angelEmbeddedEra/rusefi-sti-2004/documents/2004 Pin out.jpeg

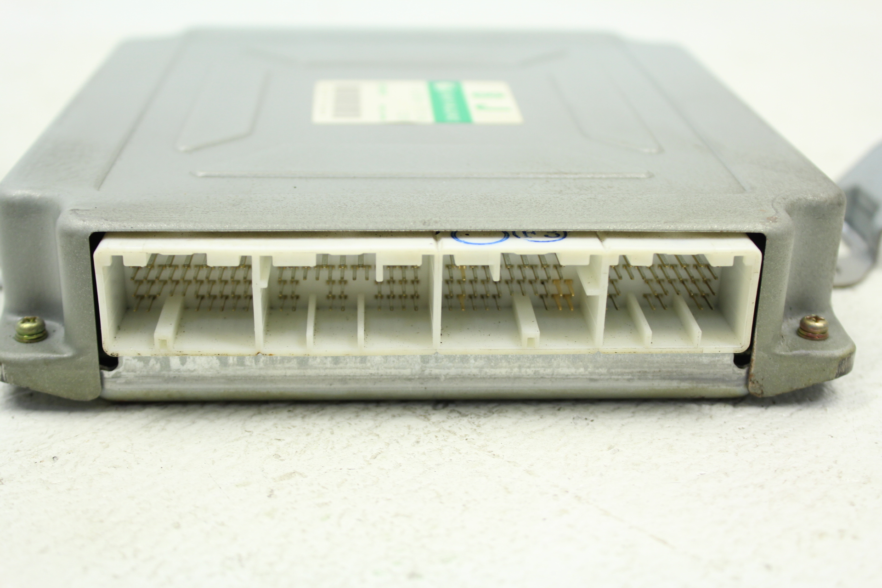
documents/2004 Pin out.jpeg
