angelEmbeddedEra/rusefi-sti-2004/README.md

# FAQ

Q: How do I build the board package?

A: ``hellen-create-board`` in this folder (EmbeddedEra/KiCad scripting/hellen; docker, KiCad 10). Output lands in ``boards/<board>-<rev>/``. There is no GitHub workflow.

Q: How do I get latest hellen-one?

A: ``git submodule update --remote hellen-one kicad6-libraries``, then rebuild and commit.

Q: I get error 'Cannot stat xx-yy__zz.kicad_pcb: No such file' but files are right there?

A: please do not use dashes and underscore symbols in file names.

Q: Automation says that aux_axis_origin is missing?

A: aux_axis_origin is required, please place it in the appropriate corner.

Q: I get "Cannot parse position" with negative value?

A: Please move origin point into left-bottom corner of the board since we cannot parse negative coordinates at the moment. See https://github.com/andreika-git/hellen-one/issues/349

Q: I am placing an order with JLCPCB and component orientation all looks wrong?!

A: See https://github.com/rusefi/uaefi/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

Q: What about firmware?

A: See https://github.com/rusefi/fw-custom-hellen144-f4 and https://github.com/rusefi/rusefi/wiki/Custom-Firmware

Q: Automation seems to work but files are not updated?

A: automation requires that you use default branch 'main'
