angelEmbeddedEra/rusefi-sti-2004/documents/pin-swap-m1.md

# M1 pin swap (owner-approved 2026-10-28)

Signals moved between equivalent Hellen mega-mcu144 module pins (same family only) to untangle routing:
75 ratsnest crossings → 0 on these families. **The rusEFI board pin mapping must follow this table.**

| Signal | Old module pin | New module pin |
|---|---|---|
| AC_RELAY | OUT_IO3 (E6) | OUT_IO5 (E7) |
| CRUISE_MAIN_LIGHT | OUT_IO5 (E7) | OUT_IO10 (E10) |
| CRUISE_SET_LIGHT | OUT_IO6 (E9) | OUT_IO9 (E11) |
| DIN_AUX1 | OUT_IO9 (E11) | OUT_IO8 (E22) |
| DIN_AUX2 | OUT_IO10 (E10) | OUT_IO7 (E23) |
| DIN_DEFOG | IO5 (N23) | IO1 (N16) |
| DIN_TEST_MODE | OUT_IO13 (E20) | OUT_IO4 (E21) |
| ETB_DIR | IO1 (N16) | IO3 (N21) |
| ETB_DIS | IO2 (N19) | IO5 (N23) |
| ETB_PWM | OUT_PWM2 (E17) | OUT_PWM7 (E25) |
| FAN_RELAY_1 | OUT_INJ6 (E32) | OUT_INJ1 (E19) |
| FAN_RELAY_2 | OUT_INJ7 (E33) | OUT_INJ2 (E18) |
| FP_CMD | IGN5 (W7) | IGN4 (W8) |
| INJ1 | OUT_INJ1 (E19) | OUT_INJ6 (E32) |
| INJ2 | OUT_INJ2 (E18) | OUT_INJ4 (E30) |
| INJ3 | OUT_INJ3 (E29) | OUT_INJ5 (E31) |
| INJ4 | OUT_INJ4 (E30) | OUT_INJ7 (E33) |
| MAIN_RELAY | OUT_INJ5 (E31) | OUT_INJ3 (E29) |
| MIL | OUT_IO1 (E8) | OUT_IO6 (E9) |
| O2_HEATER_REAR | OUT_IO2 (E12) | OUT_IO12 (E13) |
| OUT_IGN1 | IGN1 (W11) | IGN7 (W5) |
| OUT_IGN2 | IGN2 (W10) | IGN5 (W7) |
| OUT_IGN4 | IGN4 (W8) | IGN1 (W11) |
| PURGE | OUT_PWM7 (E25) | OUT_PWM2 (E17) |
| SPARE_IGN7 | IGN7 (W5) | IGN2 (W10) |
| SPARE_LS1 | OUT_IO7 (E23) | OUT_IO1 (E8) |
| SPARE_LS2 | OUT_IO8 (E22) | OUT_IO3 (E6) |
| SPARE_PWM3 | OUT_PWM3 (E16) | OUT_PWM1 (E27) |
| TACH | OUT_IO4 (E21) | OUT_IO2 (E12) |
| TGV_DIR | IO3 (N21) | IO2 (N19) |
| TGV_PWM | OUT_IO12 (E13) | OUT_IO13 (E20) |
| WG | OUT_PWM1 (E27) | OUT_PWM3 (E16) |

Generated by eeroute `tools/pin_swap.py --occupied-only` and applied with `tools/apply_pin_swap.py`.

## Routing result (eeroute, 2026-10-29)

The 32 moved nets were ripped and re-routed by eeroute (`--plan grid --ripup-plan yes --passes 2`,
teardrops on new vias, finishing pass). Same nets, same router, same settings:

| Board | Open connections on these 32 nets |
|---|---|
| Unswapped (master pinout, nets ripped) | 22 |
| Swapped (this branch) | **7** |
| Master as hand-finished | 8 |

No other net got worse and there is no new DRC finding versus the ripped start. Whole-board DRC
unconnected items: master 123, this branch 102. After a clean-up pass (via minimisation: 3 layer-change vias replaced by single-layer
paths) and one more short routing pass: **6 open** on these nets (PURGE now routed), whole-board
unconnected items 101; still open: DIN_DEFOG, O2_HEATER_REAR, OUT_IGN2, SPARE_LS1, SPARE_LS2, TACH. Ten new vias next to module keep-clear areas
on In3 have teardrops off (a teardrop there would violate the keep-clear).
