angelEmbeddedEra/rusefi-sti-2004/documents/ROUTING-PLAN.md

# Routing plan: rusefiSTI2004 rev B

Status 2026-10-14: placed, planes poured, stage 2 (high-current) routed. **156 connections to route** (233 counting Hellen module pad pairs), DRC 0 errors, schematic parity 0.
Procedure: SOP-021 step 9 (routing order). This file is the board-specific part: which nets, which layer, which width, in which order.

## Ground rules

- **Stackup (6 layers since 2026-10-14, owner):** JLC06161H-7628, 1.6 mm (`kicad-stackup JLC06161H-7628`).
  - L1 (F.Cu): parts and signals.
  - L2 (In1.Cu): solid GND. **Never route on L2.**
  - L3 (In2.Cu): mixed: signals plus a +12V_RAW pour. +12V_RAW is routed as tracks, so the pour is a bonus.
  - L4 (In3.Cu): signals (added when 44 connections around M1 would not fit on three layers).
  - L5 (In4.Cu): solid GND, the reference for the bottom layer.
  - L6 (B.Cu): signals.
  - Every Hellen module outline has a keepout on In3/In4 for tracks and pour: the module's own vias drill through all six layers in the merged board and are not in our KiCad file. Vias stay allowed (they already were on four layers).
  - `hellen-create-board` must map the modules' two inner layers to In1/In2 and pass In3/In4 straight through (the hellen-one merge only knew four layers).
- **45 degree corners only, never 90.**
  - Keep the router in its 45° posture (the default; `/` toggles posture and `Ctrl+/` the corner style), with free-angle mode off.
  - The design rule `45 degree corners only` (track_angle min 135) makes any bend sharper than 135° between connected segments a DRC error, so a 90° corner fails the gate.
- **Teardrops always.**
  - Every copper pad and via has curved teardrops switched on (Board Setup > Teardrops, plus the per-item flag `kicad-pcb-from-netlist` sets), including at track-width changes.
  - Before each stage's commit, `kicad-cli pcb drc --refill-zones --save-board` rebuilds them headless (kicad-autoroute does this on its last check); in the editor, Edit > Edit Teardrops does the same.
- **Track widths come from the net classes.** Use the router's net-class width, not a hand-typed one:

  | Class | Width | Via | Typical nets |
  |---|---|---|---|
  | Default | 0.20 mm | 0.6/0.3 | on-board logic |
  | Signal_Robust | 0.25 mm | 0.6/0.3 | sensor, switch and harness signals |
  | Power_500mA | 0.40 mm | 0.7/0.35 | low-current rails |
  | Power_1A | 0.60 mm | 0.8/0.4 | injectors, solenoids |
  | Power_2A | 1.00 mm | 1.0/0.5 | heaters |
  | Power_3A | 1.25 mm | 1.0/0.5 | TGV motors |
  | Power_5A | 2.50 mm | 1.2/0.6 | ETB motor, main 12 V |
  | Ground | 0.50 mm stubs into the planes | 0.8/0.4 | GND |
  | USB2 | 0.20 mm | 0.6/0.3 | USB D+/D- |

- **Placement moves when routing needs it.** Never neck a trace down or detour it to get past a part: nudge the part instead (passives, drivers, test pads). Connectors, mounting holes and the Hellen modules stay fixed. Put the new position in `pcb_place.json` (`fixed`) so a rerun keeps it, and run `kicad-pcb-from-netlist --keep-placed` after any schematic change; it keeps the tracks, vias and pours.
- **Every net has a rule.** A net class through a pattern in the `.kicad_pro`, plus a DRC rule for analog or noisy nets (for example `On-board MAP keep-away`). In the `.kicad_dru`, lengths need the unit (`0.5mm`); a bare number silently disables the whole file. After any rules edit, append a 5 mm clearance probe, check that the errors explode, then remove it.
- **Commit and push after every step below.** One commit per step, with a message naming the step and the DRC result, so a bad step can be reverted on its own.
- **Gate for every step:**
  - `kicad-cli pcb drc --refill-zones` shows 0 errors.
  - Schematic parity stays at 0.
  - Note the unconnected count in the commit message.

## Steps

Each step lists its nets, then its rules.

### 0. Before the first track

Done 2026-10-14.

- **Enclosure:** 3D printed, designed around the board afterwards (SOP-024), so the board sets the positions: H1-H4 stay at the corners right of J1, and the lid gets a hole or grommet above U20 for the MAP hose.
- **Stackup:** JLC04161H-7628 (1.6 mm; 35 um outer, 15.2 um inner copper; 0.2104 mm 7628 prepreg, 1.065 mm core), put in with `kicad-stackup JLC04161H-7628`, from the community generator github.com/gsuberland/jlcpcb_autogenerated_stackups. Order it with "FR-4 TG155" for impedance control.
- **Anchors locked:** J1-J3, H1-H4 and every Hellen module (`"locked"` in `pcb_place.json`; `kicad-nudge` never moves a locked part).

### 1. Plane fan-out

Done 2026-10-14 with `autoroute.py fanout BOARD 'GND,+12V_RAW'` (66 vias: every SMD pad on a plane net gets a stub and a via, two on big pads, never inside a Hellen module). J1 pin 120 (+12V_RAW) sits inside the J1 pin field where neither a 1.2 mm via nor the plane fits, so it is tied to its neighbour pin 119 with a 1.25 mm +12V_RAW track on In2. DRC 0 errors, unconnected 324 -> 318, +12V_RAW fully connected.
- What still shows as GND unconnected is pad-to-pad inside one Hellen module (the module draws its GND pads per layer; its own copper joins them at the Hellen merge), plus one B.Cu pour scrap by J1 pin 63, left for step 9 (stitching).

**Nets and layers:**
- Every GND pad gets a via to L2: the VNLD sources (pins 5 and 7), module GND pins, connector GND and passive GND ends.
- Every +12V_RAW pad gets a via to L3.

**Rules:**
- Put the via right at the pad, one per pad, two per power pad.
- Use the class via sizes (Ground 0.8/0.4, Power_5A 1.2/0.6).

### 2. High-current paths

Done 2026-10-14 with `kicad-autoroute` at `--width-max 0.8` (the widest track that passes between J1 pins, 1.2 mm gap), then `kicad-nudge` and `--widen-only`. All 7 nets routed (checked per net), DRC 0 errors, no bend under 135 degrees.
- Correction: the first pass (2026-10-13, commit bd881db) left OUT_ETB+ and OUT_TGV_OPEN unrouted; the summary only counted errors.
- U20 (on-board MAP) first sat in the ETB corridor and blocked it; it moved to the gap east of M2.
- Parts nudged off the wide tracks: F3, F4, P2, P4, R33, R34, R36, R37 (positions in `pcb_place.json`).
- Width reached (share of length at full class width): +12V_ETB 53%, OUT_ETB+ 52%, OUT_ETB- 32% (2.5 mm class); TGV open/close 62%/59% (1.25 mm); WBO heater 48%, rear O2 heater 73% (1.0 mm). Nearly all of the rest is the neck inside the J1 pin field and at the Hellen module edges, which do not move.
- ETB necks doubled on the other layer where it fits (`autoroute.py mirror`): 27 mm in 5 runs, 10 vias. What is left necked is inside the J1 pin field, where neither layer has room for a tie-back via. At 0.8 mm (about 2.5 A on 35 um outer copper) that carries the ETB motor's 1-2 A running current and its short peaks.
- Open: run Edit > Edit Teardrops in the GUI.
- To redo: rip the nets, then `kicad-autoroute 'OUT_ETB+,OUT_ETB-,+12V_ETB,OUT_TGV_OPEN,OUT_TGV_CLOSE,WBO_HEATER,OUT_O2_HEATER_REAR' --width-max 0.8 --passes 25`, `kicad-nudge` the same nets, then `kicad-autoroute` the same nets with `--widen-only`.

**Nets and layers:**

| Path | From → to | Class |
|---|---|---|
| OUT_ETB+, OUT_ETB-, +12V_ETB | J1 pins 4/5/6 → M2 (motor driver) | Power_5A |
| OUT_TGV_OPEN, OUT_TGV_CLOSE | J1 pins 109-112 → M9 | Power_3A |
| WBO_HEATER | J1 pins 103/104 → M3 | Power_2A |
| OUT_O2_HEATER_REAR | J1 pin 68 → Q16 drain and its spreader | Power_2A |

**Rules:**
- Keep these short and straight, on L1, mirrored on L4 where width runs out.
- Use several vias at every layer change.
- Neck down only at the pad.

### 3. Low-side outputs

Done 2026-10-14. All 19 OUT_* drains (J1 -> VNLD5160 / NCV8401B) at class width, and all 20 driver inputs (pull-down -> M1).
- The inputs did not fit at first: M1's east edge carries 34 signals and sat 2.15 mm from the board edge, so the board grew 6 mm to the right (now 144.6 x 113.6 mm); J2 and its USB parts, H2 and H4 moved with the edge.
- J1 pin 63 (GND) is tied to pin 64 on In1 (the plane cannot flow into the J1 pin field); J3 pin 14 got its own fan-out vias after WG cut its pour spokes, and WG was rerouted around it.
- Teardrops are written headless (`kicad-cli pcb drc --refill-zones --save-board`, also at the end of every `kicad-autoroute` run): 424 on the board.
- DRC 0 errors, no bend under 135 degrees, no net worse than before (per-net guard), unconnected 274 (about 45 of them are pad pairs inside a Hellen module, joined by the module's copper at the merge).

**Nets and layers:**
- The 19 OUT_* nets (injectors, relays, solenoids, lamps, tach, spares): J1 pin to its VNLD5160 drain (pins 6 or 8).
- The driver inputs (INJ1-4, MAIN_RELAY …): from the 4.7k pull-down at the driver to the M1 module pin.

**Rules:**
- Drains go on L1, short, in Power_1A or Power_500mA width.
- Each VNLD source pair (5/7) is stitched straight down to L2.
- Inputs are Default width, on L4 under the bank.

### 4. Sensitive analog

Done 2026-10-14. All 34 analog nets (crank VR and conditioned, cams, knock, wideband, MAF/MAP/IAT/ECT, TPS, pedal, TGV position, fuel level, VSS, on-board MAP, sensor supplies and returns), routed on F.Cu, In2.Cu and B.Cu.
- The two outer layers were not enough (M1's south edge and the J1 pin field), so In2 became a mixed layer (owner): signals plus a +12V_RAW pour. +12V_RAW was routed as tracks first (step 5a, 0 opens with the pour removed), so no In2 signal can cut 12 V off.
- On the way: J1 pads and every via had lost their trimmed inner rings on `--keep-placed` rebuilds (fixed in the tool and on the board), and the router had been seeing all of them as full rings on In2.
- The 2 mm spacing in the plan was not met at this density: `spacing.py` finds 28 nets closer than 2 mm somewhere to a power or driver track. Coupled runs within 1 mm of a switching output, longest: TGV position LH 22 mm beside ETB-, cam 17 mm beside VVT LH and 14 mm beside INJ3, VSS 11 mm beside VVT LH, conditioned crank 8 mm beside TGV open, IAT 8 mm beside VVT RH; the rest are short. These are digital (cam, VSS, crank after M5) or slow filtered signals. Rerouting them with 0.8 mm extra clearance left four unroutable, so they stay as routed. The VR pair and knock raw run inside the J1 field or alone.
- DRC 0 errors, no net worse (per-net guard), real opens 156 (unconnected 233 including Hellen module pad pairs).

**Nets and layers:**

| Signal | From → to | Notes |
|---|---|---|
| Crank VR IN_CRANK+ / IN_CRANK- | J1 pins 76/88 → M5 | route as a pair; shield B31 to GND at the J1 end only |
| On-board MAP IN_MAP_ONBOARD | U20 pin 4 → M1 S19 (test pad P28 on the way) | C1 tight to U20 pins 2/3; keep it over L2 |
| Knock IN_KNOCK_RAW | J1 pin 56 → M13 | keep away from the injector and coil traces |
| Wideband WBO_IP / WBO_UN / WBO_VM / WBO_RTRIM | J1 pins 126/127/134 → M3 | through the fitted option links |
| Sensors IN_MAF, IN_MAP, IN_IAT, IN_ECT, IN_TPS_*, IN_PPS_* | J1 → M1 | Signal_Robust |
| GND_SENSOR | J1 → JP8 | Power_500mA |
| Sensor 5 V supplies +5VAS, APS_PS_5V | J1 → power modules | |

**Rules:**
- Keep this whole group over unbroken L2 ground.
- No vias through the +12V_RAW plane next to the VR or knock traces.
- Keep it 2 mm or more from the step 2 and step 3 copper.

### 5. Differential and comms

Not started.

**Nets and layers:**
- USB_D+ / USB_D-: J2 → U1 (ESD) → M1.
- CAN_H / CAN_L: M1 → J1, J3 and M3.
- K_LINE: M10 → J1 pin 20.

**Rules:**
- **USB:** route as a 90 Ω differential pair, sized from the JLC calculator for the chosen stackup. Keep it on L1 over L2 with no vias, and match the lengths to 0.15 mm.
- **CAN:** route as a loosely coupled pair, 0.25 mm wide.
- **K-line:** Signal_Robust.

### 6. Switch and digital inputs

Not started.

**Nets and layers:**
- The IN_* switch inputs: from the J1 pin, past its pull resistor in the column beside J1, to the M1 / M11 / M12 module pin.
- The DIN_* lines from the dinput4 modules to M1.

**Rules:**
- Signal_Robust from J1 to the pull resistor, then Default on to the module.
- Run them on L4 as a bus wherever possible.

### 7. Low-current rails

Not started.

**Nets and layers:** +5V, +5VA, +3.3V, +3.3VA, +12V, +12V_IGN, +12V_BACK_UP, AUX_12V, AUX_5V, PWR_EN and PG_5VP.

**Rules:**
- Power_500mA / Power_1A width.
- Tree from the power modules (M14, M8) to each load.
- No daisy chains through dense areas.

### 8. Everything left

Not started.

**Nets and layers:** about 100 Default connections: test pads, option links, spare pads, BOOT0 and so on.

**Rules:**
- Route them by hand.
- Or use Freerouting, the KiCad community autorouter: export Specctra DSN with steps 1-7 locked, route only the unrouted nets, import the SES, then clean up.
- Never let it touch the locked tracks.

### 9. Finish

Not started.

**Nets and layers:** all pours and the whole board.

**Rules:**
- Refill all zones and add stitching vias along the board edge and around the driver bank.
- Gates:
  - unconnected must be 0
  - DRC must have 0 errors
  - `hellen-create-board` builds the package
- Then review the Gerbers and the 3D view.
- Then SOP-021 steps 10-13: second-person review, `fab.yml`, tag `hw/rusefi-sti-2004/B`.

## Connections left by class (2026-10-13)

| Class | Connections | Nets |
|---|---|---|
| Default | 100 | 69 |
| Signal_Robust | 90 | 55 |
| Power_500mA | 51 | 18 |
| Ground | 43 | 1 (most GND pads already reach a plane) |
| Power_1A | 19 | 14 |
| USB2 | 8 | 2 |
| Power_5A | 7 | 4 |
| Power_2A | 4 | 2 |
| Power_3A | 4 | 2 |
