angelEmbeddedEra/rusefi-sti-2004/documents/STI2004-pinout-check.xlsx

Sheet: Summary
Status | Pins | Meaning
OK | 99 | Car pin is wired to the expected net and reaches a module or rail
MISMATCH | 0 | Wired, but to the wrong signal
LABEL ONLY | 0 | Net has the right name but stops at J1: not connected to the MCU
NOT WIRED | 3 | Car uses the pin; the schematic leaves it unconnected
CHECK | 0 | Needs a look (unused car pin connected, or no expectation defined)
unused | 33 | Car does not use the pin and the schematic leaves it open
Built by | tools/pinout_check.py | Re-run after any schematic change
Car data | documents/oem-ecm-pinout-2004-sti.csv | Transcribed from the FSM pages in Source
Schematics | current | Status judged on the last one

Sheet: Pinout check
J1 pin | Car plug | Term. | Code | Function (FSM) | Signal type | Key on (V) | Idle (V) | Source | Your sheet | Net: current | Reaches (current) | Status | Notes
1 | B137 | 1 | D1 | GND (control systems) | ground | 0 | 0 | EN(STi)-20 |  | GND | rail | OK
2 | B137 | 2 | D2 | GND (control systems) | ground | 0 | 0 | EN(STi)-20 |  | GND | rail | OK
3 | B137 | 3 | D3 | Electric throttle GND (sensor) | sensor ground | 0 | 0 | EN(STi)-21 |  | GND | rail | OK | Harness side is grounded at engine ground GE-1 (WI-77)
4 | B137 | 4 | D4 | Electric throttle motor (-) | H-bridge output | duty | duty | EN(STi)-21 | OUT_ETB- | OUT_ETB- | M2.OUT-_S2 | OK | 500 Hz
5 | B137 | 5 | D5 | Electric throttle motor (+) | H-bridge output | duty | duty | EN(STi)-21 | OUT_ETB+ | OUT_ETB+ | M2.OUT+_S3 | OK | 500 Hz
6 | B137 | 6 | D6 | Electric throttle motor power supply | 12 V in (from ETB relay) | 2026-10-13 | 13-14 | EN(STi)-21 |  | +12V_ETB | M2.12V_IN_N2; M2.12V_IN_S1 | OK
7 | B137 | 7 | D7 | GND (injectors) | ground | 0 | 0 | EN(STi)-20 |  | GND | rail | OK
8 | B137 | 8 | D8 | Starter switch | digital in (12 V) | 0 | 0 | EN(STi)-19 |  | IN_STARTER_SWITCH | M1.IN_SENS2_S8; R30.1 | OK | Cranking: 8-14
9 | B137 | 9 | D9 | Neutral position switch | digital in (12 V) | ON 10-13 / OFF 0 | ON 13-14 / OFF 0 | EN(STi)-19 |  | IN_NEUTRAL_SWITCH | M1.IN_AUX2_S12; R44.1 | OK
10 | B137 | 10 | D10 | Power steering oil pressure switch | digital in (to ground) | 2026-10-13 | ON 0 / OFF 13-14 | EN(STi)-20 | IN_PS_PRESSURE_SWIITCH | DIGITAL 12-0 OFF ON | IN_PS_PRESSURE_SWITCH | M1.IN_AUX3_S11 | OK
11 | B137 | 11 | D11 | Rear defogger switch | digital in (to ground) | ON 0 / OFF 10-13 | ON 0 / OFF 13-14 | EN(STi)-20 |  | IN_DEFOG | M11.IN_D1_V2; R51.1 | OK
12 | B137 | 12 | D12 | Small light switch | digital in (to ground) | ON 0 / OFF 10-13 | ON 0 / OFF 13-14 | EN(STi)-20 |  | IN_SMALL_LIGHT | M11.IN_D2_V3; R52.1 | OK
13 | B137 | 13 | D13 | Blower fan switch | digital in (to ground) | ON 0 / OFF 10-13 | ON 0 / OFF 13-14 | EN(STi)-20 |  | IN_BLOWER | M11.IN_D3_V4; R53.1 | OK | Also shown to auto A/C module (WI-106)
14 | B137 | 14 | D14 | Test mode connector | digital in (5 V pull-up) | 5 | 5 | EN(STi)-19 |  | IN_TEST_MODE | M11.IN_D4_V5 | OK | When connected: 0
15 | B137 | 15 | D15 | Ignition switch | 12 V switched in | 2026-10-13 | 13-14 | EN(STi)-19 |  | +12V_IGN | M14.IN_VIGN_V2; M8.IN_VIGN_V2 | OK
16 | B137 | 16 | D16 | A/C switch | digital in (12 V) | ON 10-13 / OFF 0 | ON 13-14 / OFF 0 | EN(STi)-19 |  | IN_AC_REQUEST | M1.IN_SENS3_S7; R31.1 | OK
17 | B137 | 17 | D17 | Main relay control | low-side output (relay) |  |  | WI-106 |  | OUT_MAIN_RELAY | U12.D_8 | OK | Not in the I/O table; wiring diagram shows D17 to the main relay coil
18 | B137 | 18 | D18 | (not used) |  |  |  |  |  |  |  | unused
19 | B137 | 19 | D19 | (not used) |  |  |  |  |  |  |  | unused
20 | B137 | 20 | D20 | SSM/GST communication line | K-line serial | <1 <-> >4 | <1 <-> >4 | EN(STi)-20 |  | K_LINE | JP4.2; M10.LIN_V4; P8.1_1 | OK
21 | B137 | 21 | D21 | (not used) |  |  |  |  |  |  |  | unused
22 | B137 | 22 | D22 | (not used) |  |  |  |  |  |  |  | unused
23 | B137 | 23 | D23 | (not used) |  |  |  |  |  |  |  | unused
24 | B137 | 24 | D24 | Blow-by leak diagnosis signal | digital in | 0 | 0 | EN(STi)-20 |  | IN_BLOWBY | M12.IN_D4_V5 | OK | Disconnected (fault): 5
25 | B137 | 25 | D25 | Rear oxygen sensor signal | analog in (narrowband O2) | 0 | 0-0.9 | EN(STi)-18 |  | IN_O2S | M1.IN_O2S_S16 | OK
26 | B137 | 26 | D26 | (not used) |  |  |  |  |  |  |  | unused
27 | B137 | 27 | D27 | (not used) |  |  |  |  |  |  |  | unused
28 | B137 | 28 | D28 | Fuel pump control unit signal 2 | 12 V to FPCU | 2026-10-13 | 13-14 | EN(STi)-19 |  | FP_STATUS | JP7.1; P12.1_1 | OK
29 | B137 | 29 | D29 | (not in I/O table) |  |  |  | WI-112 |  | DLC6_D29 | JP4.1; P13.1_1 | OK | Red/white wire to data link connector pin 6 (WI-112); function not in the I/O table. Leave unconnected.
30 | B137 | 30 | D30 | (not used) |  |  |  |  |  |  |  | unused
31 | B137 | 31 | D31 | Rear oxygen sensor shield | shield | 0 | 0 | EN(STi)-18 |  | GND | rail | OK
32 | B136 | 1 | C1 | (not used) |  |  |  |  |  |  |  | unused
33 | B136 | 2 | C2 | (not used) |  |  |  |  |  |  |  | unused
34 | B136 | 3 | C3 | Fuel injector #4 | injector low-side | 2026-10-13 | 2026-01-14 | EN(STi)-19 |  | OUT_INJ4 | U11.D_6 | OK
35 | B136 | 4 | C4 | Fuel injector #3 | injector low-side | 2026-10-13 | 2026-01-14 | EN(STi)-19 |  | OUT_INJ3 | U11.D_8 | OK
36 | B136 | 5 | C5 | Fuel injector #2 | injector low-side | 2026-10-13 | 2026-01-14 | EN(STi)-19 |  | OUT_INJ2 | U10.D_6 | OK
37 | B136 | 6 | C6 | Fuel injector #1 | injector low-side | 2026-10-13 | 2026-01-14 | EN(STi)-19 |  | OUT_INJ1 | U10.D_8 | OK
38 | B136 | 7 | C7 | Cruise main switch | digital in (12 V) | ON 10-13 / OFF 0 | ON 13-14 / OFF 0 | EN(STi)-22 |  | IN_CRUISE_MAIN | M1.IN_D1_S4; R35.1 | OK
39 | B136 | 8 | C8 | Brake switch 2 | digital in (12 V) | pressed 10-13 / released 0 | pressed 13-14 / released 0 | EN(STi)-22 |  | IN_BRAKE_SW2 | M1.IN_SENS4_S6; R32.1 | OK
40 | B136 | 9 | C9 | Brake switch 1 | digital in (to ground) | pressed 0 / released 10-13 | pressed 0 / released 13-14 | EN(STi)-21 |  | IN_BRAKE_SW1 | M1.IN_O2S2_S15; R34.1 | OK
41 | B136 | 10 | C10 | RESUME/ACCEL switch | digital in (12 V) | ON 10-13 / OFF 0 | ON 13-14 / OFF 0 | EN(STi)-22 |  | IN_CRUISE_RESUME | M1.IN_D3_S2; R36.1 | OK
42 | B136 | 11 | C11 | SET/COAST switch | digital in (12 V) | ON 10-13 / OFF 0 | ON 13-14 / OFF 0 | EN(STi)-21 |  | IN_CRUISE_SET | M1.IN_D4_S1; R37.1 | OK
43 | B136 | 12 | C12 | Fuel temperature sensor signal | analog in (thermistor) | 2.5-3.8 | 2.5-3.8 | EN(STi)-20 |  |  |  | NOT WIRED | At 25 C
44 | B136 | 13 | C13 | Intake air temperature sensor signal | analog in (thermistor) | 0.3-4.6 | 0.3-4.6 | EN(STi)-18 |  | IN_IAT | M1.IN_IAT_S26 | OK | In the MAF housing
45 | B136 | 14 | C14 | Engine coolant temperature sensor signal | analog in (thermistor) | 1.0-1.4 | 1.0-1.4 | EN(STi)-18 |  | IN_ECT | M1.IN_CLT_S28 | OK | After warm-up
46 | B136 | 15 | C15 | Accelerator position sensor power supply | 5 V sensor supply out | 5 | 5 | EN(STi)-21 |  | APS_PS_5V | JP12.1; M8.5VP_V4 | OK
47 | B136 | 16 | C16 | Sensor power supply | 5 V sensor supply out | 5 | 5 | EN(STi)-19 | 5v OUT SENSOR_PS_5V | +5VAS | F7 -> AUX_5V -> J3.Pin_3_3; JP12.2; M14.5VP_V4 | OK | Feeds throttle TPS; MAP; TGV sensors
48 | B136 | 17 | C17 | Accelerator position sensor main | analog in | closed 1 / open 3.5 | closed 1 / open 3.5 | EN(STi)-21 | IN_APS_MAIN | IN_PPS_MAIN | M1.IN_PPS_S31 | OK
49 | B136 | 18 | C18 | Electric throttle main (TPS1) | analog in | 0.64-0.72 / open 3.96 | 0.64-0.72 | EN(STi)-21 | IN_TPS_MAIN | IN_TPS_MAIN | M1.IN_TPS_S30 | OK
50 | B136 | 19 | C19 | (not used) |  |  |  |  |  |  |  | unused
51 | B136 | 20 | C20 | Fuel level sensor | analog in | 0.12-4.75 | 0.12-4.75 | EN(STi)-20 |  | IN_FUEL_LEVEL | M1.IN_AT1_S27; R45.1 | OK
52 | B136 | 21 | C21 | Fuel tank pressure sensor signal | analog in | 2.3-2.7 | 2.3-2.7 | EN(STi)-20 |  |  |  | NOT WIRED
53 | B136 | 22 | C22 | Manifold absolute pressure sensor signal | analog in | 1.7-2.4 | 1.1-1.6 | EN(STi)-20 |  | IN_MAP | M1.IN_MAP1_S21 | OK
54 | B136 | 23 | C23 | Mass air flow sensor signal | analog in | - | 0.3-4.5 | EN(STi)-18 |  | IN_MAF | M1.IN_SENS1_S9 | OK
55 | B136 | 24 | C24 | (not used) |  |  |  |  |  |  |  | unused
56 | B136 | 25 | C25 | Knock sensor signal | knock in | 2.8 | 2.8 | EN(STi)-19 |  | IN_KNOCK_RAW | M13.IN_KNOCK_W1 | OK
57 | B136 | 26 | C26 | Tumble generator valve position sensor LH | analog in | closed 3.8-4.9 / open 0.2-0.9 | same | EN(STi)-19 | IN_TUMBLE_SENSOR_LH | IN_TUMBLE_SENSOR_LH | M1.IN_MAP2_S20 | OK
58 | B136 | 27 | C27 | Tumble generator valve position sensor RH | analog in | closed 3.8-4.9 / open 0.2-0.9 | same | EN(STi)-19 | IN_TUMBLE_SENSOR_RH | IN_TUMBLE_SENSOR_RH | M1.IN_RES2_S14 | OK
59 | B136 | 28 | C28 | Accelerator position sensor sub | analog in | closed 1 / open 3.5 | closed 1 / open 3.5 | EN(STi)-21 | IN_APS_SUB | IN_PPS_SUB | M1.IN_PPS2_S33 | OK
60 | B136 | 29 | C29 | Electric throttle sub (TPS2) | analog in | 1.51-1.58 / open 4.17 | 1.51-1.58 | EN(STi)-21 | IN_TPS_SUB | IN_TPS_SUB | M1.IN_TPS2_S32 | OK
61 | B136 | 30 | C30 | (not used) |  |  |  |  |  |  |  | unused
62 | B136 | 31 | C31 | Mass air flow sensor GND | sensor ground | 0 | 0 | EN(STi)-18 |  | GND_SENSOR | J3.Pin_4_4; JP8.1; JP9.1 | OK
63 | B136 | 32 | C32 | Mass air flow sensor shield | shield | 0 | 0 | EN(STi)-18 |  | GND | rail | OK
64 | B136 | 33 | C33 | Knock sensor shield | shield | 0 | 0 | EN(STi)-19 |  | GND | rail | OK
65 | B136 | 34 | C34 | Accelerator position sensor GND (sensor) | sensor ground | 0 | 0 | EN(STi)-21 | APS_GND | GND_SENSOR | J3.Pin_4_4; JP8.1; JP9.1 | OK
66 | B136 | 35 | C35 | GND (sensor) | sensor ground | 0 | 0 | EN(STi)-18 |  | GND_SENSOR | J3.Pin_4_4; JP8.1; JP9.1 | OK | Return for ECT; rear O2; TGV; MAP; fuel tank pressure
67 | B135 | 1 | B1 | GND (power supply) | ground | 0 | 0 | EN(STi)-20 |  | GND | rail | OK
68 | B135 | 2 | B2 | Rear oxygen sensor heater signal | heater low-side | 0-1.0 | - | EN(STi)-18 |  | OUT_O2_HEATER_REAR | Q16.D_2 | OK
69 | B135 | 3 | B3 | (not used) |  |  |  |  |  |  |  | unused
70 | B135 | 4 | B4 | GND (power supply) | ground | 0 | 0 | EN(STi)-20 |  | GND | rail | OK
71 | B135 | 5 | B5 | Control unit power supply | 12 V in (main relay) | 2026-10-13 | 13-14 | EN(STi)-19 | 12V IN | +12V_RAW | rail | OK
72 | B135 | 6 | B6 | Control unit power supply | 12 V in (main relay) | 2026-10-13 | 13-14 | EN(STi)-19 | 12V IN | +12V_RAW | rail | OK
73 | B135 | 7 | B7 | (not used) |  |  |  |  |  |  |  | unused
74 | B135 | 8 | B8 | Camshaft position sensor (LH) | cam sensor in | 0-0.9 | ON 0 / OFF 4.7-5.3 | EN(STi)-21 | Sensor output waveform | IN_CAM | M1.IN_CAM_S24; R42.1 | OK
75 | B135 | 9 | B9 | Camshaft position sensor (RH) | cam sensor in | 0-0.9 | ON 0 / OFF 4.7-5.3 | EN(STi)-21 | Sensor output waveform | IN_CAM_RH | M1.IN_AUX1_S13; R43.1 | OK
76 | B135 | 10 | B10 | Crankshaft position sensor signal (+) | VR in | 0 | -7 to +7 | EN(STi)-18 | Sensor output waveform | IN_CRANK+ | M5.VR+_W2 | OK
77 | B135 | 11 | B11 | (not used) |  |  |  |  |  |  |  | unused
78 | B135 | 12 | B12 | GND (ignition system) | ground | 0 | 0 | EN(STi)-20 |  | GND | rail | OK
79 | B135 | 13 | B13 | (not used) |  |  |  |  |  |  |  | unused
80 | B135 | 14 | B14 | (not used) |  |  |  |  |  |  |  | unused
81 | B135 | 15 | B15 | Ignition control #4 | igniter output | 0 | 13-14 | WI-107 |  | Vehicle connector/IGN4_COIL | F1 -> OUT_IGN4 -> M1.IGN4_W8 | OK | I/O table (EN(STi)-19) prints B135 16 for both #3 and #4; wiring diagram shows B15 to coil 4
82 | B135 | 16 | B16 | Ignition control #3 | igniter output | 0 | 13-14 | EN(STi)-19 |  | Vehicle connector/IGN3_COIL | F2 -> OUT_IGN3 -> M1.IGN3_W9 | OK
83 | B135 | 17 | B17 | Ignition control #2 | igniter output | 0 | 13-14 | EN(STi)-19 |  | Vehicle connector/IGN2_COIL | F3 -> OUT_IGN2 -> M1.IGN2_W10 | OK
84 | B135 | 18 | B18 | Ignition control #1 | igniter output | 0 | 13-14 | EN(STi)-19 |  | Vehicle connector/IGN1_COIL | F4 -> OUT_IGN1 -> M1.IGN1_W11 | OK
85 | B135 | 19 | B19 | Back-up power supply | 12 V permanent in | 2026-10-13 | 13-14 | EN(STi)-19 |  | +12V_BACK_UP | M14.V12_PERM_V1; M8.V12_PERM_V1 | OK | Ignition OFF: 10-13
86 | B135 | 20 | B20 | (not used) |  |  |  |  |  |  |  | unused
87 | B135 | 21 | B21 | (not used) |  |  |  |  |  |  |  | unused
88 | B135 | 22 | B22 | Crankshaft position sensor signal (-) | VR in | 0 | 0 | EN(STi)-18 | A/C relay control | IN_CRANK- | M5.VR-_W1 | OK
89 | B135 | 23 | B23 | (not used) |  |  |  |  |  |  |  | unused
90 | B135 | 24 | B24 | Radiator fan relay 2 control | low-side output (relay) | ON <=0.5 / OFF 10-13 | ON <=0.5 / OFF 13-14 | EN(STi)-19 |  | OUT_FAN_RELAY_2 | U13.D_8 | OK | Models with A/C only
91 | B135 | 25 | B25 | Radiator fan relay 1 control | low-side output (relay) | ON <=0.5 / OFF 10-13 | ON <=0.5 / OFF 13-14 | EN(STi)-19 |  | OUT_FAN_RELAY_1 | U12.D_6 | OK
92 | B135 | 26 | B26 | Fuel pump control unit signal 1 | output to FPCU (0/5 V) | 0 or 5 | 0 or 5 | EN(STi)-19 |  | FUEL_PUMP_SIGNAL1 | R39.2; R40.1; R41.1 | OK | Waveform
93 | B135 | 27 | B27 | Vehicle speed signal | digital in (pulse) | 0 or 5 | 0 or 5 | EN(STi)-18 | “5” and “0” are repeatedly displayed when vehicle is driven | IN_VSS | IN_VSS | M1.IN_VSS_S25 | OK
94 | B135 | 28 | B28 | (not used) |  |  |  |  |  |  |  | unused
95 | B135 | 29 | B29 | (not used) |  |  |  |  |  |  |  | unused
96 | B135 | 30 | B30 | (not used) |  |  |  |  |  |  |  | unused
97 | B135 | 31 | B31 | Crankshaft position sensor shield | shield | 0 | 0 | EN(STi)-18 |  | GND | rail | OK
98 | B135 | 32 | B32 | (not used) |  |  |  |  |  |  |  | unused
99 | B135 | 33 | B33 | A/C relay control | low-side output (relay) | ON <=0.5 / OFF 10-13 | ON <=0.5 / OFF 13-14 | WI-106 |  | OUT_AC_RELAY | U18.D_8 | OK | I/O table (EN(STi)-19) prints B133 33; wiring diagram shows B33 to the auto A/C module
100 | B135 | 34 | B34 | (not used) |  |  |  |  |  |  |  | unused
101 | B135 | 35 | B35 | Electric throttle motor relay | low-side output (relay) | ON 0 / OFF 10-13 | ON 0 / OFF 13-14 | EN(STi)-21 |  | OUT_ELECTRONIC_THROTTE_RELAY | U13.D_6 | OK | ON whenever the ignition is ON
102 | B134 | 1 | A1 | Clutch switch | digital in (to ground) | pressed 0 / released 10-13 | pressed 0 / released 13-14 | EN(STi)-21 | IN_CLT | IN_CLUTCH | M1.IN_RES1_S17; R33.1 | OK
103 | B134 | 2 | A2 | Front A/F sensor heater signal 2 | heater low-side | 0-1.0 | - | EN(STi)-18 |  | WBO_HEATER | M3.LSU_H+_E5; P5.1_1 | OK | Joined with A3 in the harness to A/F heater B18 pin 1 (WI-113); heater +12 V comes from the main relay
104 | B134 | 3 | A3 | Front A/F sensor heater signal 1 | heater low-side | 0-1.0 | - | EN(STi)-18 |  | WBO_HEATER | M3.LSU_H+_E5; P5.1_1 | OK | Joined with A2 in the harness to A/F heater B18 pin 1 (WI-113)
105 | B134 | 4 | A4 | (not used) |  |  |  |  |  |  |  | unused
106 | B134 | 5 | A5 | (not used) |  |  |  |  |  |  |  | unused
107 | B134 | 6 | A6 | GND (front A/F sensor heater 2) | ground | 0 | 0 | EN(STi)-20 |  | GND | rail | OK
108 | B134 | 7 | A7 | GND (front A/F sensor heater 1) | ground | 0 | 0 | EN(STi)-20 |  | GND | rail | OK
109 | B134 | 8 | A8 | Tumble generator valve RH (close) | TGV motor output | 0 or 10-13 | 0 or 13-14 | EN(STi)-19 |  | OUT_TGV_CLOSE | M9.OUT-_S2 | OK
110 | B134 | 9 | A9 | Tumble generator valve RH (open) | TGV motor output | 0 or 10-13 | 0 or 13-14 | EN(STi)-19 |  | OUT_TGV_OPEN | M9.OUT+_S3 | OK
111 | B134 | 10 | A10 | Tumble generator valve LH (close) | TGV motor output | 0 or 10-13 | 0 or 13-14 | EN(STi)-19 |  | OUT_TGV_CLOSE | M9.OUT-_S2 | OK
112 | B134 | 11 | A11 | Tumble generator valve LH (open) | TGV motor output | 0 or 10-13 | 0 or 13-14 | EN(STi)-19 |  | OUT_TGV_OPEN | M9.OUT+_S3 | OK
113 | B134 | 12 | A12 | Fuel tank pressure control solenoid valve | low-side output | ON <=1 / OFF 10-13 | ON <=1 / OFF 13-14 | EN(STi)-20 |  | EVAP_A12 | JP5.2 | OK
114 | B134 | 13 | A13 | Drain valve | low-side output | ON <=1 / OFF 10-13 | ON <=1 / OFF 13-14 | EN(STi)-20 |  | EVAP_A13 | JP6.2 | OK
115 | B134 | 14 | A14 | Purge control solenoid valve | low-side output | ON <=1 / OFF 10-13 | ON <=1 / OFF 13-14 | EN(STi)-20 |  | OUT_PURGE_CONTROL | U15.D_6 | OK
116 | B134 | 15 | A15 | Cruise main light | low-side output (lamp) | ON 0 / OFF 10-13 | ON 0 / OFF 13-14 | EN(STi)-21 |  | OUT_CRUISE_MAIN_LIGHT | U16.D_8 | OK
117 | B134 | 16 | A16 | Cruise control set light | low-side output (lamp) | ON 0 / OFF 10-13 | ON 0 / OFF 13-14 | EN(STi)-21 |  | OUT_CRUISE_SET_LIGHT | U16.D_6 | OK
118 | B134 | 17 | A17 | Malfunction indicator lamp | low-side output (lamp) | - | - | EN(STi)-20 |  | OUT_MIL | U17.D_8 | OK | ON <=1 / OFF 10-14
119 | B134 | 18 | A18 | AVCS (VVT) solenoid RH signal (+) | solenoid PWM (+) | ON 10-13 / OFF 0 | ON 13-14 / OFF 0 | EN(STi)-21 | OUT_VVT_RH+ | +12V_RAW | rail | OK
120 | B134 | 19 | A19 | AVCS (VVT) solenoid LH signal (+) | solenoid PWM (+) | ON 10-13 / OFF 0 | ON 13-14 / OFF 0 | EN(STi)-21 | OUT_VVT_LH+ | +12V_RAW | rail | OK
121 | B134 | 20 | A20 | (not used) |  |  |  |  |  |  |  | unused
122 | B134 | 21 | A21 | (not used) |  |  |  |  |  |  |  | unused
123 | B134 | 22 | A22 | (not in I/O table) wire to charging system |  |  |  | WI-111 |  | CHARGE_A22 | P11.1_1 | OK | Blue (L) wire to REF. TO CHG-01 (charging system); function not in the I/O table, likely alternator signal. Not spare: do not ground or drive it. Measure on the car.
124 | B134 | 23 | A23 | Engine speed output (tach) | tach output | - | 0-13 or more | EN(STi)-20 | OUT_TACH | OUT_TACH | R38.1; U17.D_6 | OK | Waveform
125 | B134 | 24 | A24 | Fuel tank sensor control valve | low-side output | ON <=1 / OFF 10-13 | ON <=1 / OFF 13-14 | EN(STi)-20 |  |  |  | NOT WIRED
126 | B134 | 25 | A25 | Front A/F sensor shield | shield | 0 | 0 | EN(STi)-20 |  | WBO_IP_J1 | JP3.2 | OK
127 | B134 | 26 | A26 | Front A/F sensor signal (-) | analog in (A/F) | 2.4-2.7 | 2.4-2.7 | EN(STi)-20 |  | WBO_VM_J1 | JP2.2 | OK | Denso 4-wire A/F sensor (plug B18 pin 4; WI-113); not a Bosch LSU
128 | B134 | 27 | A27 | (not used) |  |  |  |  |  |  |  | unused
129 | B134 | 28 | A28 | AVCS (VVT) solenoid RH signal (-) | solenoid return | 0 | 0 | EN(STi)-21 | OUT_VVT_RH- | OUT_VVT_RH- | U14.D_6 | OK
130 | B134 | 29 | A29 | AVCS (VVT) solenoid LH signal (-) | solenoid return | 0 | 0 | EN(STi)-21 | OUT_VVT_LH- | OUT_VVT_LH- | U15.D_8 | OK
131 | B134 | 30 | A30 | (not used) |  |  |  |  |  |  |  | unused
132 | B134 | 31 | A31 | (not used) |  |  |  |  |  |  |  | unused
133 | B134 | 32 | A32 | Wastegate control solenoid valve | low-side output (PWM) | 0 or 10-13 | 0 or 13-14 | EN(STi)-19 | OUT_WG Sensor output waveform 0 or 13 — 14v | OUT_WG | U14.D_8 | OK
134 | B134 | 33 | A33 | Front A/F sensor signal (+) | analog in (A/F) | 2.8-3.2 | 2.8-3.2 | EN(STi)-20 |  | WBO_UN_J1 | JP1.2 | OK | Denso 4-wire A/F sensor (plug B18 pin 3; WI-113); not a Bosch LSU
135 | B134 | 34 | A34 | (not in I/O table) | ground |  |  | WI-107 |  | GND | rail | OK | Wiring diagram joins A34 to the D1/D2 grounds
