angelEmbeddedEra/rusefi-sti-2004/documents/pinout-ECU.xlsx

Sheet: Sheet1
PCB CONNECTOR | Terminal No. | Connector No. |  | CONTENT
1 | 1 | B137 | D1 | GND (control systems)
2 | 2 | B137 | D2 | GND (control systems)
3 | 3 | B137 | D3 | Electric throttle GND (sensor)
4 | 4 | B137 | D4 | Electric throttle motor (−) | OUT_ETB-
5 | 5 | B137 | D5 | Electric throttle motor (+) | OUT_ETB+
6 | 6 | B137 | D6 | Electric throttle motor power supply
7 | 7 | B137 | D7 | GND (injectors)
8 | 8 | B137 | D8 | Starter switch
9 | 9 | B137 | D9 | Neutral position switch
10 | 10 | B137 | D10 | Power steering oil pressure switch | IN_PS_PRESSURE_SWIITCH | DIGITAL 12-0 OFF ON
11 | 11 | B137 | D11 | Rear defogger switch
12 | 12 | B137 | D12 | Small light switch
13 | 13 | B137 | D13 | Blower fan switch
14 | 14 | B137 | D14 | Test mode connector
15 | 15 | B137 | D15 | Ignition switch
16 | 16 | B137 | D16 | A/C switch
17 | 17 | B137 | D17 | MAIN RELAY
18 | 18 | B137 | D18
19 | 19 | B137 | D19
20 | 20 | B137 | D20 | SSM/GST communication line
21 | 21 | B137 | D21
22 | 22 | B137 | D22
23 | 23 | B137 | D23
24 | 24 | B137 | D24 | Blow-by leak diagnosis signal
25 | 25 | B137 | D25 | Rear oxygen sensor Signal
26 | 26 | B137 | D26
27 | 27 | B137 | D27
28 | 28 | B137 | D28 | Fuel pump control unit Signal 2
29 | 29 | B137 | D29
30 | 30 | B137 | D30
31 | 31 | B137 | D31 | Rear oxygen sensor Shield
32 | 1 | B136 | C1
33 | 2 | B136 | C2
34 | 3 | B136 | C3 | FI #4
35 | 4 | B136 | C4 | FI #3
36 | 5 | B136 | C5 | FI #2
37 | 6 | B136 | C6 | FI #1
38 | 7 | B136 | C7 | Main switch
39 | 8 | B136 | C8 | Brake switch 2
40 | 9 | B136 | C9 | Brake switch 1
41 | 10 | B136 | C10 | RESUME/ACCEL switch
42 | 11 | B136 | C11 | SET/COAST switch
43 | 12 | B136 | C12 | Fuel temperature sensor signal
44 | 13 | B136 | C13 | Intake air temperature sensor signal
45 | 14 | B136 | C14 | Engine coolant temperature sensor Signal
46 | 15 | B136 | C15 | Accelerator position sensor Power supply
47 | 16 | B136 | C16 | Sensor power supply | 5v OUT SENSOR_PS_5V
48 | 17 | B136 | C17 | Accelerator position sensor Main | IN_APS_MAIN
49 | 18 | B136 | C18 | Electric throttle Main | IN_TPS_MAIN
50 | 19 | B136 | C19
51 | 20 | B136 | C20 | Fuel level sensor
52 | 21 | B136 | C21 | Fuel tank pressure sensor Signal
53 | 22 | B136 | C22 | MAP Signal
54 | 23 | B136 | C23 | Mass air flow sensor Signal
55 | 24 | B136 | C24
56 | 25 | B136 | C25 | Knock sensor Signal
57 | 26 | B136 | C26 | Tumble generator valve position sensor LH Signal | IN_TUMBLE_SENSOR_LH
58 | 27 | B136 | C27 | Tumble generator valve position sensor RH Signal | IN_TUMBLE_SENSOR_RH
59 | 28 | B136 | C28 | Accelerator position sensor Sub | IN_APS_SUB
60 | 29 | B136 | C29 | Electric throttle Sub | IN_TPS_SUB
61 | 30 | B136 | C30
62 | 31 | B136 | C31 | Mass air flow sensor GND
63 | 32 | B136 | C32 | Mass air flow sensor Shield
64 | 33 | B136 | C33 | Knock sensor Shield
65 | 34 | B136 | C34 | Accelerator position sensor GND (sensor) | APS_GND
66 | 35 | B136 | C35 | GND (sensor)
67 | 1 | B135 | B1 | GND (power supply)
68 | 2 | B135 | B2 | Rear oxygen sensor heater signal
69 | 3 | B135 | B3
70 | 4 | B135 | B4 | GND (power supply)
71 | 5 | B135 | B5 | Control unit power supply | 12V IN
72 | 6 | B135 | B6 | Control unit power supply | 12V IN
73 | 7 | B135 | B7
74 | 8 | B135 | B8 | Camshaft position sensor (LH) | Sensor output waveform
75 | 9 | B135 | B9 | Camshaft position sensor (RH) | Sensor output waveform
76 | 10 | B135 | B10 | Crankshaft position sensor Signal (+) | Sensor output waveform
77 | 11 | B135 | B11
78 | 12 | B135 | B12 | GND (ignition system)
79 | 13 | B135 | B13
80 | 14 | B135 | B14
81 | 15 | B135 | B15 | IC 4
82 | 16 | B135 | B16 | IC 3
83 | 17 | B135 | B17 | IC 2
84 | 18 | B135 | B18 | IC 1
85 | 19 | B135 | B19 | Back-up power supply
86 | 20 | B135 | B20
87 | 21 | B135 | B21
88 | 22 | B135 | B22 | Crankshaft position sensor Signal (−) |  |  | A/C relay control
89 | 23 | B135 | B23
90 | 24 | B135 | B24 | Radiator fan relay 2 control
91 | 25 | B135 | B25 | Radiator fan relay 1 control
92 | 26 | B135 | B26 | Fuel pump control unit Signal 1
93 | 27 | B135 | B27 | Vehicle speed signal | “5” and “0” are repeatedly displayed when vehicle is driven | IN_VSS
94 | 28 | B135 | B28
95 | 29 | B135 | B29
96 | 30 | B135 | B30
97 | 31 | B135 | B31 | Crankshaft position sensor Shield
98 | 32 | B135 | B32
99 | 33 | B135 | B33
100 | 34 | B135 | B34
101 | 35 | B135 | B35 | Electric throttle motor relay
102 | 1 | B134 | A1 | Clutch switch | IN_CLT
103 | 2 | B134 | A2 | Front oxygen (A/F) sensor heater Signal 2
104 | 3 | B134 | A3 | Front oxygen (A/F) sensor heater Signal 1
105 | 4 | B134 | A4
106 | 5 | B134 | A5
107 | 6 | B134 | A6 | GND (front oxygen (A/ F) sensor heater 2)
108 | 7 | B134 | A7 | GND (front oxygen (A/ F) sensor heater 1)
109 | 8 | B134 | A8 | Tumble generator valve RH (close)
110 | 9 | B134 | A9 | Tumble generator valve RH (open)
111 | 10 | B134 | A10 | Tumble generator valve LH (close)
112 | 11 | B134 | A11 | Tumble generator valve LH (open)
113 | 12 | B134 | A12 | Fuel tank pressure control solenoid valve
114 | 13 | B134 | A13 | Drain valve
115 | 14 | B134 | A14 | Purge control solenoid valve
116 | 15 | B134 | A15 | Main light
117 | 16 | B134 | A16 | Cruise control set light
118 | 17 | B134 | A17 | Malfunction indicator lamp
119 | 18 | B134 | A18 | Variable valve timing solenoid valve (RH) Signal (+) | OUT_VVT_RH+
120 | 19 | B134 | A19 | Variable valve timing solenoid valve (LH) Signal (+) | OUT_VVT_LH+
121 | 20 | B134 | A20
122 | 21 | B134 | A21
123 | 22 | B134 | A22
124 | 23 | B134 | A23 | Engine speed output | OUT_TACH
125 | 24 | B134 | A24 | Fuel tank sensor control valve
126 | 25 | B134 | A25 | Front oxygen (A/F) sensor shield
127 | 26 | B134 | A26 | Front oxygen (A/F) sensor signal (−)
128 | 27 | B134 | A27
129 | 28 | B134 | A28 | Variable valve timing solenoid valve (RH) Signal (−) | OUT_VVT_RH-
130 | 29 | B134 | A29 | Variable valve timing solenoid valve (LH) Signal (−) | OUT_VVT_LH-
131 | 30 | B134 | A30
132 | 31 | B134 | A31
133 | 32 | B134 | A32 | Wastegate control solenoid valve | OUT_WG Sensor output waveform 0 or 13 — 14v
134 | 33 | B134 | A33 | Front oxygen (A/F) sensor signal (+)
135 | 34 | B134 | A34

Sheet: Sheet2
Low switches | High switches | Analogs | Motor Driver | Knock | Coils | MotorDrivers
MAIN_RELAY |  |  |  |  | OUT_IGN1 | OUT_ETB- | IN_CAM_HALL_CAM_LH
OUT_FAN_RELAY_2 |  |  |  |  | OUT_IGN2 | OUT_ETB+ | IN_CAM_HALL_CAM_RH
OUT_FAN_RELAY_1 |  |  |  |  | OUT_IGN3 | ETB_PWM | IN_CRANK+
OUT_ELECTRONIC_THROTTE_RELAY |  |  |  |  | OUT_IGN4 | ETB_DIR
OUT_INJ1 |  |  |  |  |  | ETB_DIS
OUT_INJ2
OUT_INJ3
OUT_INJ4
