angelEmbeddedEra/rusefi-sti-2004/boards/rusefiSTI2004-a/board/misc/rusefiSTI2004-a-outline.png

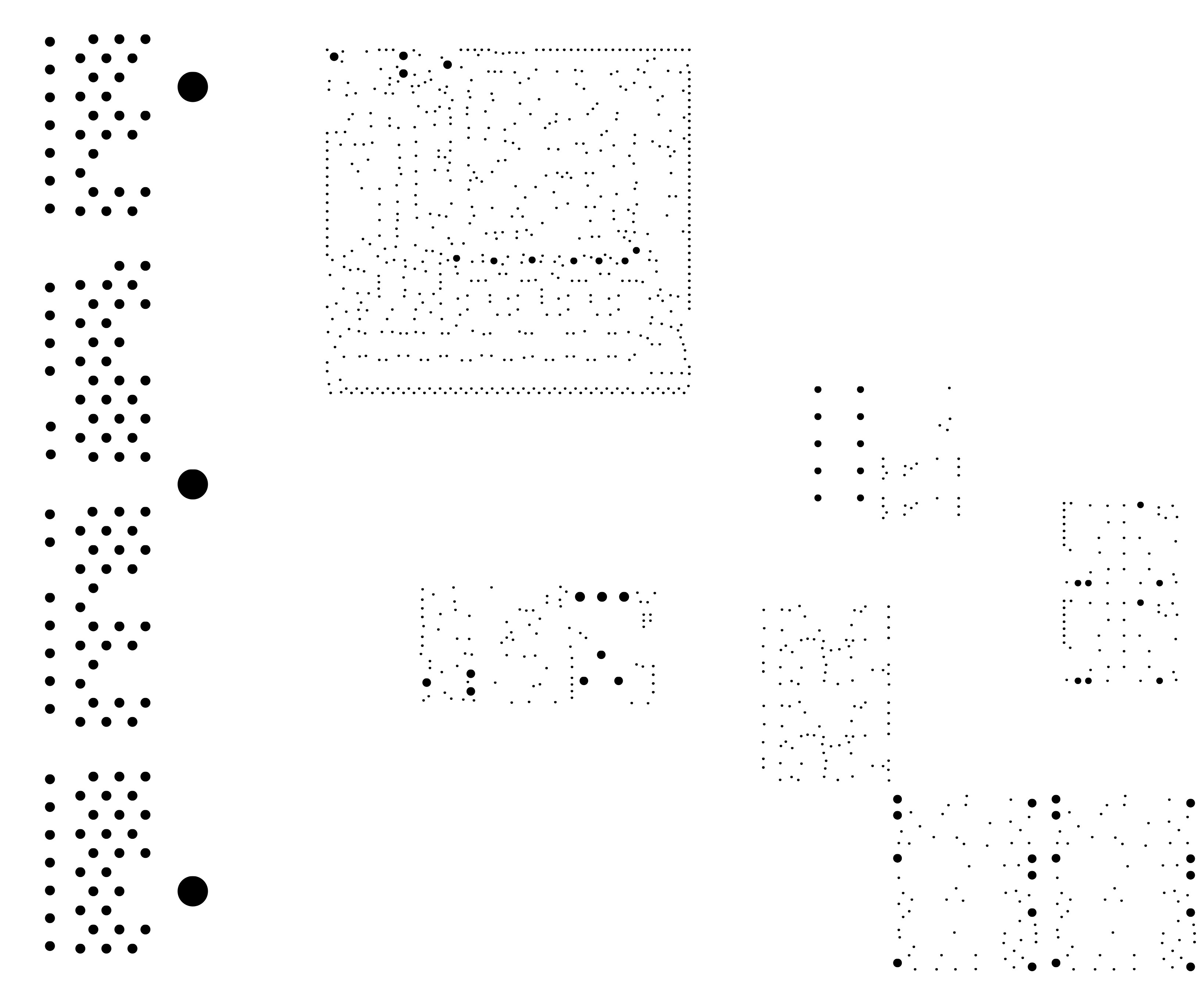
boards/rusefiSTI2004-a/board/misc/rusefiSTI2004-a-outline.png
