angelEmbeddedEra/rusefi-sti-2004/boards/rusefiSTI2004-a/board/rusefiSTI2004-a-BOM-JLC.csv

Comment | Designator | Footprint | LCSC Part #
nSMD005 | F1, F2, F3, F4, F5 | PAD-1206-PAD | C369153
VND14NV04-E | Q1, Q2, Q3, Q4, Q5, Q6, Q7, Q8 | DPAK | C155647
33k | R1, R120 | R0603 | C4216
6.8k | R2 | R0603 | C23212
4.7k | R3, R4, R5, R6, R7, R8, R9, R10, R822, R822_2 | R0603 | C23162
TJA1051T/3/1J | U100, U605, U430 | SO8 | C38695
STM32F767ZI | U105 | LQFP144 | C90235
SRV05-4-P-T7 | D102, D200, D201, D202, D203, D204, D206, D207, U751, U751_2 | SOT23-6 | C85364
SN74LVC4245APWR | U103 | TSSOP24 | C7859
SN74LVC1G06DCKR | U110 | SOT-353 | C7828
SMD1206B035TF/16 | F100, F101 | R1206 | C269114
REF3033 | U102, U603 | SOT-23 | C36658
PESD1CAN | D100, D604, D430 | SOT-23 | C343993
P6SMB6.8CA | D205, D421, D421_2 | SMB | C78395
NC7SB3157P6X | U270, U275, U280, U285, U755, U756, U755_2, U756_2 | SOT-363 | C87403
Molex MicroSD 47219-2001 | J100 | SDAMB-012 | C164170
MCP6004 | U170, U175, U180, U185, U190, U195, U600, U753, U753_2 | TSSOP14 | C50282
LPS22HBTR | U107 | HLGA-10L | C94049
LIS2DH12TR | U106 | LGA12 | C110926
LED-YELLOW-0603 | D106 | LED-0603 | C72038
LED-RED-0603 | D103, D600, D603 | LED-0603 | C2286
LED-GREEN-0603 | D104, D108, D601, D751, D751_2 | LED-0603 | C72043
LED-BLUE-0603 | D105, D109, D110, D111, D112, D113, D114, D115, D116, D602 | LED-0603 | C72041
LDL1117S33R | U101 | SOT-223 | C435835
BTN | S100, S101 | SMD-2_2.9x3.9x1.7 | C115357
BLM18AG601SN1D | L100 | L0603 | C19330
BAT54S | VD100, VD101, VD102, VD103 | SOT-23 | C47546
B5819W | D101, D416, D417, D416_2, D417_2 | SOD-123 | C8598
AO3401A | Q100, Q102 | SOT-23 | C15127
AO3400A | Q101, Q103 | SOT-23 | C20917
680k | R201, R202, R203, R204, R205, R206, R207, R208, R221, R222, R225, R226, R237, R238, R239, R240, R241, R242, R243, R244, R259, R260, R261, R262, R263, R264, R265, R266 | R0402 | C163456
510 | R133, R134 | R0603 | C23193
510 | R254, R255, R256, R258 | R0402 | C25123
470 | R101, R118, R119 | R0603-4 | C25510
120 | R100, R430 | R0603 | C22787
100n | C100, C101, C105, C108, C109, C110, C111, C112, C113, C118, C119, C120, C121, C122, C124, C126, C127, C128, C129, C130, C134, C147, C170, C175, C180, C185, C190, C195, C204, C205, C206, C207, C216, C217, C218, C219, C220, C221, C222, C230, C231, C232, C233, C270, C275, C280, C285, C601, C602, C605, C608, C612, C613, C614, C615, C617, C618, C753, C754, C759, C753_2, C754_2, C759_2 | C0402 | C1525
100 | R104, R106 | R0603 | C22775
74LVC2G17GW,125 | U108, U109 | SOT-363 | C80500
32.768 kHz | Y101 | SMD2012 | C99009
20 MHz | Y102 | SMD5032 | C112566
18p | C132, C136 | C0402 | C1549
12p | C115, C116 | C0402 | C1547
10n | C202, C208, C209, C210, C211, C212, C213, C214, C215, C756, C757, C760, C764, C768, C769, C756_2, C757_2, C760_2, C764_2, C768_2, C769_2, C428, C428_2 | C0402 | C15195
10k | R102, R103, R105, R107, R108, R109, R121, R124, R126, R127, R128, R132, R135, R136, R137, R138, R139, R141, R142, R228, R229, R230, R231, R232, R233, R234, R235, R246, R247, R248, R249, R250, R251, R252, R253, R604, R605, R613, R614, R618, R619, R625, R757, R762, R763, R767, R768, R757_2, R762_2, R763_2, R767_2, R768_2, R421, R426, R427, R421_2, R426_2, R427_2 | R0402 | C25744
10k | R129, R130, R140 | R0603-4 | C29718
10 | R110, R111, R112, R113, R114, R115, R116, R117, R606, R761, R764, R769, R761_2, R764_2, R769_2 | R0402 | C25077
5.1k | R195 | R0402 | C25905
4.7u | C102, C103, C104, C106, C107, C137, C138, C140 | C0402 | C23733
4.7k | R125, R170, R171, R175, R176, R180, R181, R185, R186, R190, R191, R196, R197, R200, R209, R218, R227, R236, R245, R257 | R0603-4 | C66697
4.7k | R144, R210, R211, R212, R213, R214, R215, R216, R217, R219, R220, R223, R224, R428, R428_2 | R0402 | C25900
2.2u | C114, C117, C131, C223, C224, C229 | C0402 | C12530
2.2k | R122, R123, R146, R147, R751, R751_2 | R0402 | C25879
1u | C133 | C0603 | C519560
1n | C135, C139, C141, C142, C143, C144, C145, C146, C200, C201, C203, C225, C226, C227, C228, C751, C751_2 | C0402 | C1523
0 | R131, R143, R145 | R0402 | C17168
10u | C821, C822, C823, C824, C825, C826, C827, C828, C829, C830, C821_2, C822_2, C823_2, C824_2, C825_2, C826_2, C827_2, C828_2, C829_2, C830_2 | C0805 | C440198
100n | C831, C430, C431, C831_2 | C0603 | C14663
10n | C832, C833, C832_2, C833_2 | C0603 | C57112
10k | R821, R821_2 | R0603 | C25804
TLE9201SG | U821, U821_2 | Infineon_PG-DSO-12-11 | C112633
1u | C600, C607, C609, C610, C611, C755, C758, C761, C762, C763, C765, C766, C767, C755_2, C758_2, C761_2, C762_2, C763_2, C765_2, C766_2, C767_2, C414, C415, C414_2, C415_2 | C0402 | C52923
33n | C603 | C0402 | C1585
4.7u | C616, C427, C427_2 | C0603 | C19666
VND7NV04TR-E | Q600 | DPAK | C155605
1k | R600, R601, R616, R617, R622, R626, R627, R628, R765, R766, R765_2, R766_2 | R0402 | C11702
68k | R602, R603, R760, R760_2, R422, R422_2 | R0402 | C36871
22k | R607 | R0402 | C25768
47 | R608 | R0402 | C25118
61.9 | R609 | R0603 | C23092
20k | R610, R611, R612 | R0402 | C25765
100k | R615, R621, R755, R756, R758, R759, R755_2, R756_2, R758_2, R759_2, R471, R473, R471_2, R473_2 | R0402 | C25741
27k | R620, R623 | R0402 | C25771
3.3k | R624 | R0402 | C25890
AD8628 | U601 | TSOT23-5 | C29309
STM32F042K6Tx | U602 | LQFP32 | C69216
XC6206P332MR | U604 | SOT-23 | C5446
470n | C752, C752_2 | C0402 | C47339
10k | R752, R753, R752_2, R753_2 | R0805 | C17414
12k | R754, R754_2, R472, R423, R472_2, R423_2 | R0402 | C25752
74AHC1G02 | U752, U757, U752_2, U757_2 | SOT23-5 | C7463
MAX9142 | U754, U754_2 | SO8 | C18567
100n | C470, C411, C413, C420, C470_2, C411_2, C413_2, C420_2 | C0402 | C307331
3.3n | C471, C471_2 | C0402 | C26404
330p | C472, C472_2 | C0402 | C13533
47p | C473, C473_2 | C0402 | C1567
680p | C474, C474_2 | C0603 | C1630
470k | R470, R470_2 | R0402 | C25790
33k | R474, R411, R424, R425, R474_2, R411_2, R424_2, R425_2 | R0402 | C25779
LMV321IDBVR | U470, U471, U470_2, U471_2 | SOT23-5 | C7972
47u | C410, C412, C410_2, C412_2 | C1206 | C96123
10u | C421, C422, C423, C424, C425, C426, C421_2, C422_2, C423_2, C424_2, C425_2, C426_2 | C0603 | C96446
220p | C429, C429_2 | C0402 | C1530
1N4148WS | D410, D412, D413, D414, D410_2, D412_2, D413_2, D414_2 | SOD-323 | C2128
BAS416 | D415, D415_2 | SOD-323 | C968040
PSM712-LF | D411, D411_2 | SOT-23 | C32677
SMCJ30A | D418, D418_2 | SMC | C310046
SS34 | D420, D420_2 | SMA | C8678
SMD1206P050TF/24 | F410, F410_2 | SMD1206 | C209741
2.2uH | L420, L420_2 | L1210 | C36828
MWSA0503-10uH | L421, L421_2 | MWSA0503 | C139506
MHT136UGCT | LED1, LED2, LED3, LED4, LED1_2, LED2_2, LED3_2, LED4_2 | LED0402 | C434447
6.8k | R410, R413, R410_2, R413_2 | R0402 | C25917
1 | R420, R420_2 | R0402 | C25086
MIC5205-3.3YM5 | U410, U410_2 | SOT23-5 | C37970
TLS115 | U411, U411_2 | PG-DSO-8 EP | C540242
LMR14020 | U420, U420_2 | SOP8 | C187824
nSMD050-24V | F42333310 | SMD1206 | C70076
