angelEmbeddedEra/rusefi-sti-2004/boards/rusefiSTI2004-a/board/misc/rusefiSTI2004-a-components.png

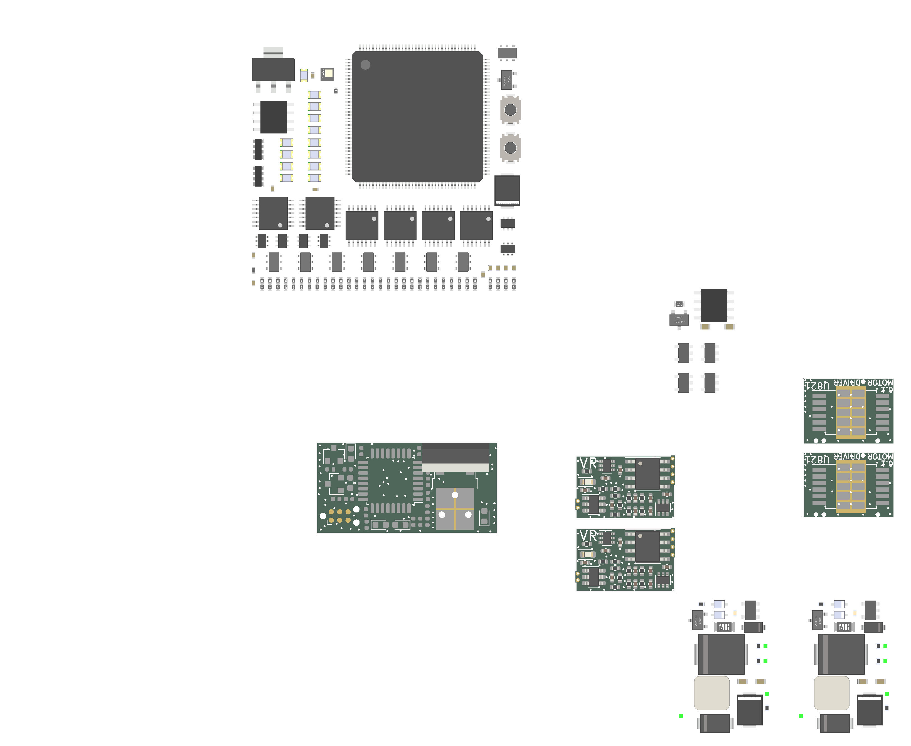
boards/rusefiSTI2004-a/board/misc/rusefiSTI2004-a-components.png
