angelEmbeddedEra/rusefi-sti-2004/documents/STI2004-schematic.pdf

1 | 2 | 3 | 4 | 5 | 6 | 7 | 8

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
### F DATE ISSUE: 2026-10-13

TITLE: rusEFI STI 2004 ECU | COSTUMER: EmbeddedEra THIS DRAWING AND INFORMATION CONTAINED HEREIN
DESCRIPTION: rusefiSTI2004 | PART NUMBER: TBD | REV: B
SIZE: A3 | | DESIGNER: AGD | SHEET: 1 OF 14

ARE THE EXCLUSIVE PROPERTY OF EMBEDDEDERA LLC. AND SHALL BE RETURNED UPON DEMAND AND SHALL NOT BE REPRODUCED IN WHOLE OR IN PART TO ANYONE ELSE OR USED, WITHOUT THE WRITTEN CONSENT OF EMBEDDEDERA LLC CONFIDENTIALITY NOTICE

### Sensors

File: Sensors.kicad_sch Power

File: Power.kicad_sch Vehicle connector

File: Connector.kicad_sch | Aux and expansion

File: Aux.kicad_sch Comms

# File: Comms.kicad_sch MCU and USB

File: Mcu.kicad_sch Switch inputs

File: Inputs.kicad_sch

### Outputs

File: Outputs.kicad_sch | M3: rusEFI wideband (WBO) for a Bosch LSU 4.9 front O2, on CAN to M1. It reaches the sensor through the
stock | Crank: 2-wire VR sensor (B10 +, B22 -) into M5. Knock (C25) into M13. M7 is a spare knock channel (not used). M1: Hellen mega-mcu144 (STM32F7), with a 120R CAN
terminator built in. Units: D = B137, C = B136, B = B135, A = B134. Every
pin carries a global net label used on the other sheets. | J3: Molex Mini-Fit Jr 2x7 (pinout in

documents/README.md): fused 12 V and 5 V, sensor ground, three digital

Built from Hellen-One modules. Signals between sheets are global net labels; power symbols are global. Crossed-out (DNP) parts are optional footprints, not assembled: what each one is for is in documents/README.md. Car pinout and cross-check: documents/STI2004-pinout-check.xlsx (tools/pinout_check.py).
Sheet order follows the signal: car connector -> power -> MCU -> inputs -> outputs -> comms -> aux. M14 (main power module): +12V_RAW from the main

relay (B5/B6), +12V_IGN (D15), back-up +12V (B19).

rusEFI STI 2004: plug-and-play ECU for the 2004 USDM Subaru Impreza WRX STI (EJ257, drive-by-wire).

Protected low-side drivers sized per load (Outputs): 8 DPAK, 4 SOT-223, 8 SOT-23F. M11/M12 (dinput4): car lines that close to ground (defogger D11, lights D12, blower D13, test mode D14,

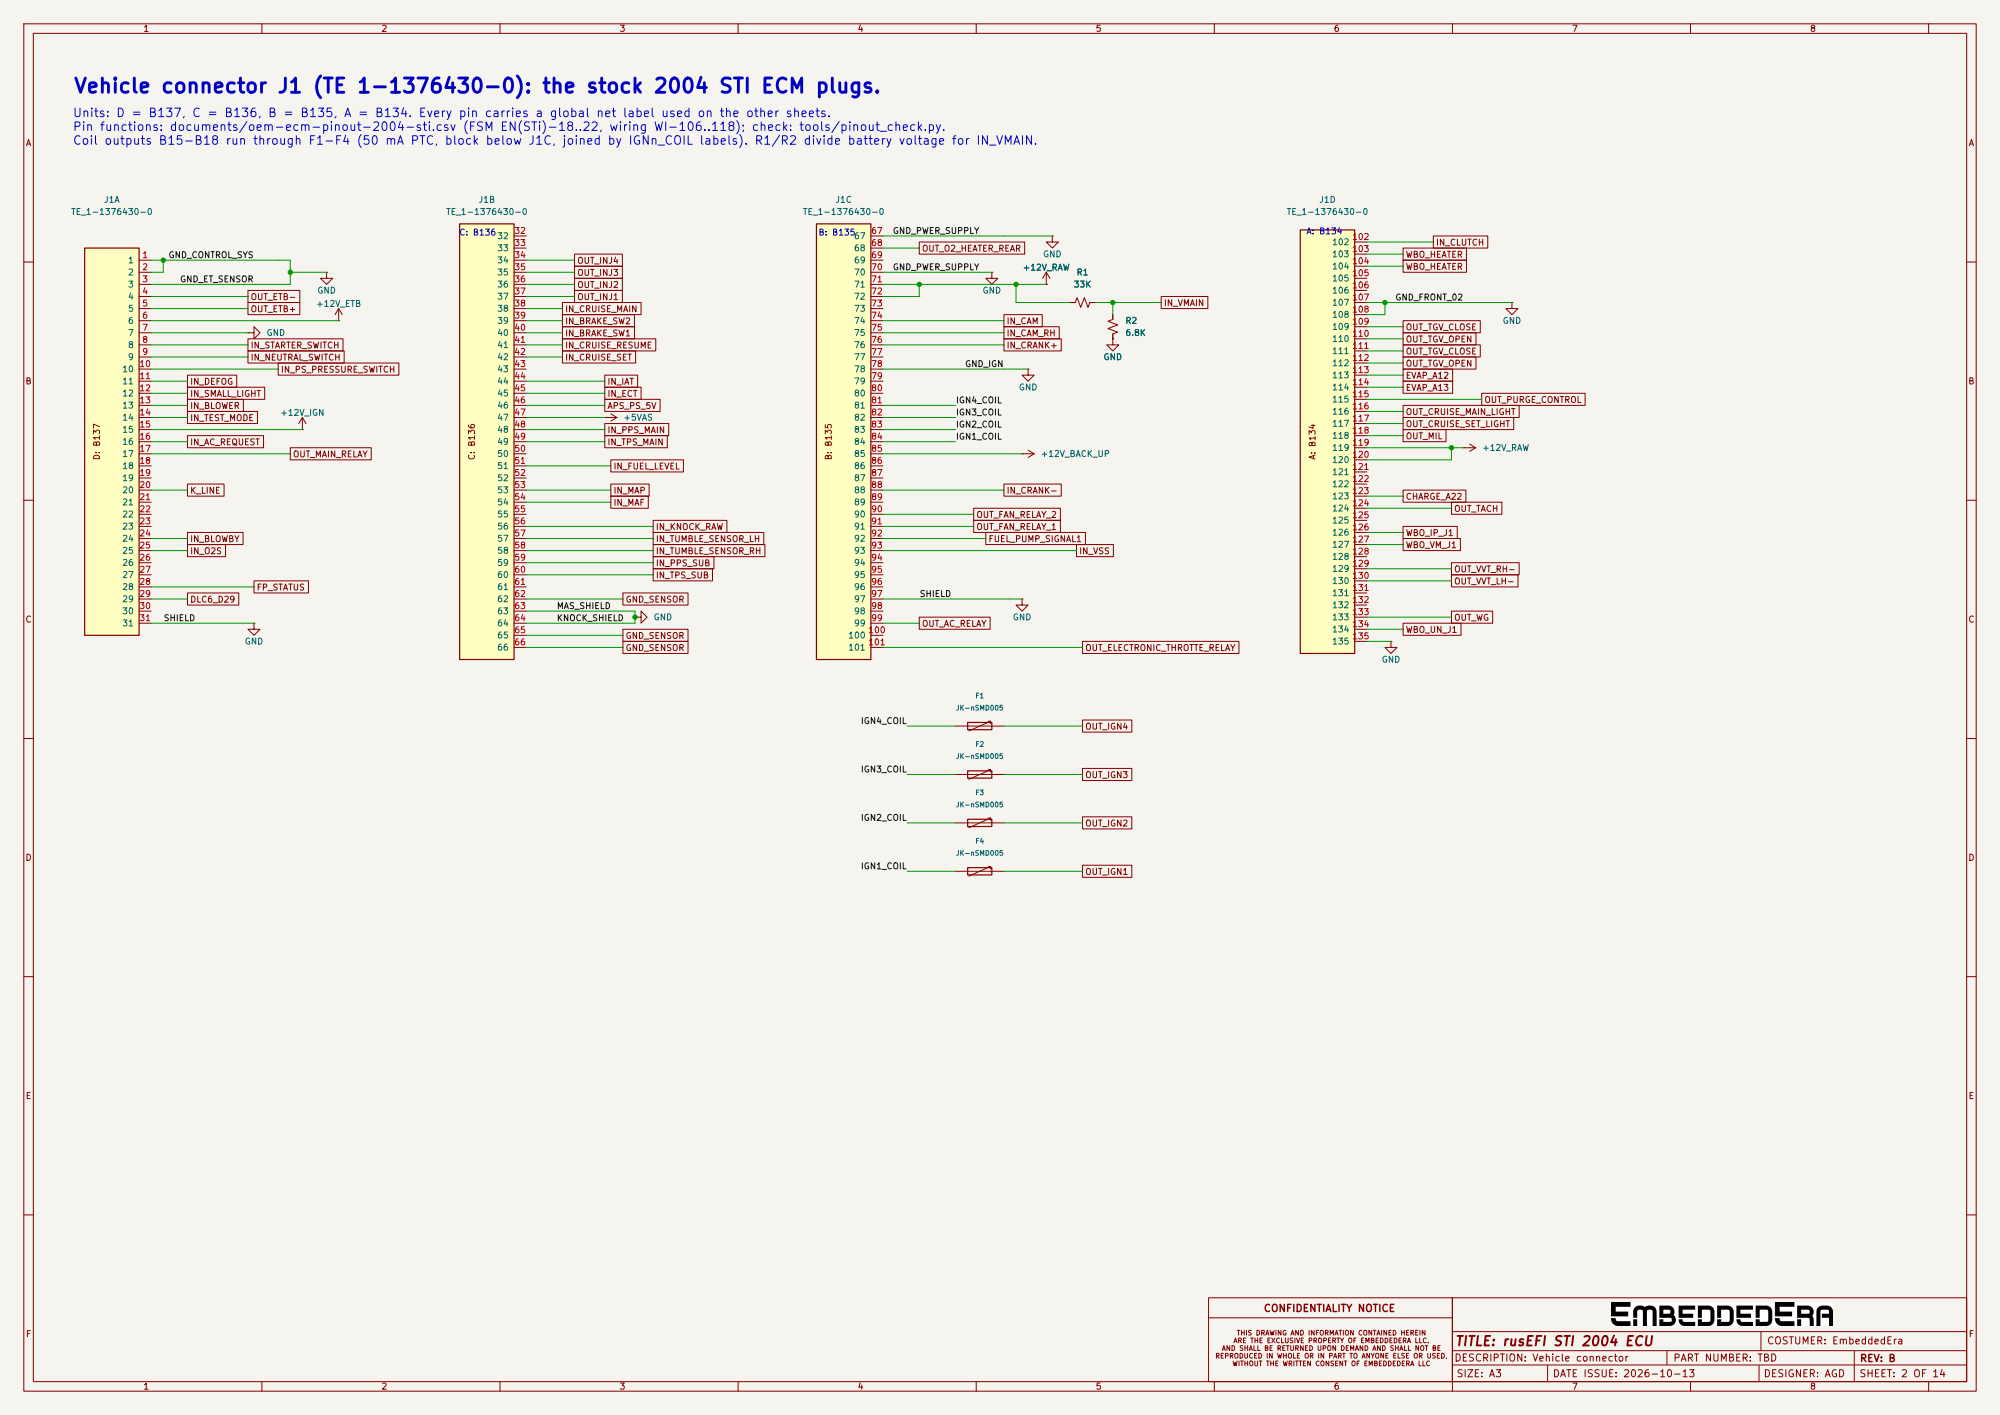
[picture p6: page 2]

Vehicle connector J1 (TE 1-1376430-0): the stock 2004 STI ECM plugs.

Pin functions: documents/oem-ecm-pinout-2004-sti.csv (FSM EN(STi)-18..22, wiring WI-106..118); check: tools/pinout_check.py.
Coil outputs B15-B18 run through F1-F4 (50 mA PTC, block below J1C, joined by IGNn_COIL labels). R1/R2 divide battery voltage for IN_VMAIN.

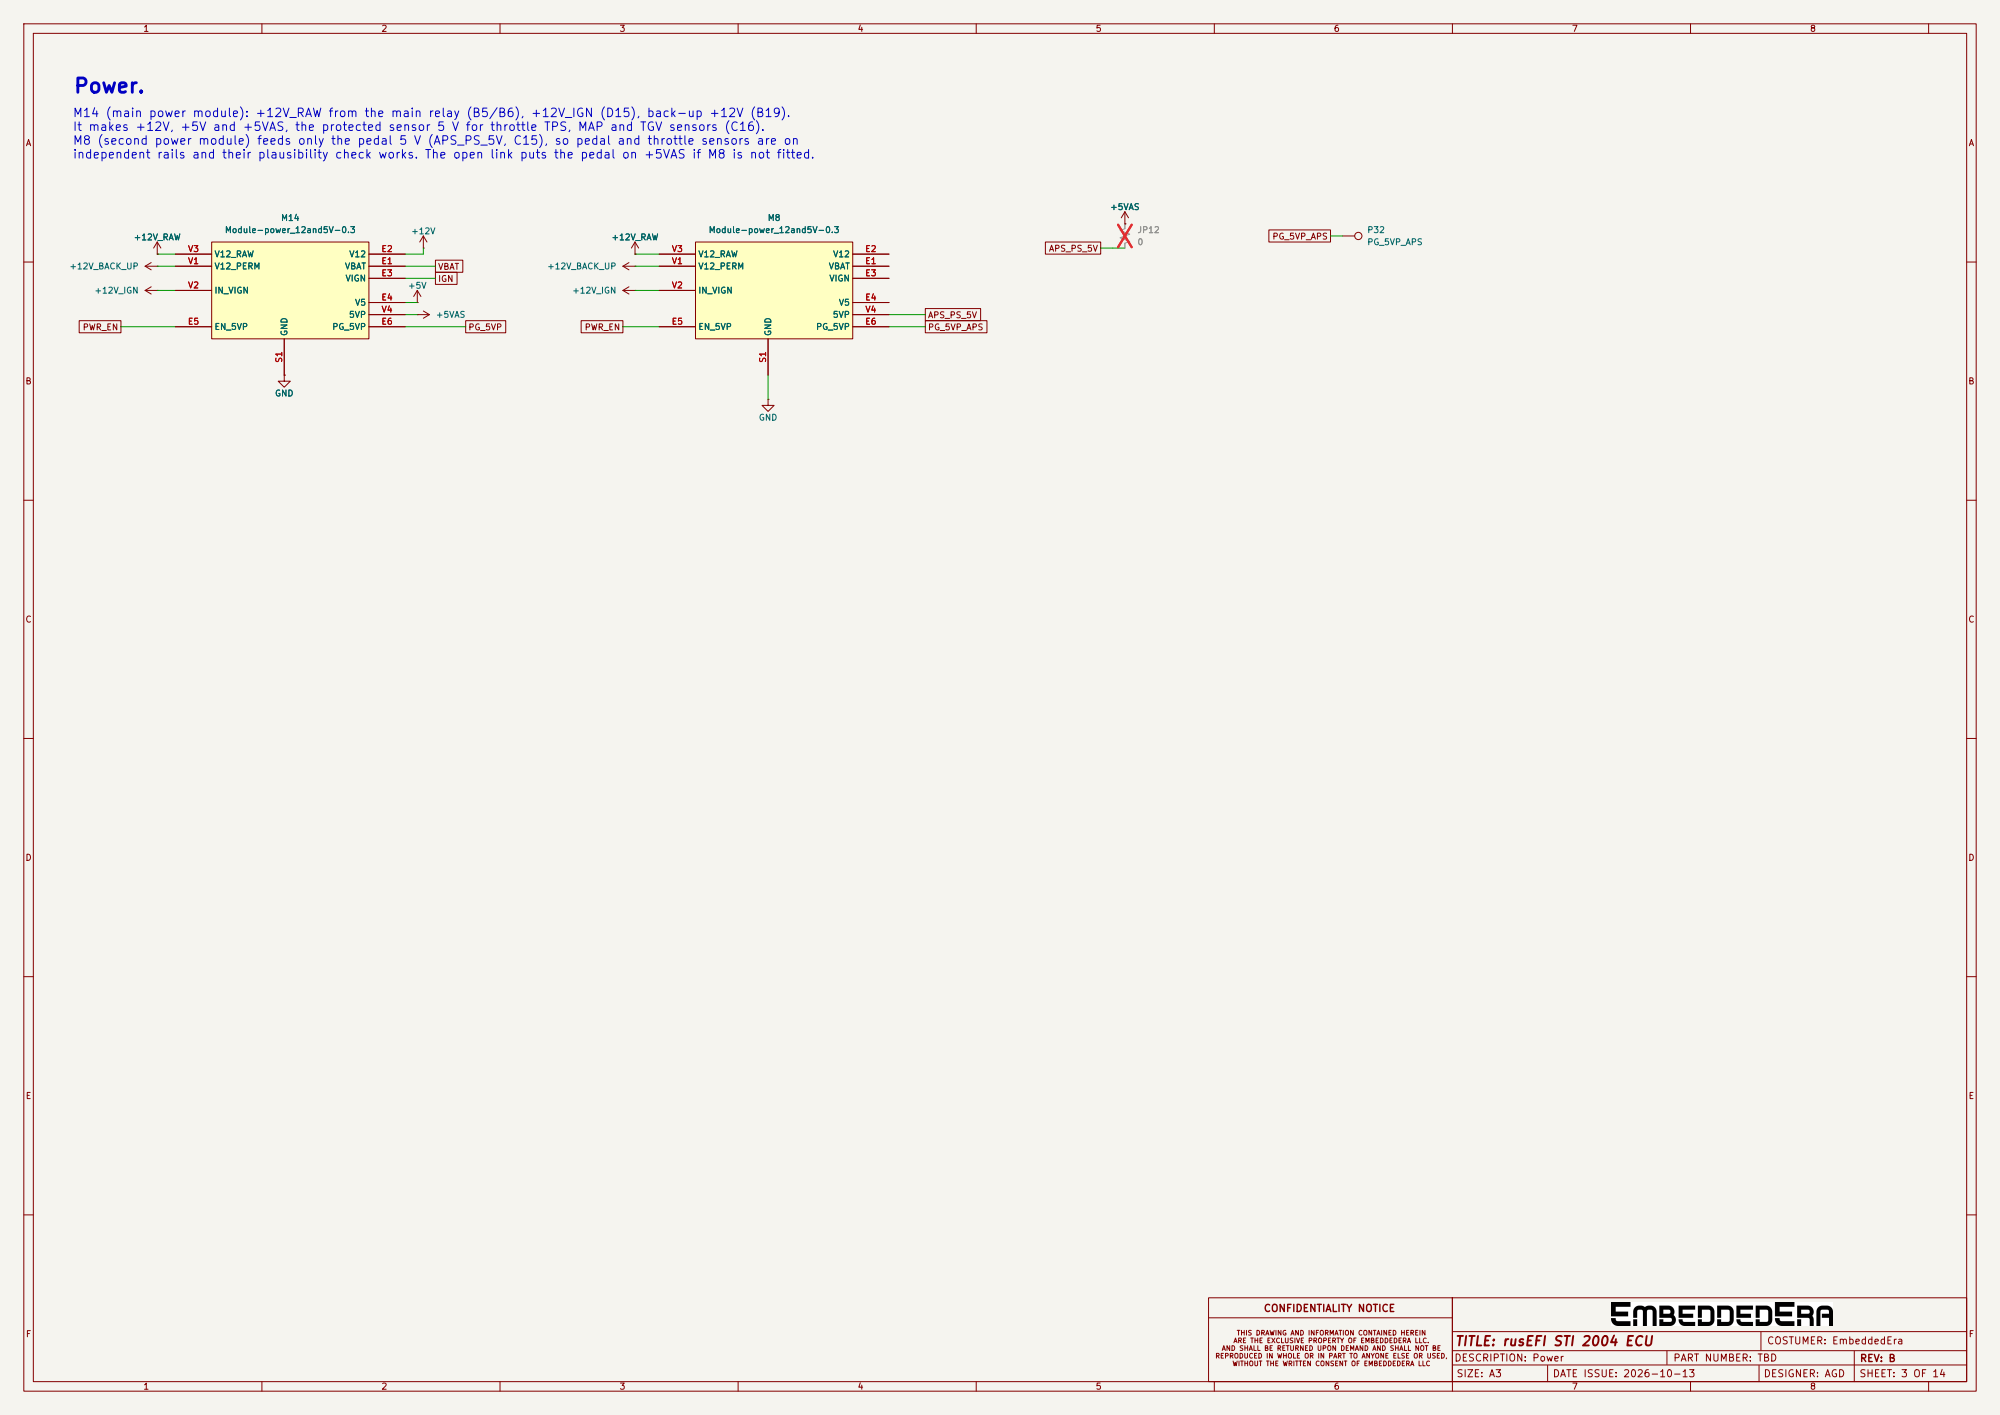
[picture p7: page 3]

PG_5VP M14 (main power module): +12V_RAW from the main relay (B5/B6), +12V_IGN (D15), back-up +12V (B19).
It makes +12V, +5V and +5VAS, the protected sensor 5 V for throttle TPS, MAP and TGV sensors (C16).
M8 (second power module) feeds only the pedal 5 V (APS_PS_5V, C15), so pedal and throttle sensors are on
independent rails and their plausibility check works. The open link puts the pedal on +5VAS if M8 is not fitted.

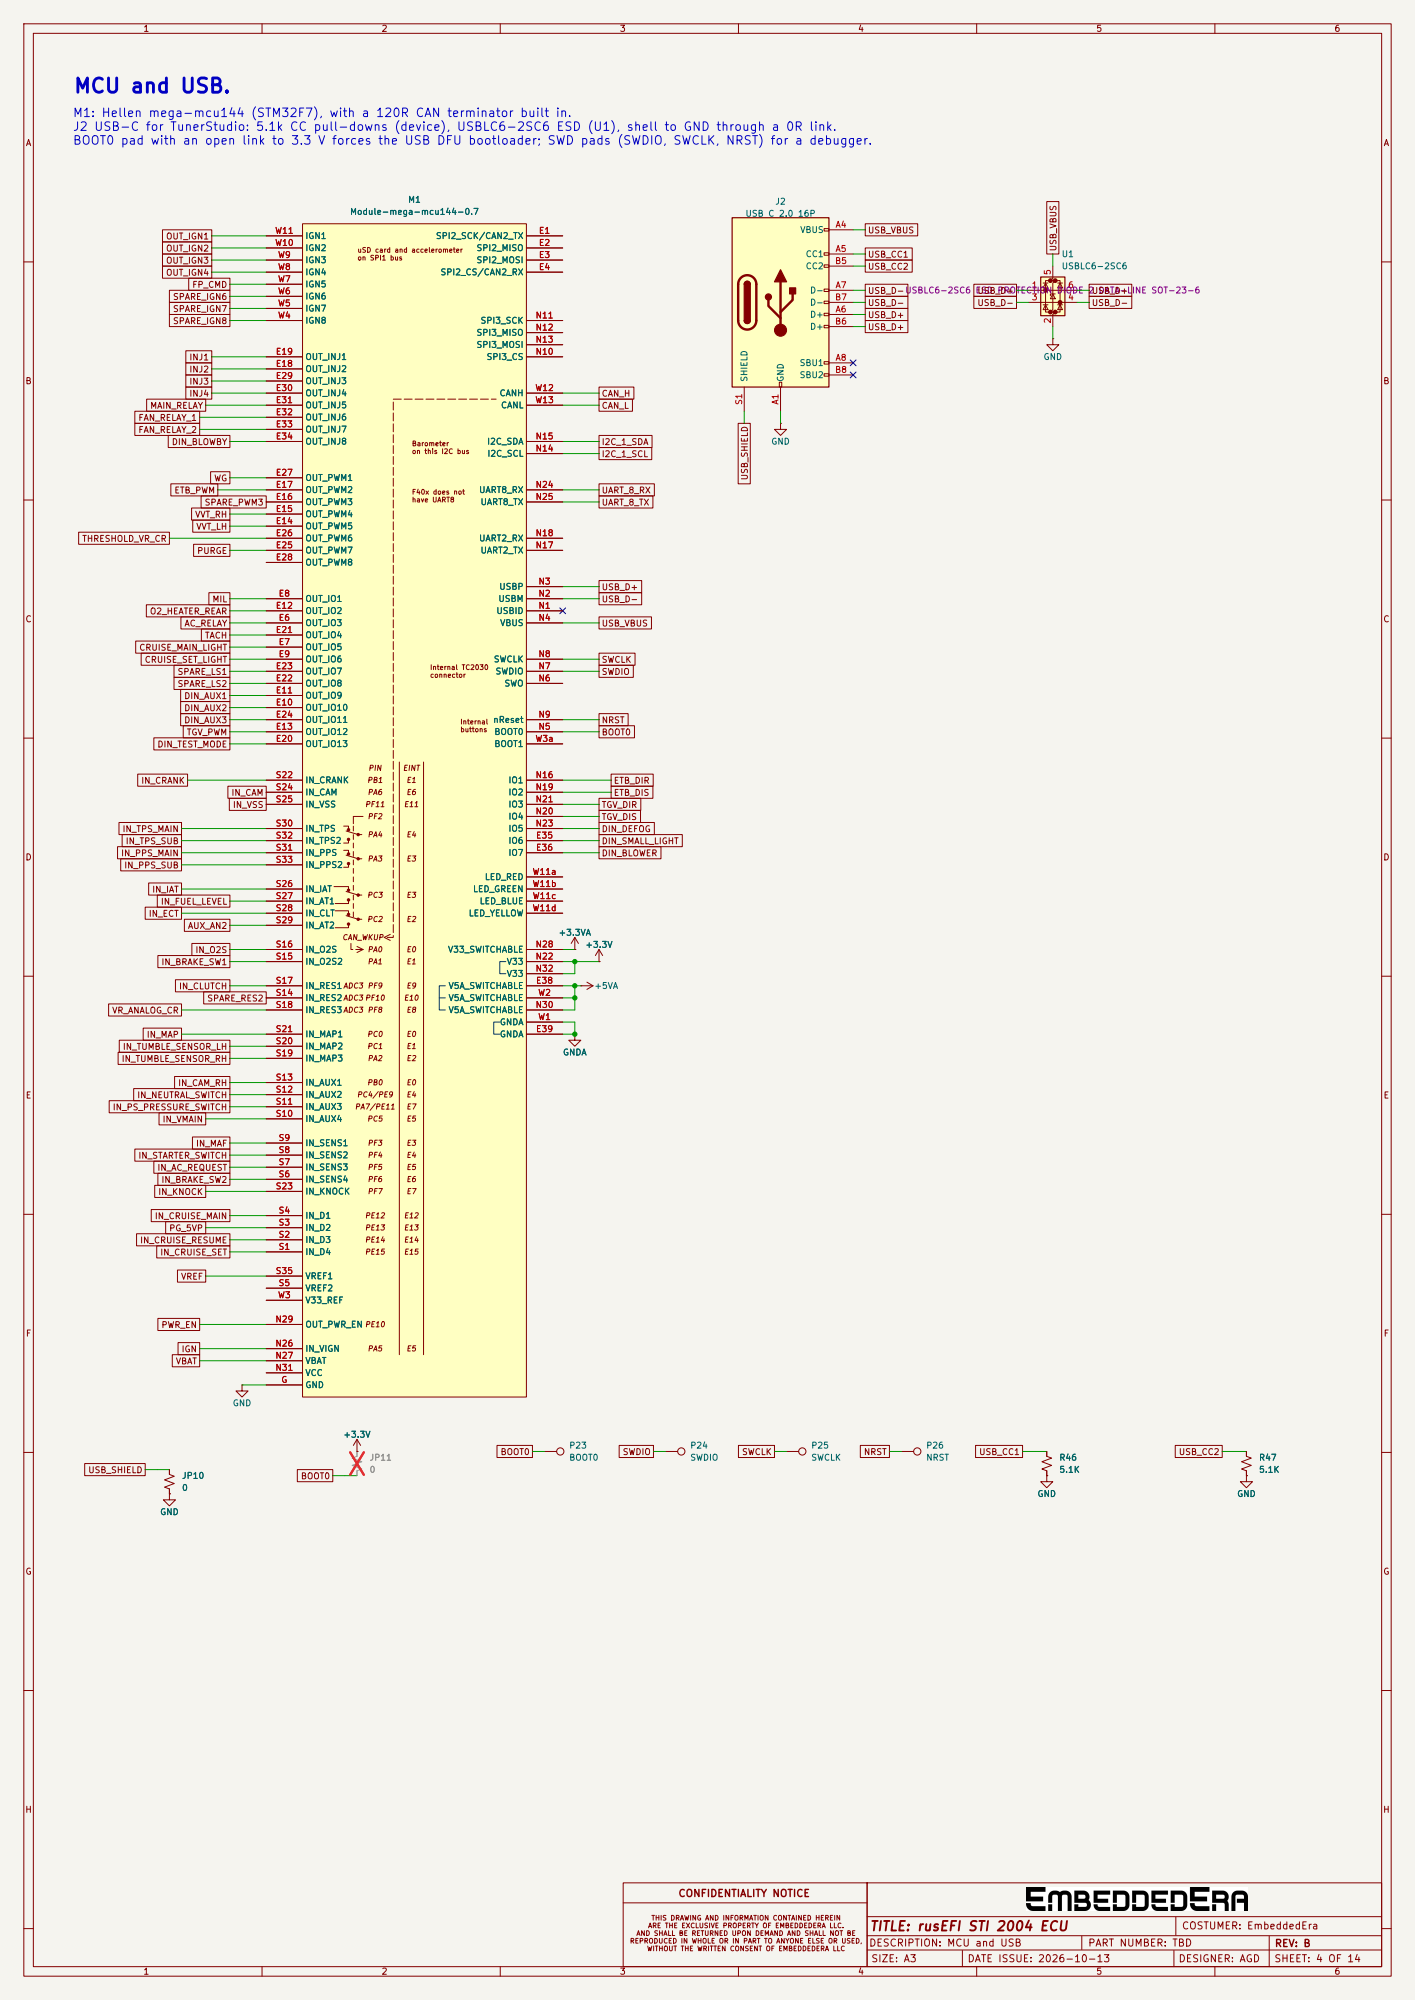
[picture p8: page 4]

M1: Hellen mega-mcu144 (STM32F7), with a 120R CAN terminator built in.
J2 USB-C for TunerStudio: 5.1k CC pull-downs (device), USBLC6-2SC6 ESD (U1), shell to GND through a 0R link.
BOOT0 pad with an open link to 3.3 V forces the USB DFU bootloader; SWD pads (SWDIO, SWCLK, NRST) for a debugger.

uSD card and accelerometer on SPI1 bus

Barometer on this I2C bus F40x does not have UART8 EINT E1
TGV_DIS USB_VBUS

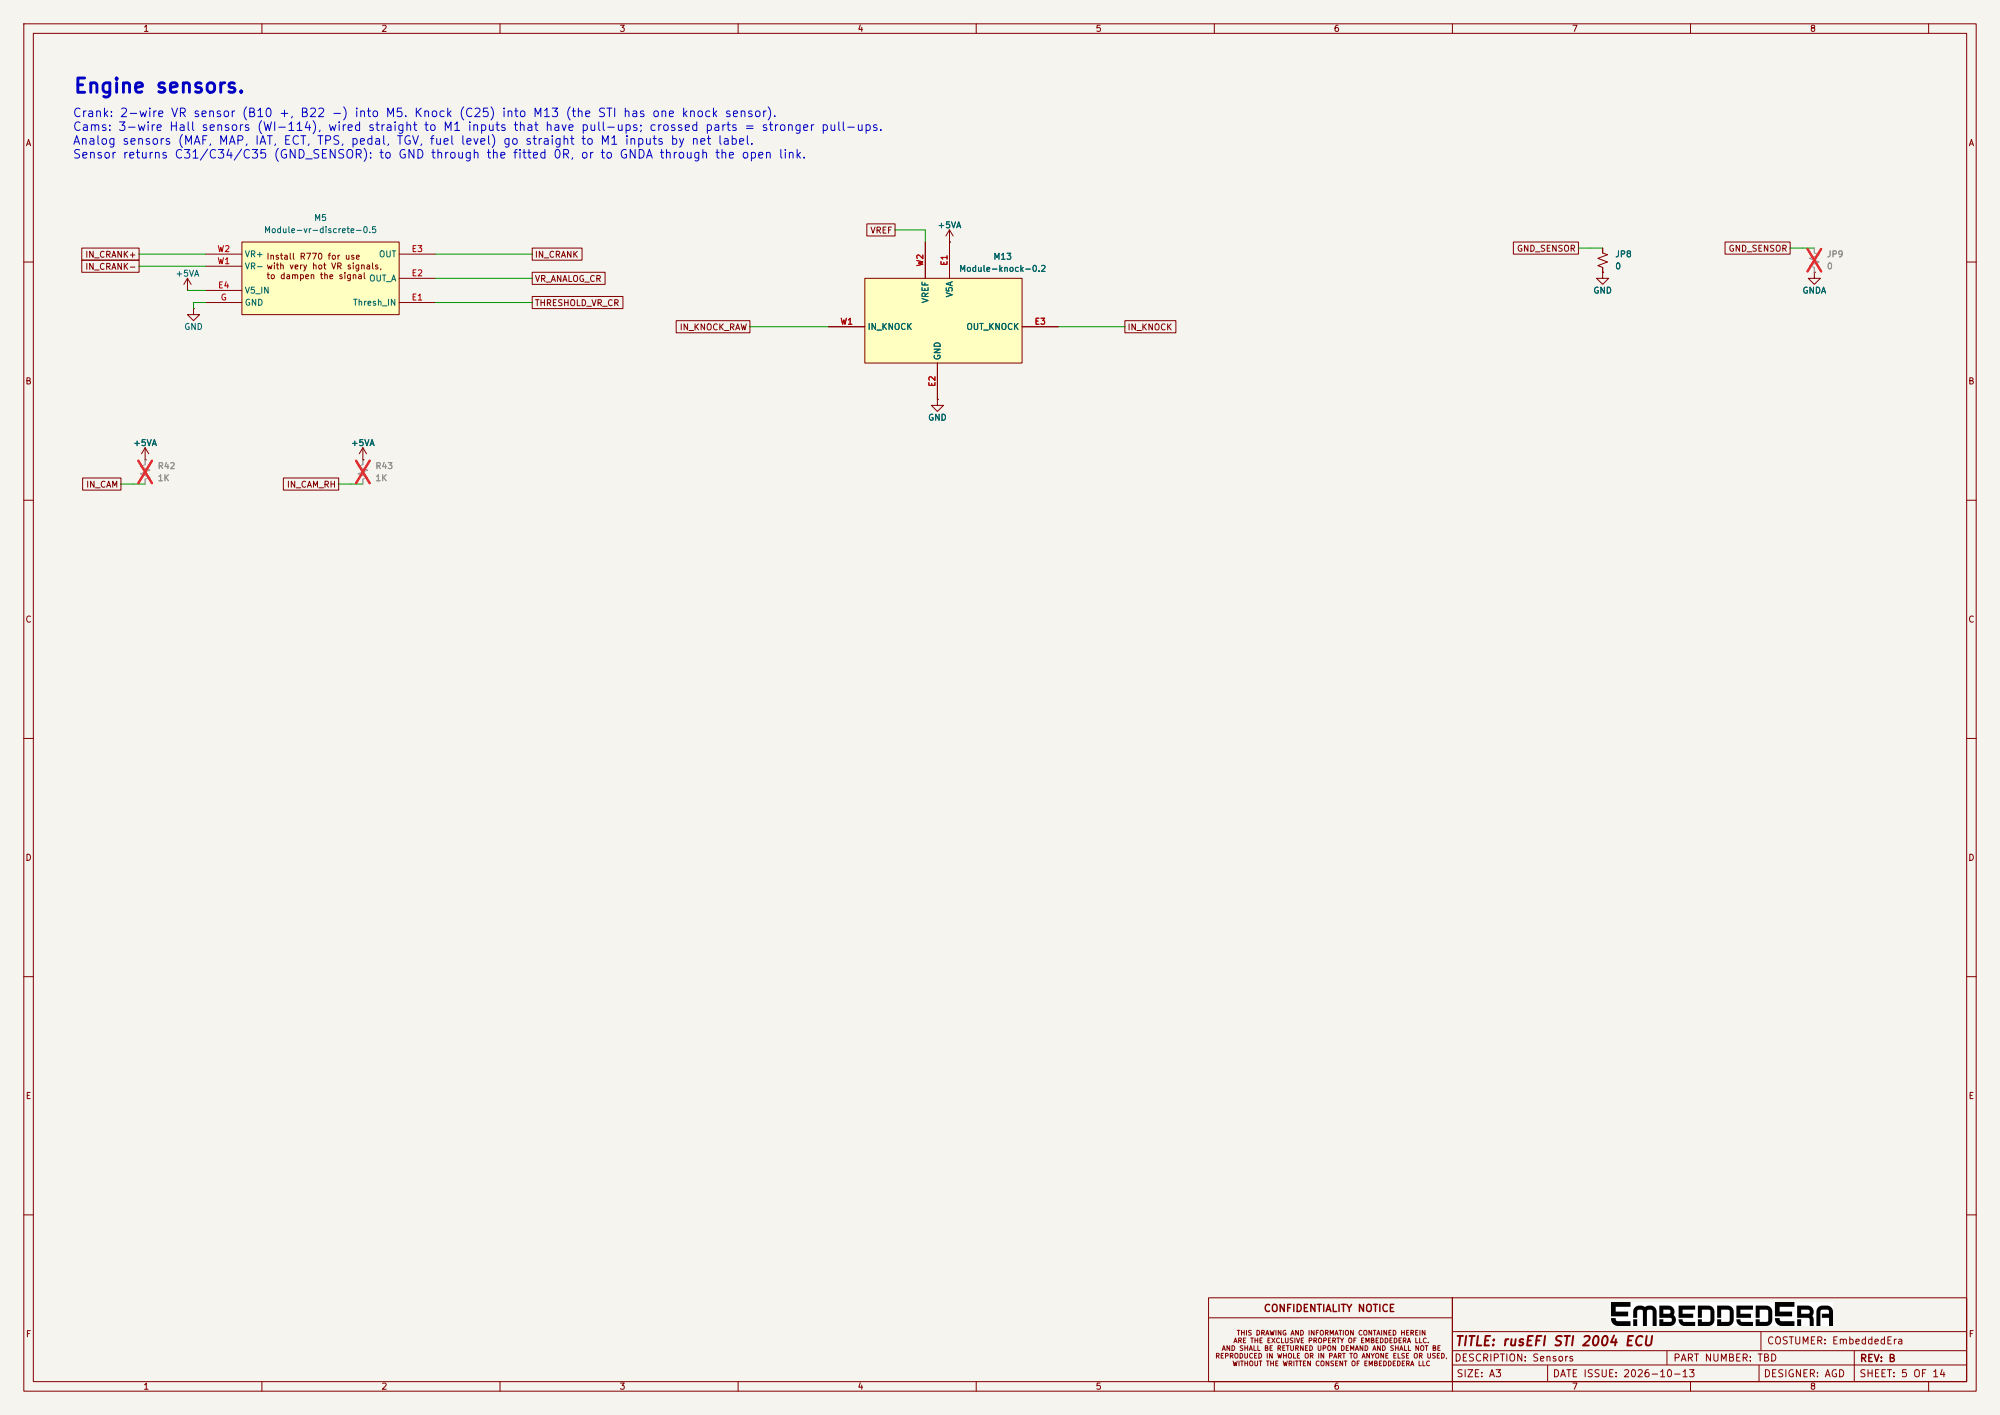
[picture p9: page 5]

VR_ANALOG_CR Crank: 2-wire VR sensor (B10 +, B22 -) into M5. Knock (C25) into M13 (the STI has one knock sensor).
Cams: 3-wire Hall sensors (WI-114), wired straight to M1 inputs that have pull-ups; crossed parts = stronger pull-ups.
Analog sensors (MAF, MAP, IAT, ECT, TPS, pedal, TGV, fuel level) go straight to M1 inputs by net label.
Sensor returns C31/C34/C35 (GND_SENSOR): to GND through the fitted 0R, or to GNDA through the open link.

Install R770 for use with very hot VR signals,

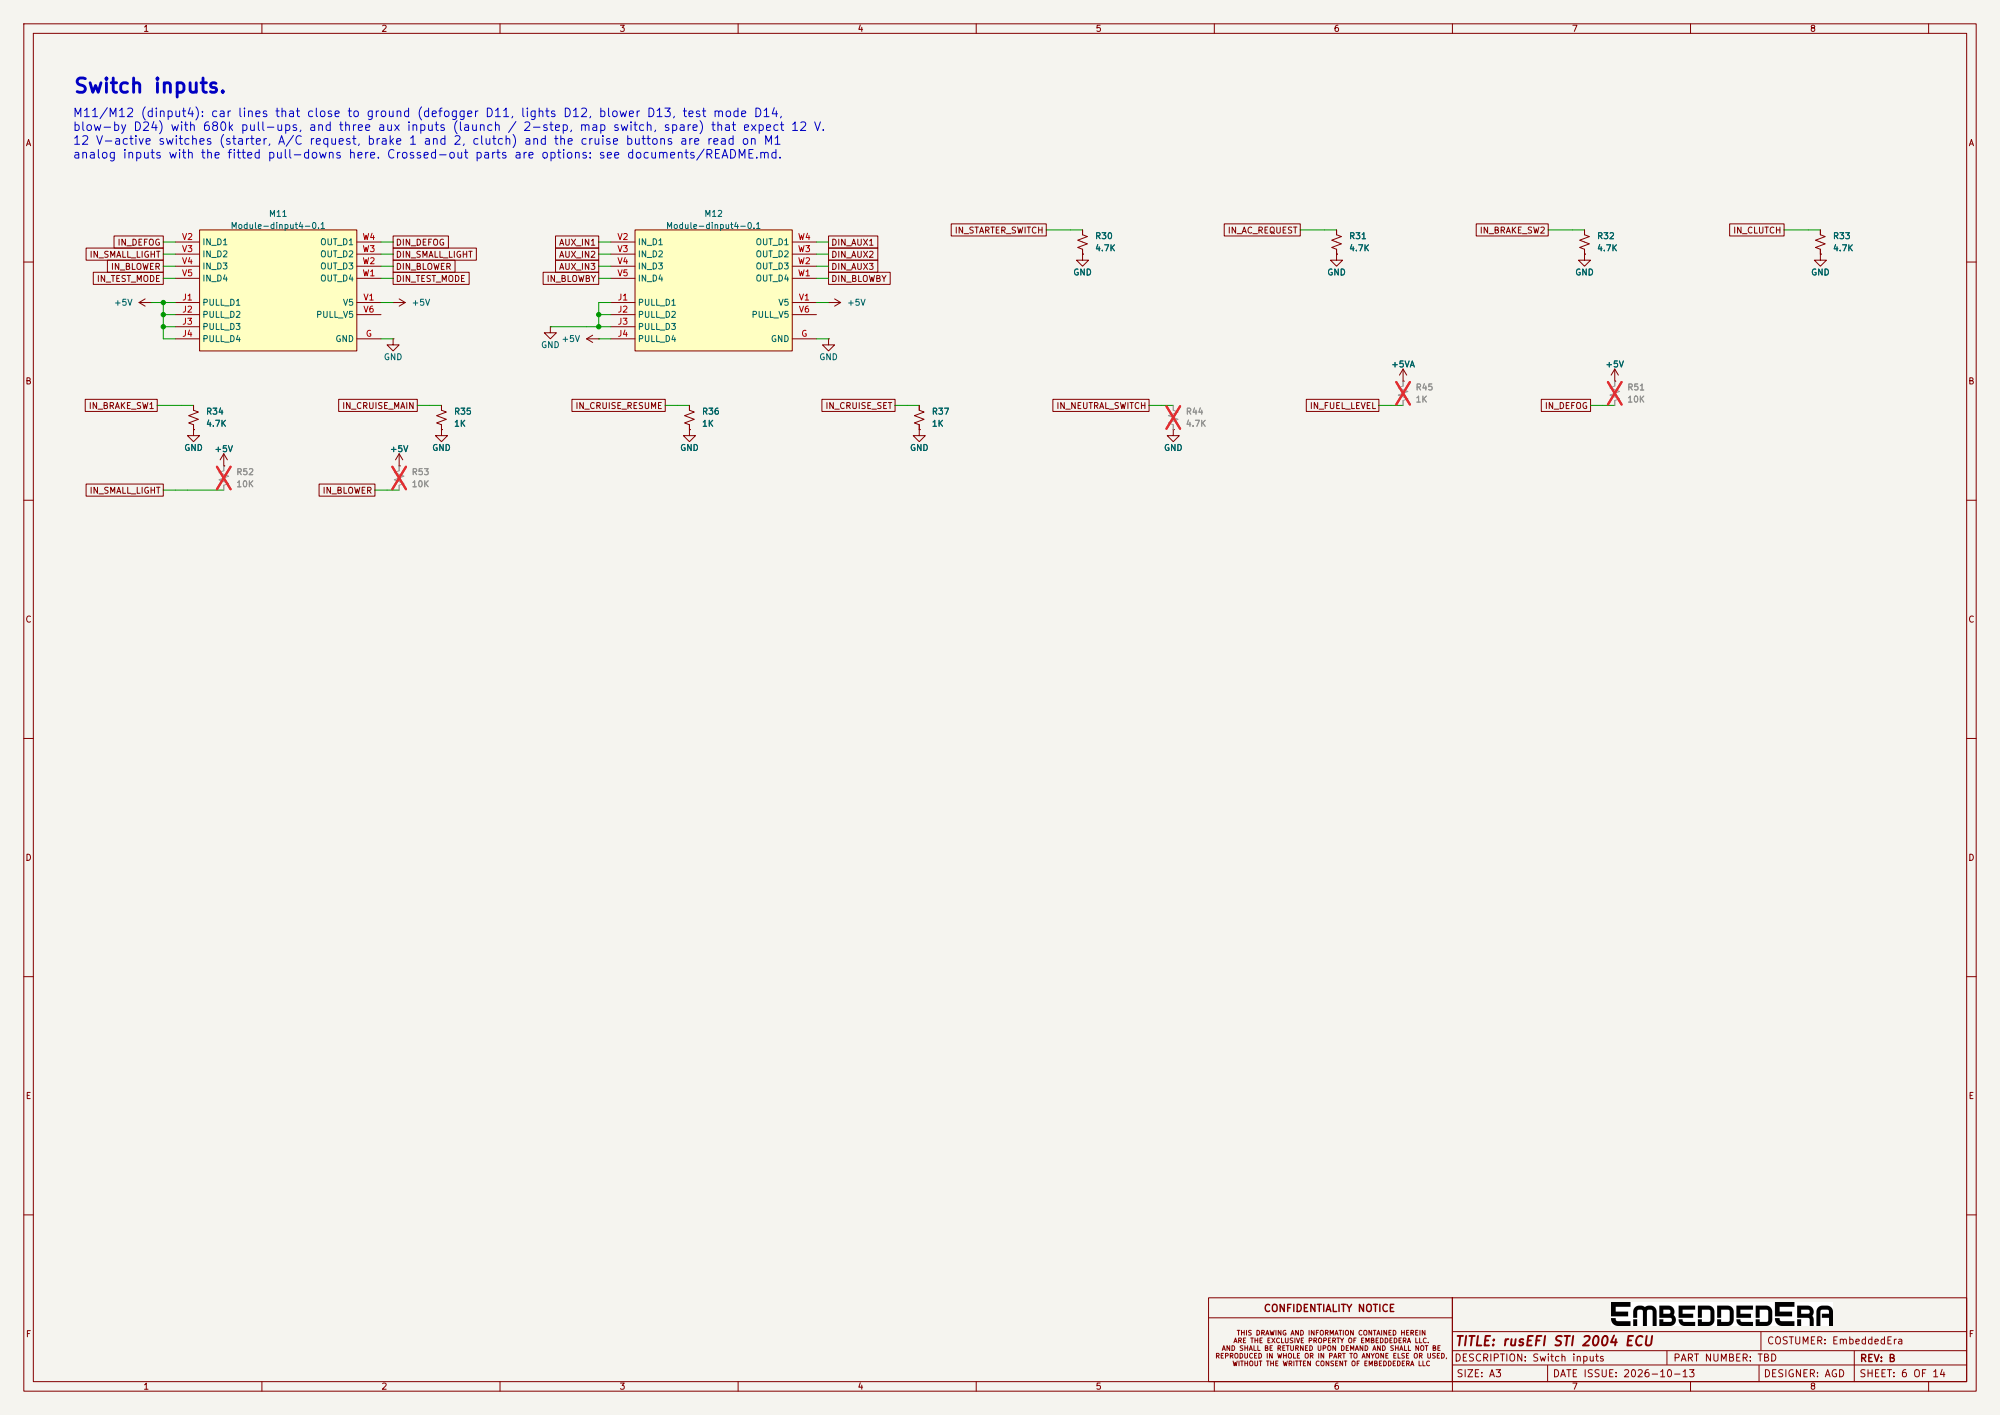
[picture p10: page 6]

M11/M12 (dinput4): car lines that close to ground (defogger D11, lights D12, blower D13, test mode D14,
blow-by D24) with 680k pull-ups, and three aux inputs (launch / 2-step, map switch, spare) that expect 12 V.
12 V-active switches (starter, A/C request, brake 1 and 2, clutch) and the cruise buttons are read on M1

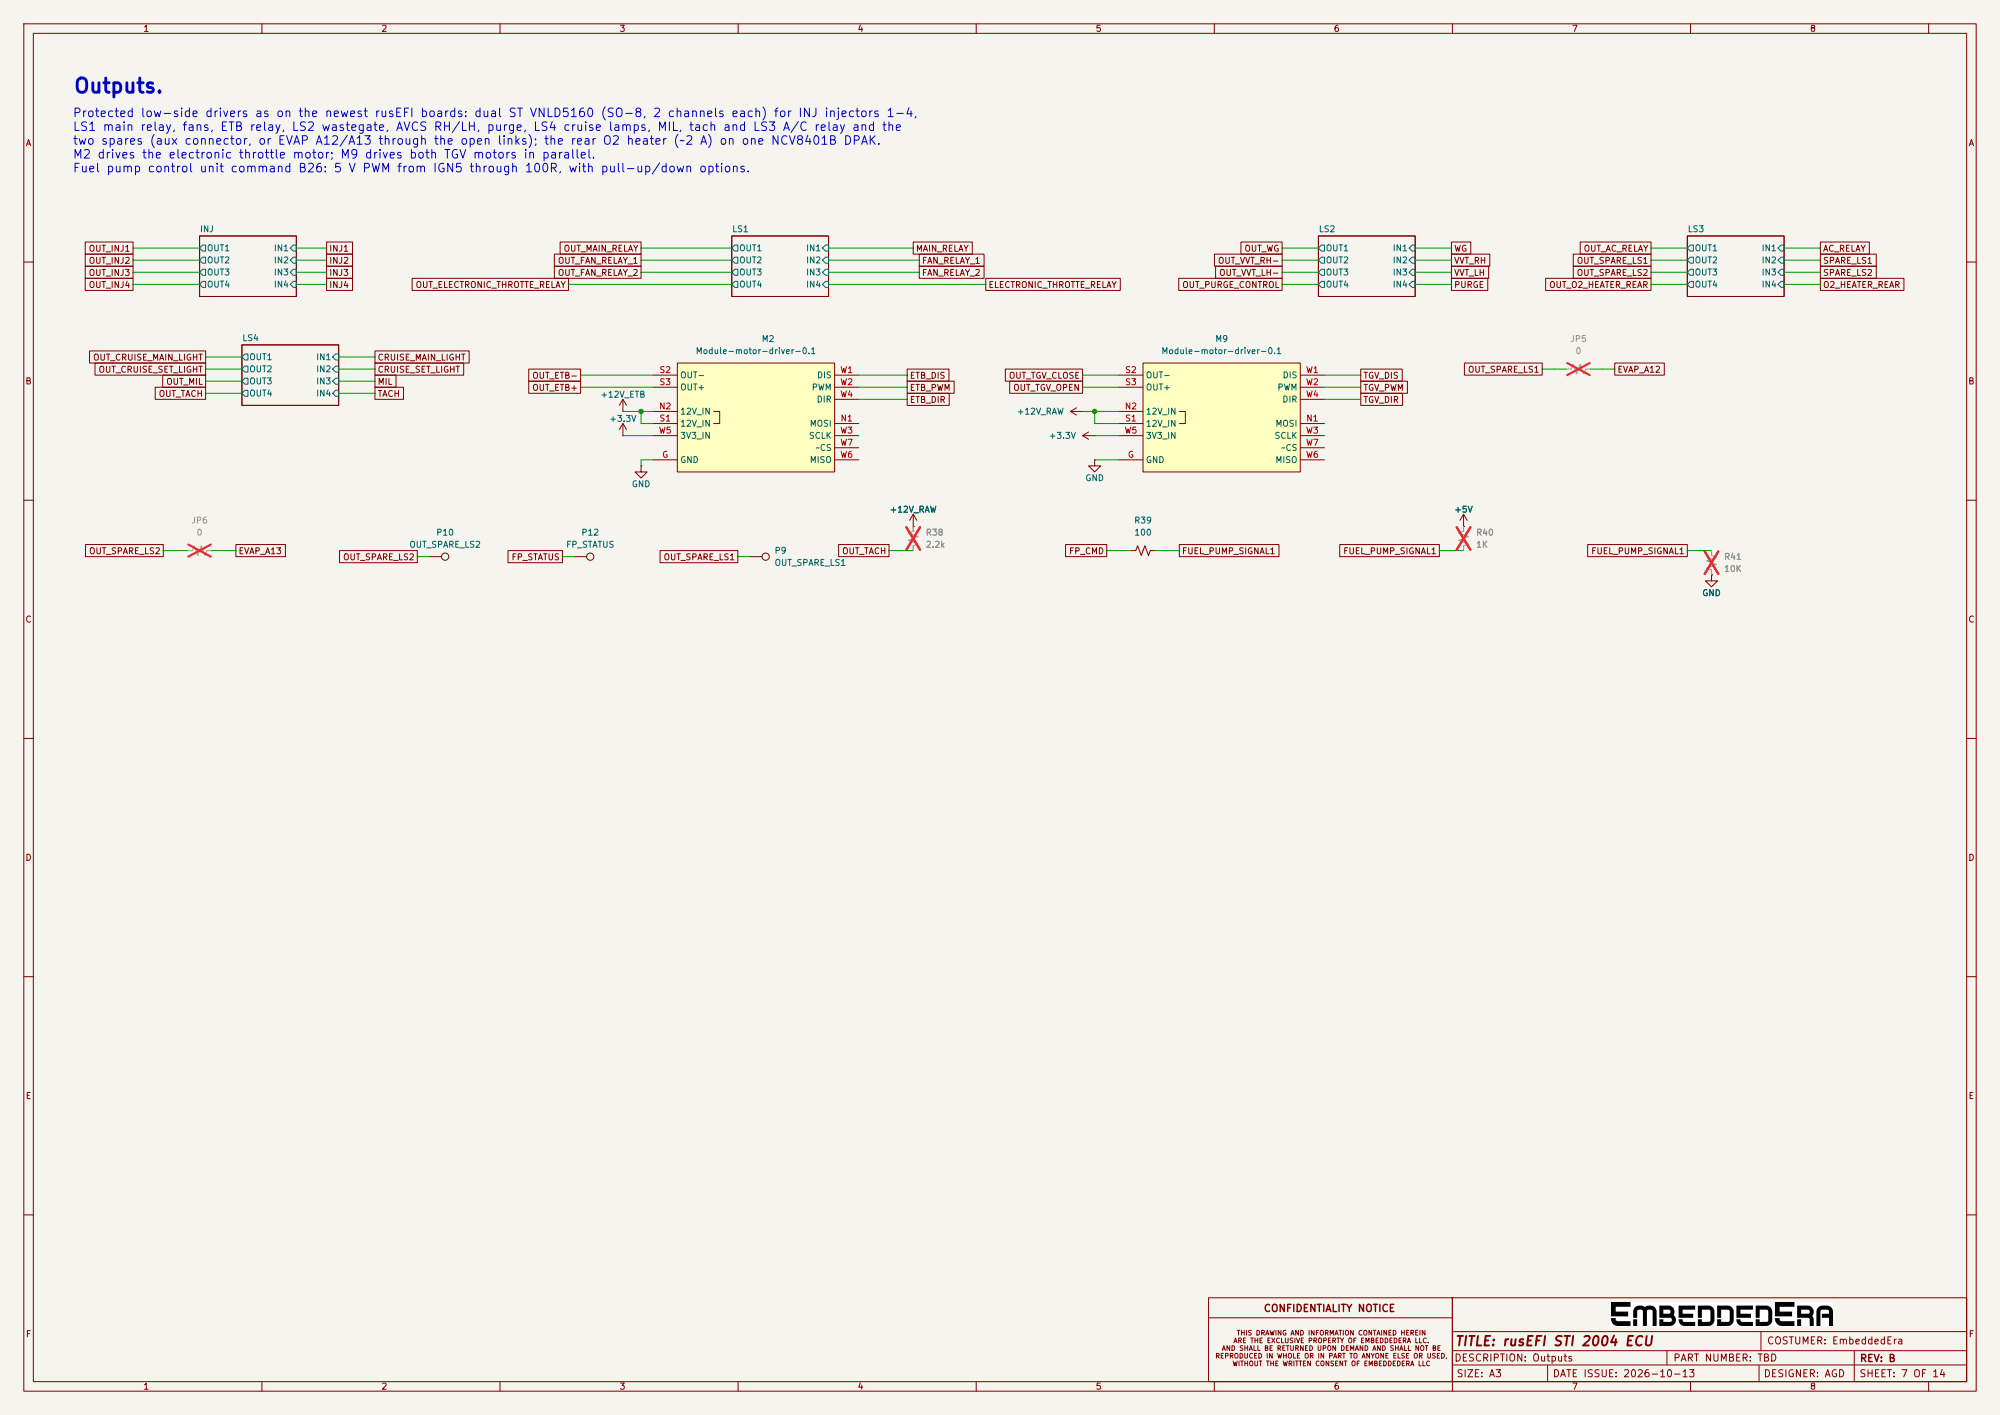
[picture p11: page 7]

Protected low-side drivers as on the newest rusEFI boards: dual ST VNLD5160 (SO-8, 2 channels each) for INJ injectors 1-4,
LS1 main relay, fans, ETB relay, LS2 wastegate, AVCS RH/LH, purge, LS4 cruise lamps, MIL, tach and LS3 A/C relay and the
two spares (aux connector, or EVAP A12/A13 through the open links); the rear O2 heater (~2 A) on one NCV8401B DPAK.
M2 drives the electronic throttle motor; M9 drives both TGV motors in parallel.

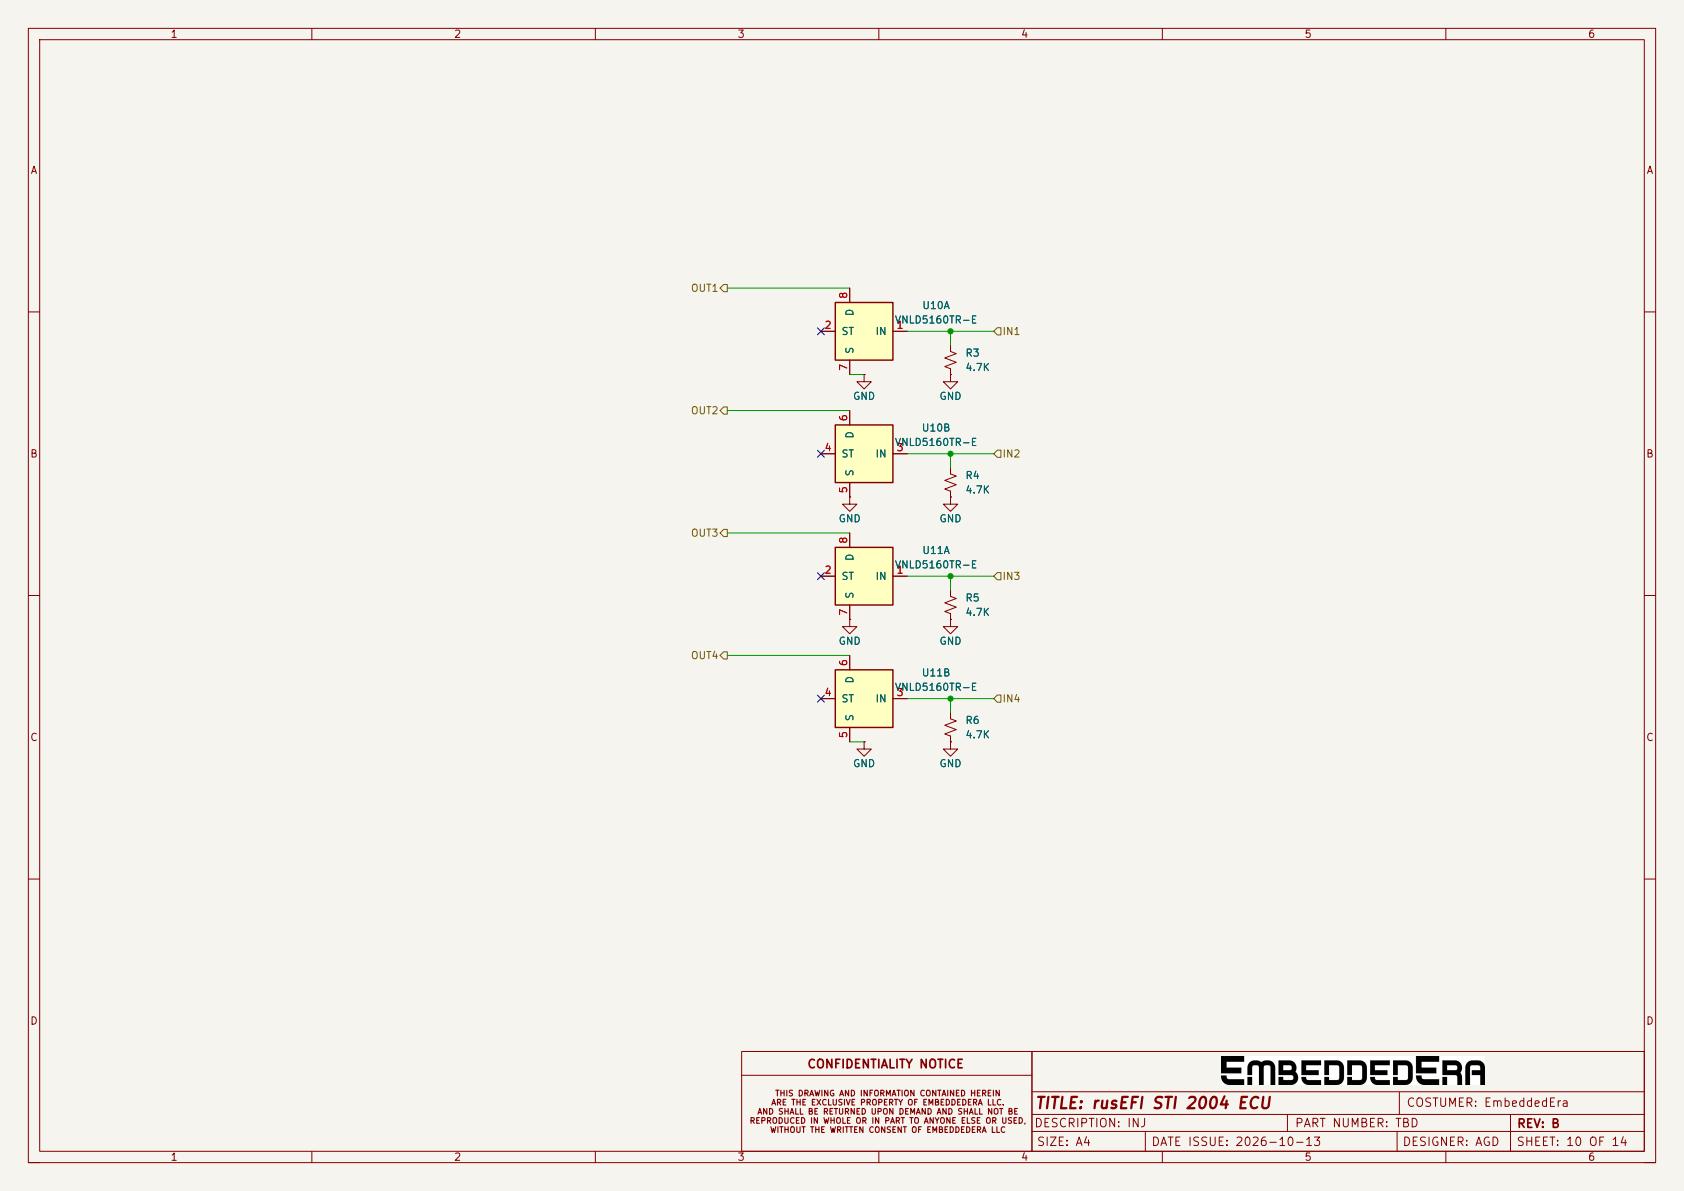
[picture p12: page 8]

D DATE ISSUE: 2026-10-13

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

DESCRIPTION: INJ | PART NUMBER: TBD
SIZE: A4 | | | SHEET: 10 OF 14

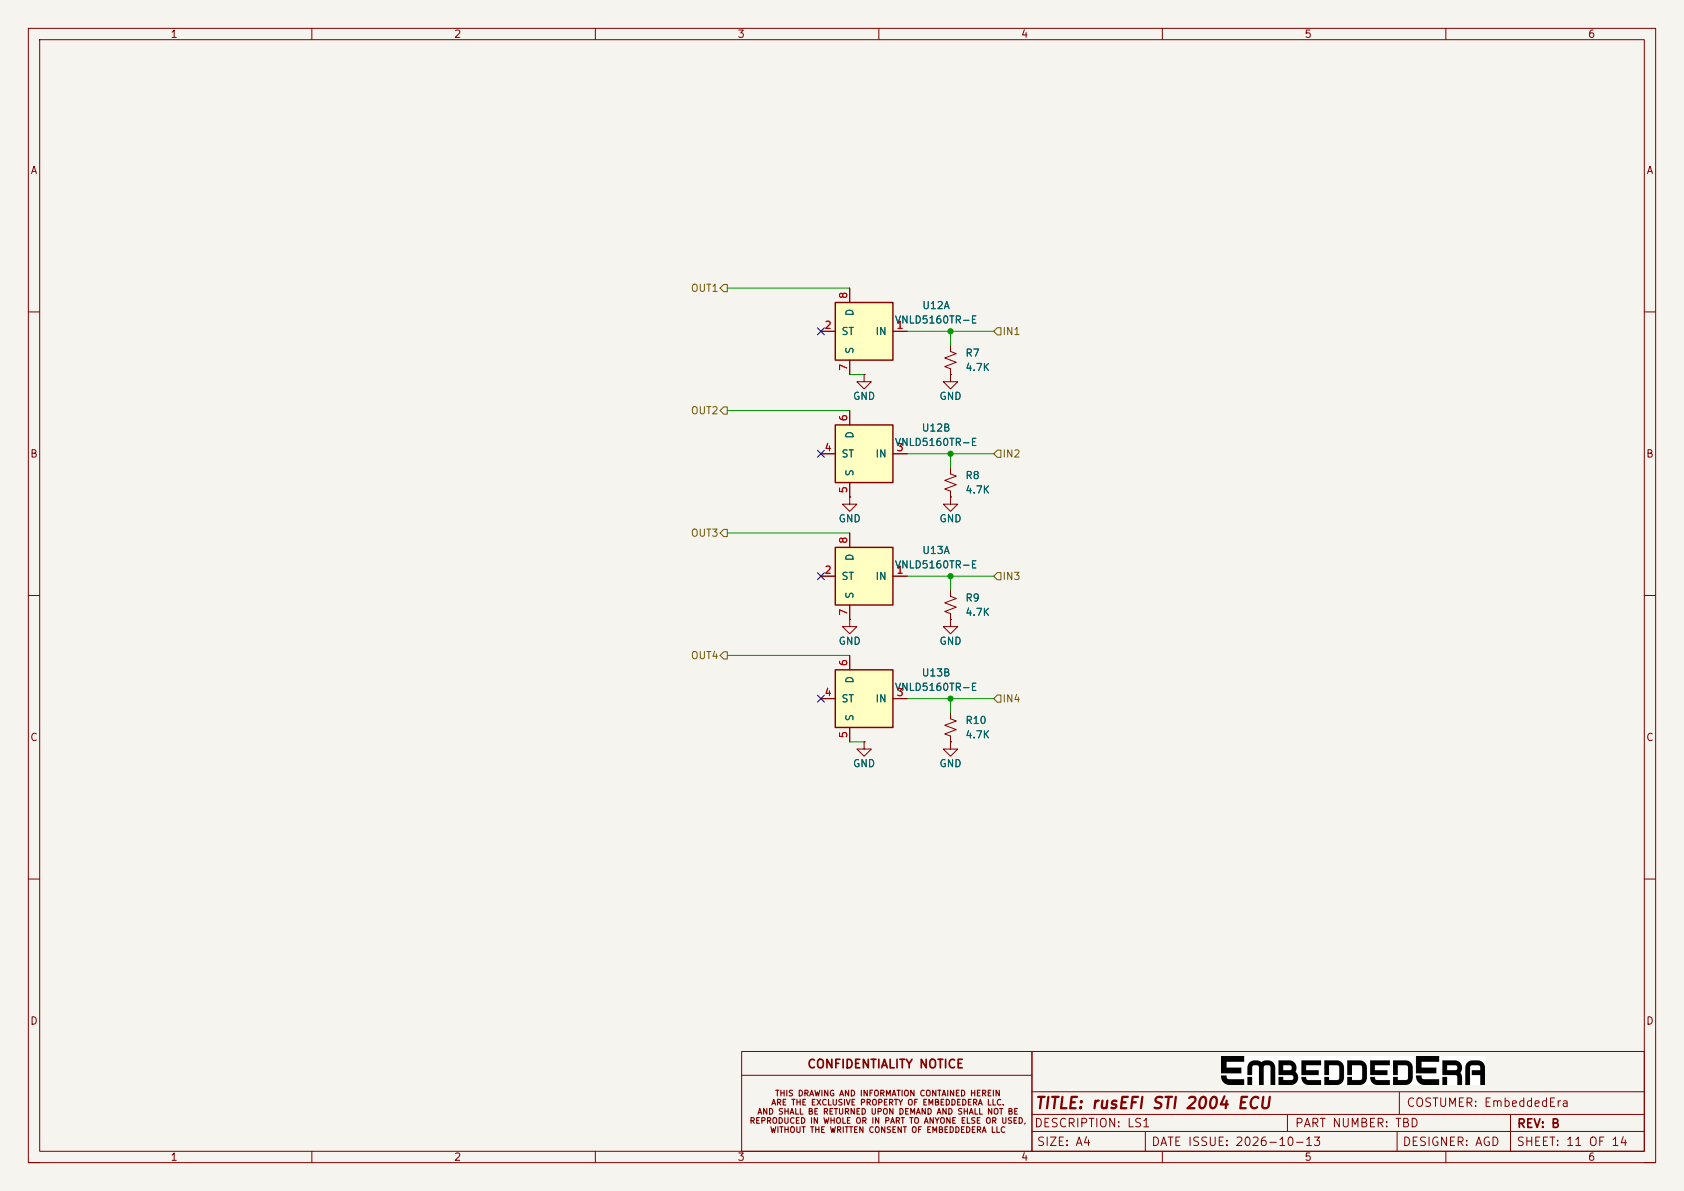
[picture p13: page 9]

D DATE ISSUE: 2026-10-13

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

DESCRIPTION: LS1 | PART NUMBER: TBD
SIZE: A4 | | | SHEET: 11 OF 14

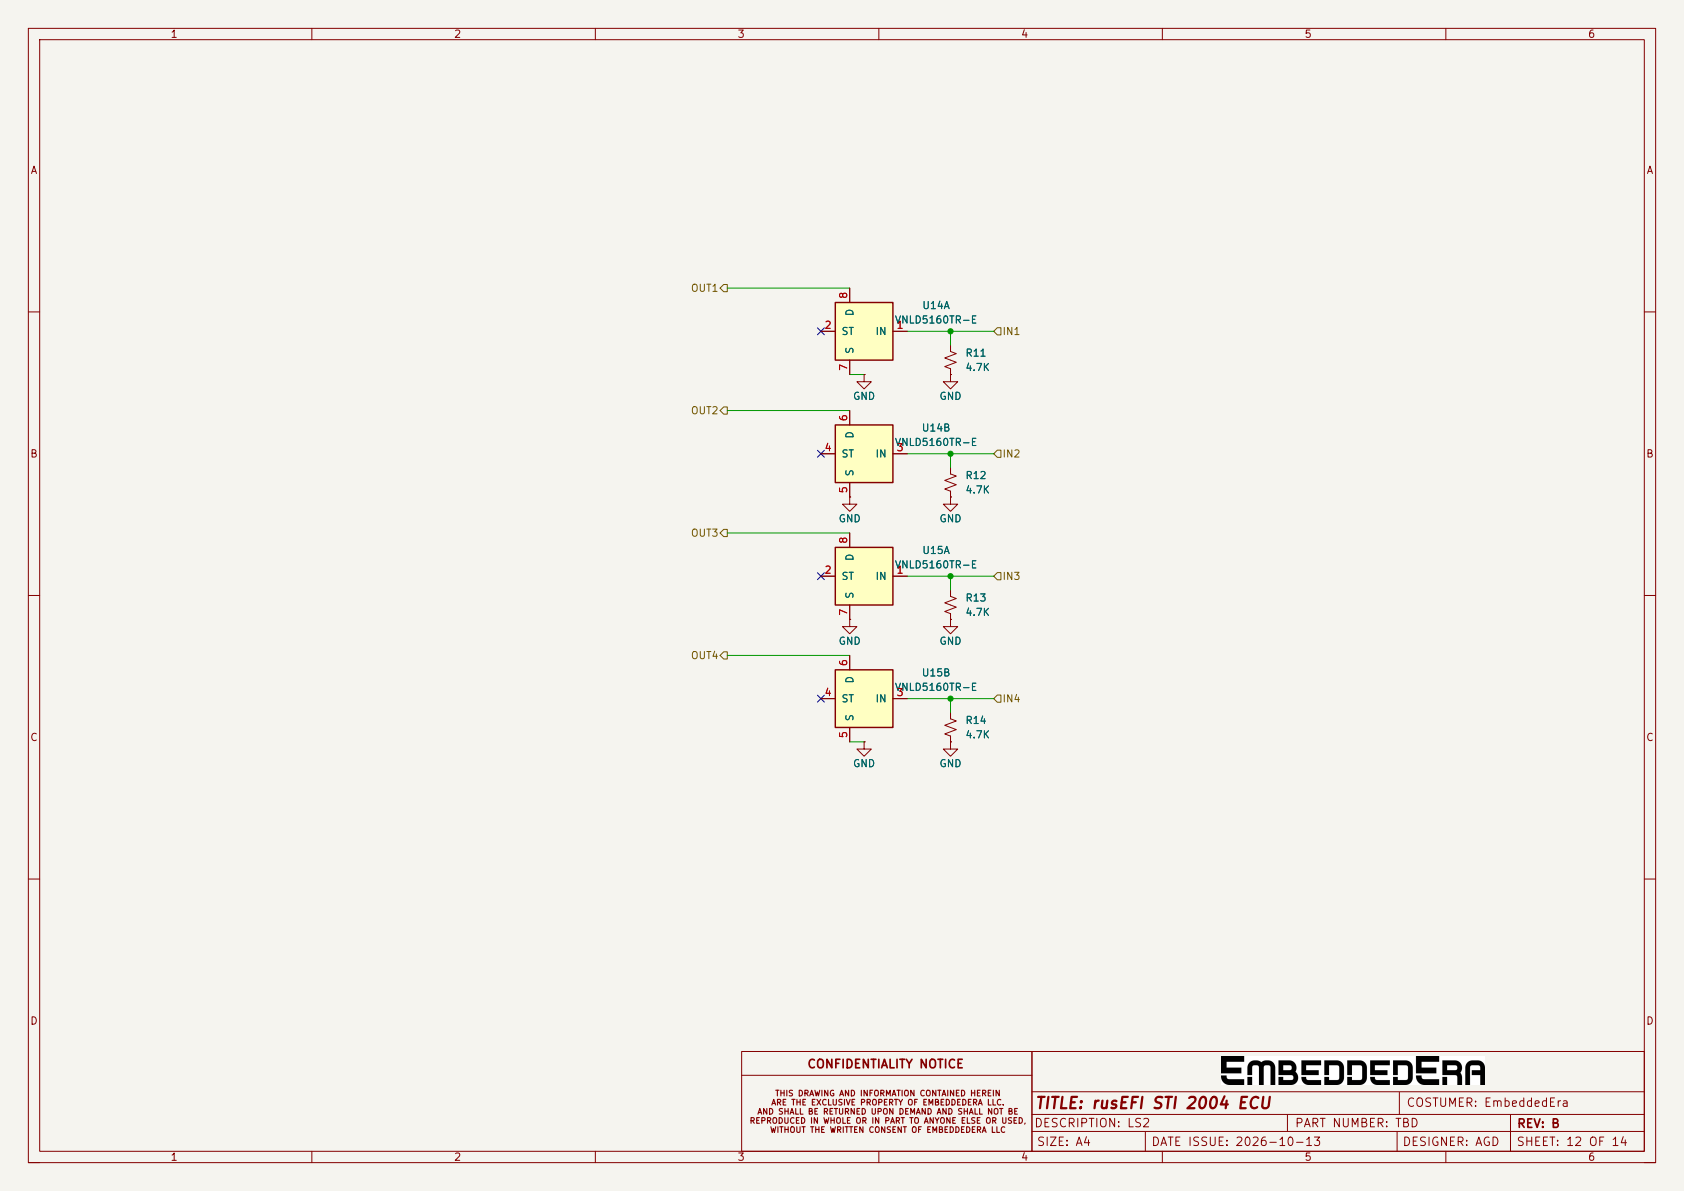
[picture p14: page 10]

D DATE ISSUE: 2026-10-13

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

DESCRIPTION: LS2 | PART NUMBER: TBD
SIZE: A4 | | | SHEET: 12 OF 14

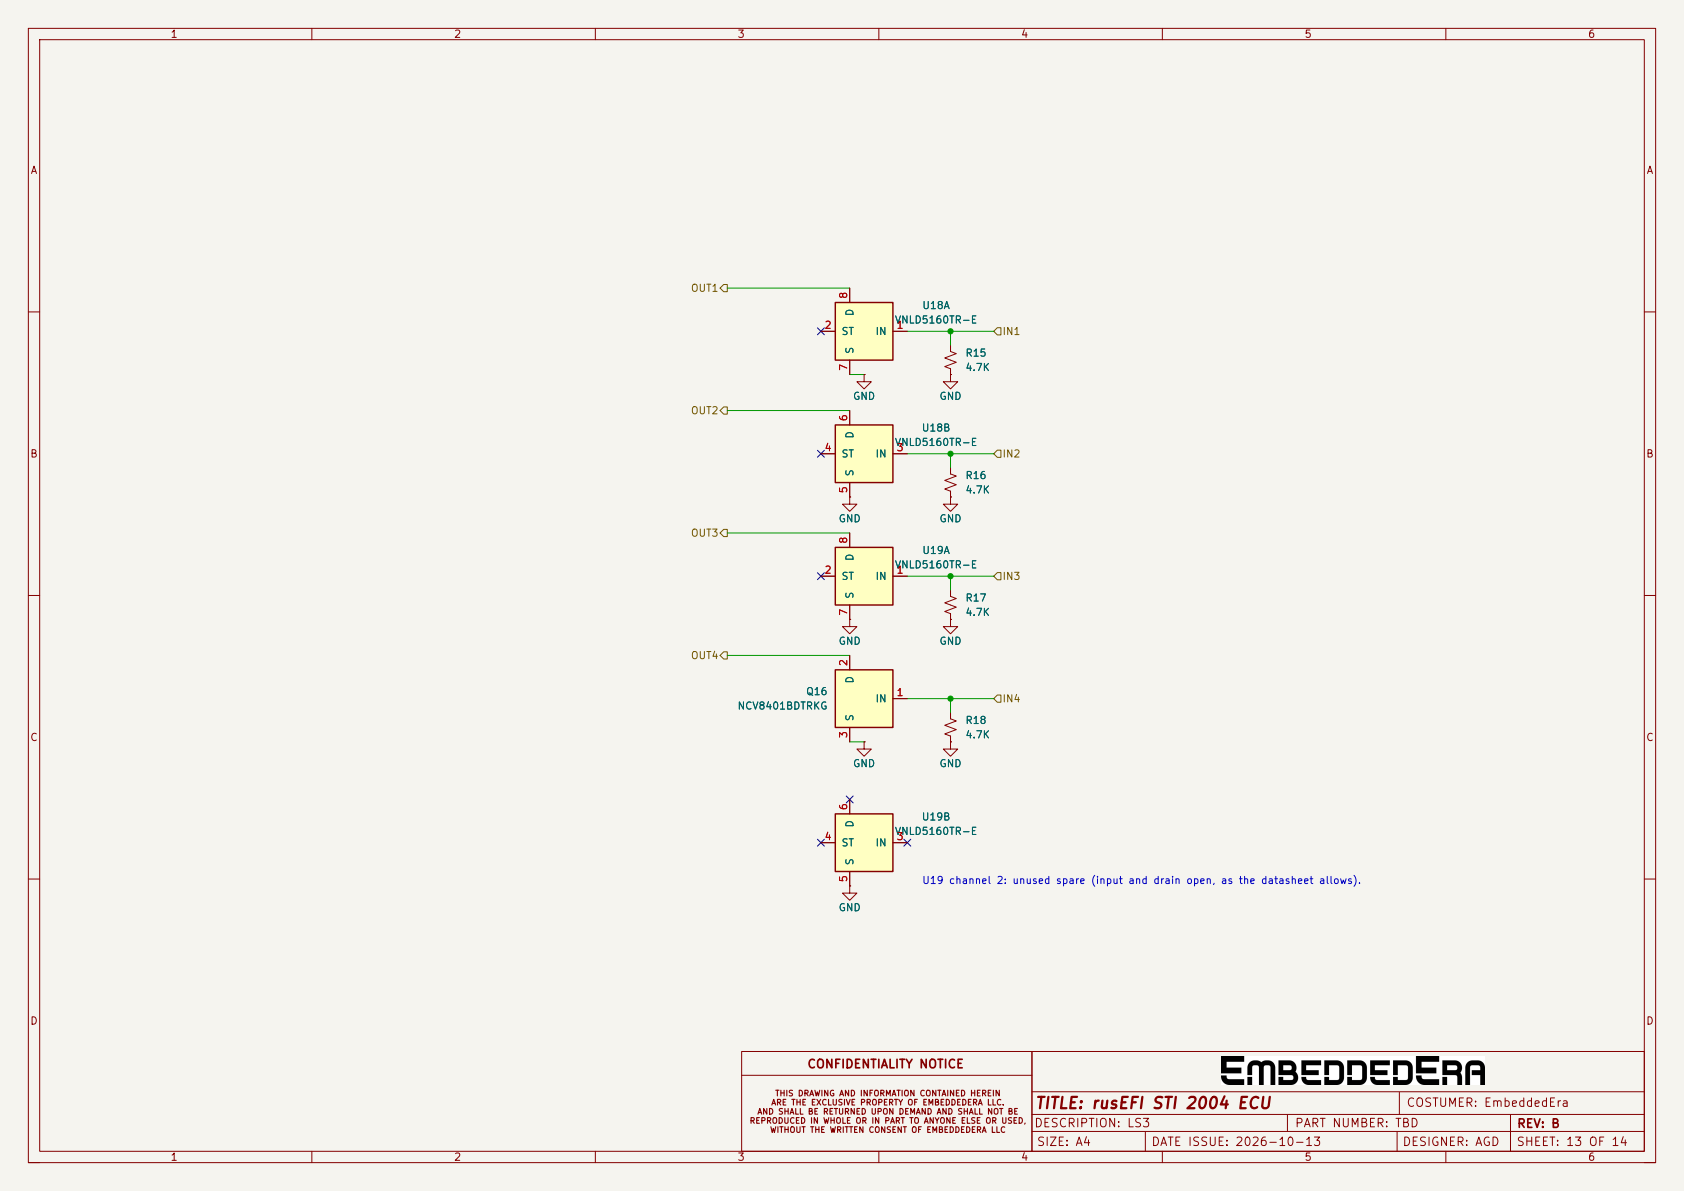
[picture p15: page 11]

D DATE ISSUE: 2026-10-13

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

DESCRIPTION: LS3 | PART NUMBER: TBD
SIZE: A4 | | | SHEET: 13 OF 14

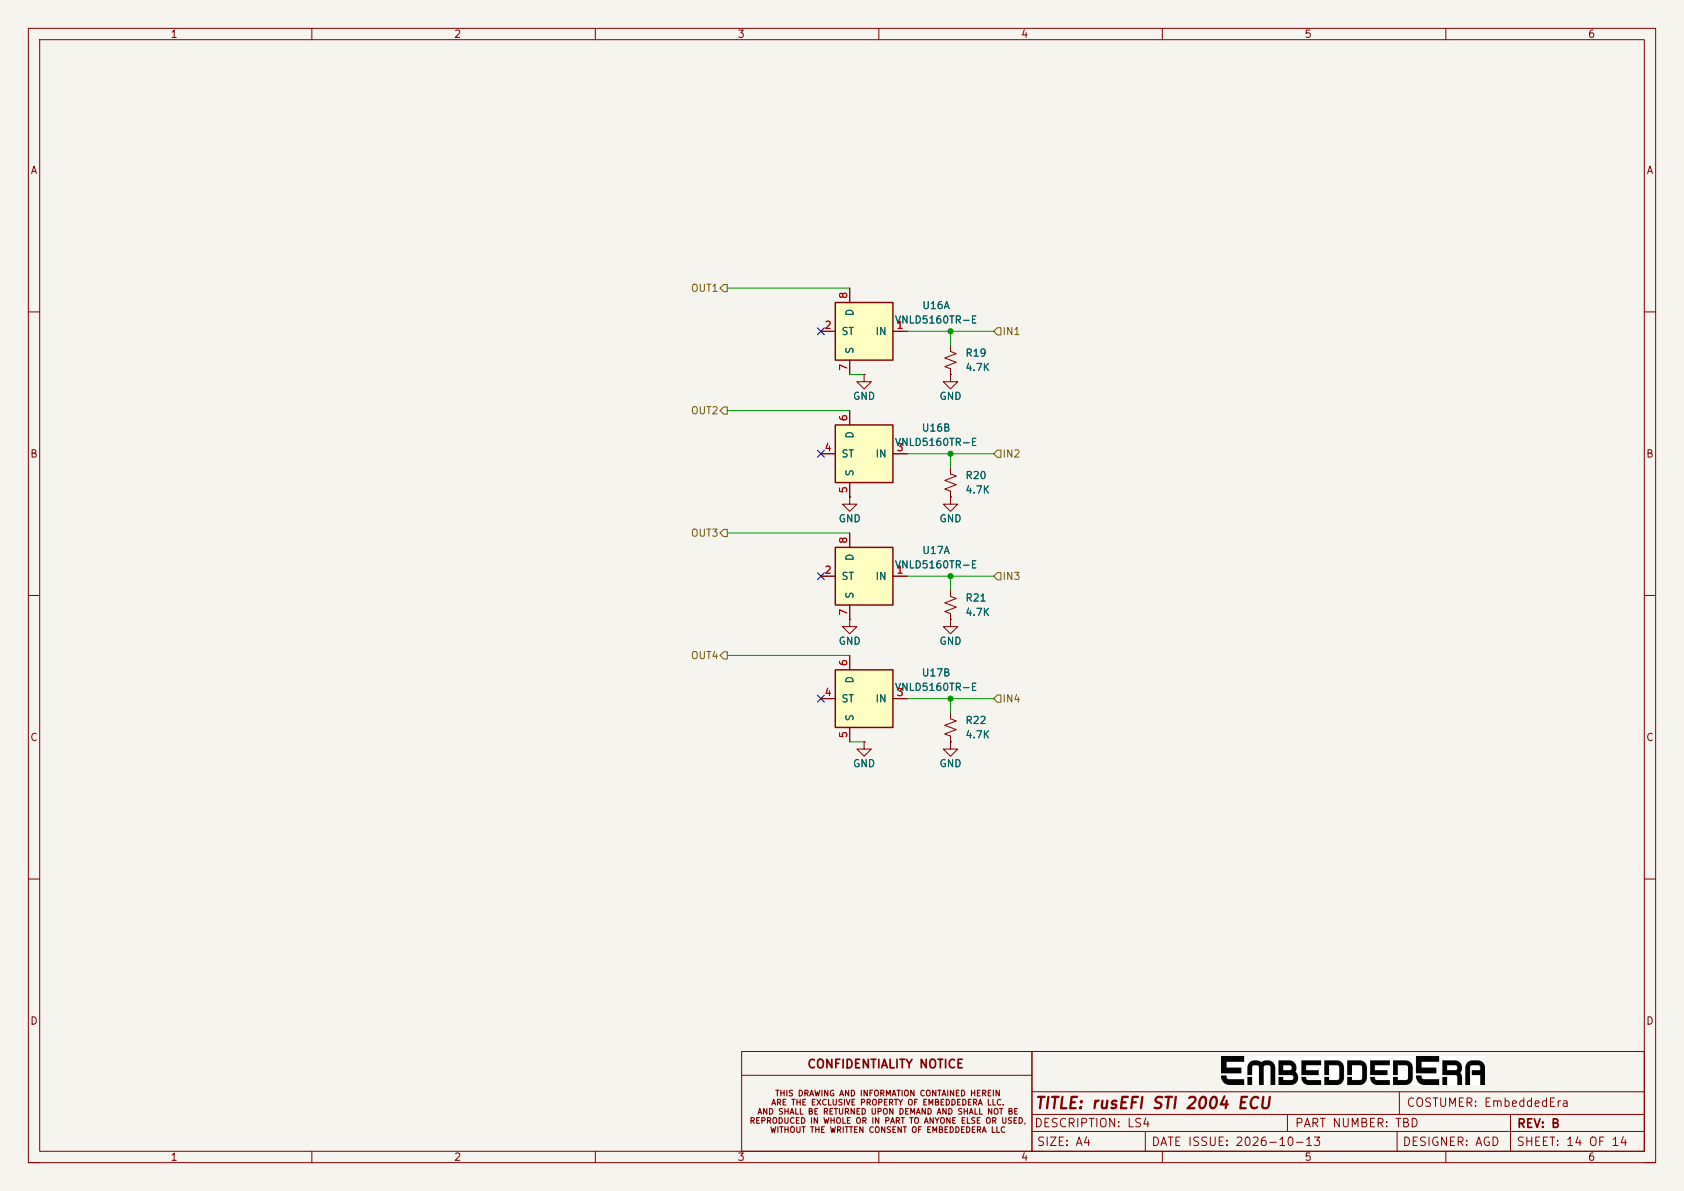
[picture p16: page 12]

D DATE ISSUE: 2026-10-13

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

DESCRIPTION: LS4 | PART NUMBER: TBD
SIZE: A4 | | | SHEET: 14 OF 14

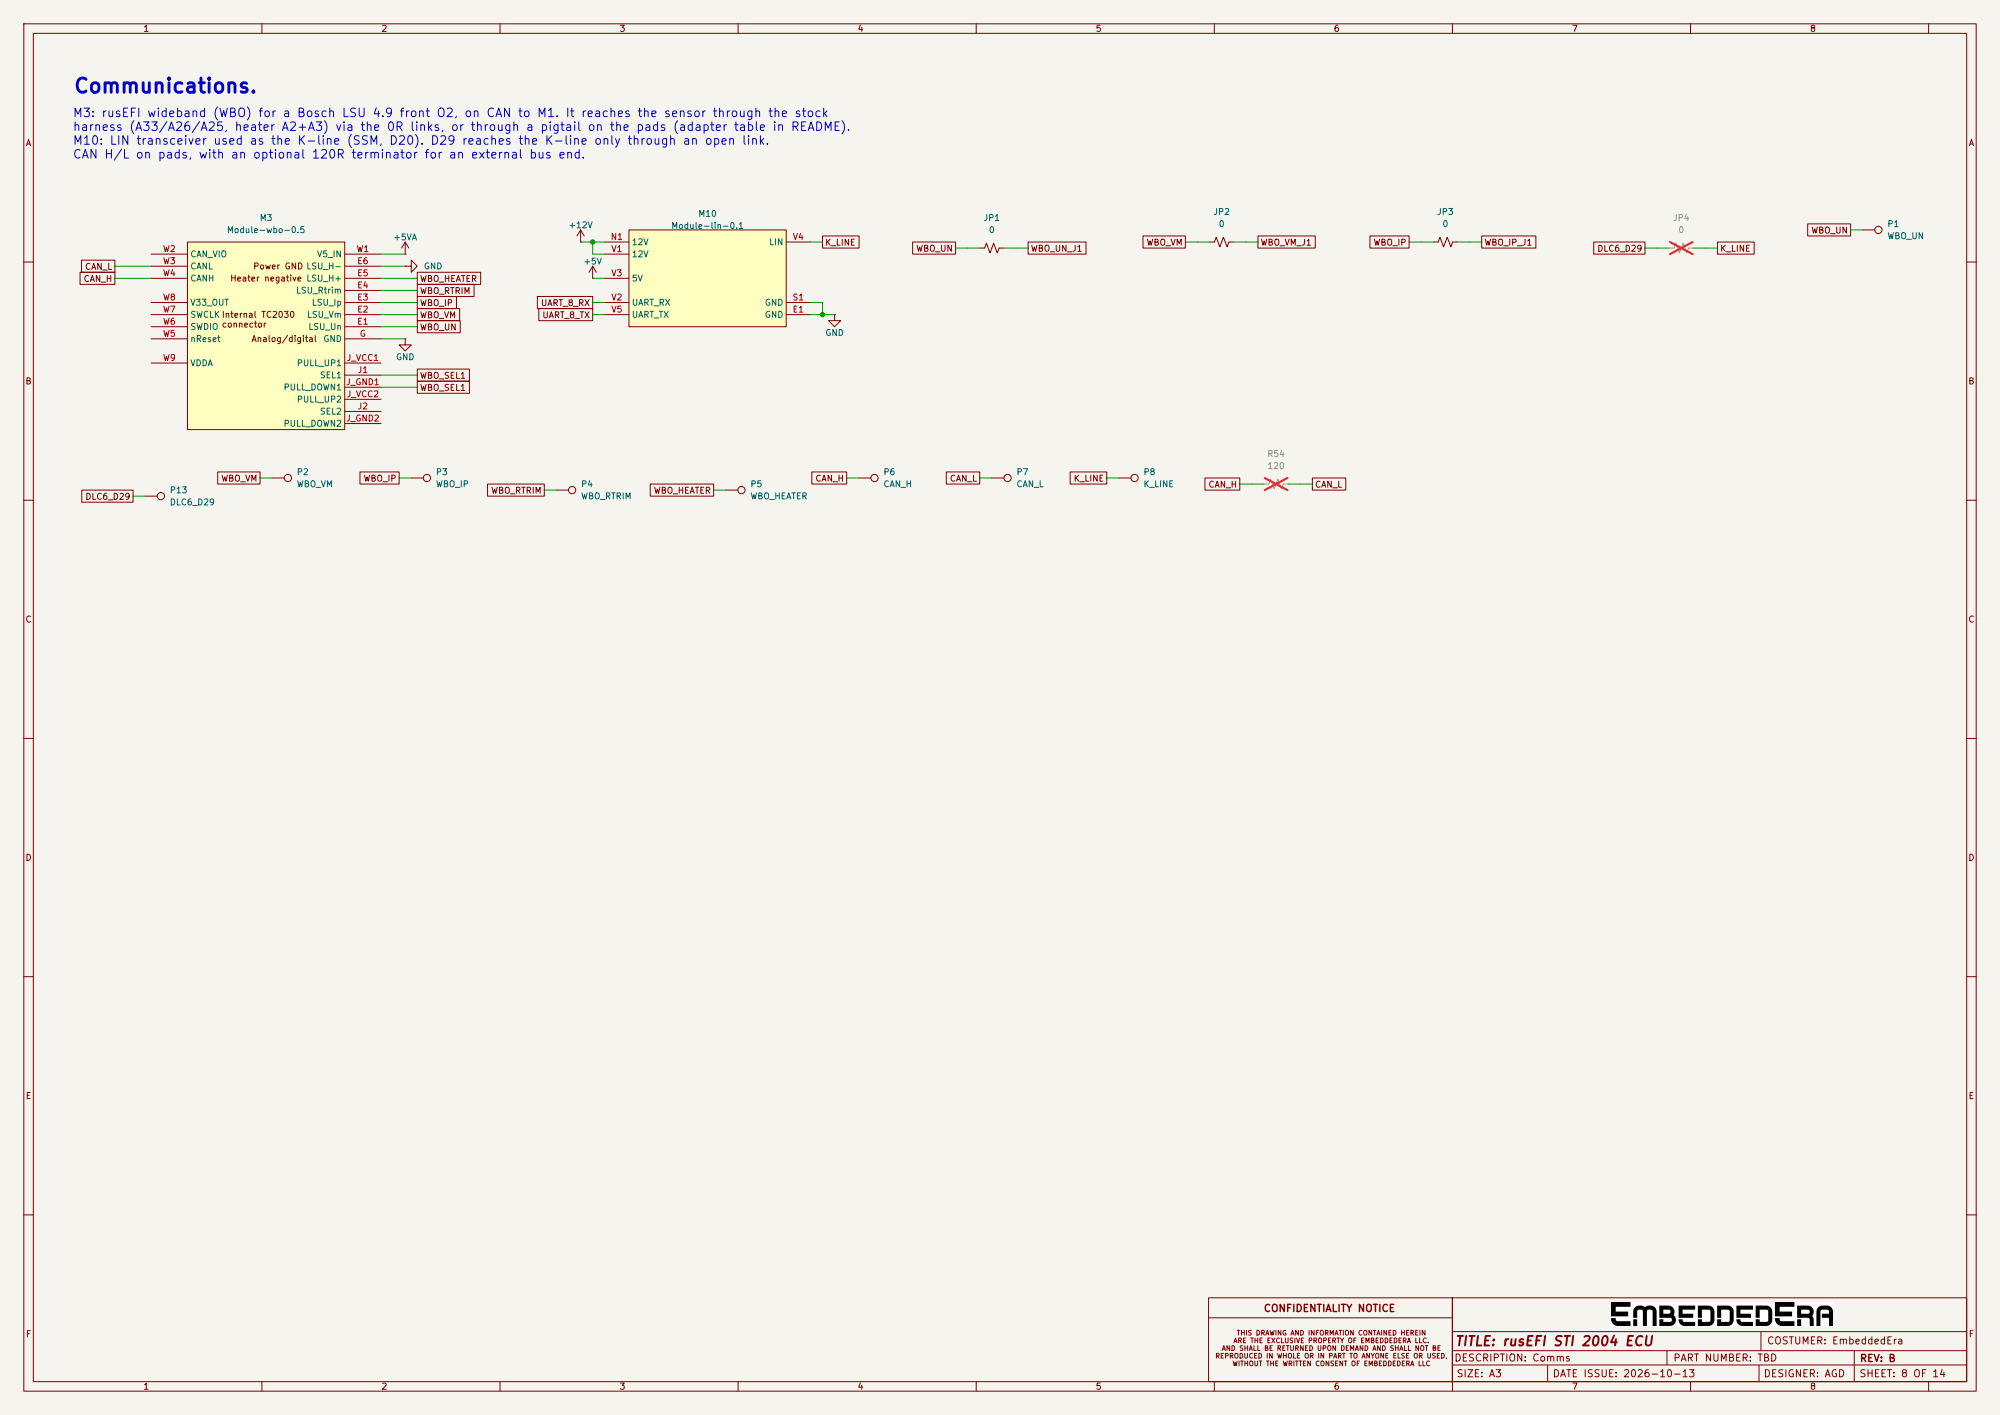
[picture p17: page 13]

M3: rusEFI wideband (WBO) for a Bosch LSU 4.9 front O2, on CAN to M1. It reaches the sensor through the stock
harness (A33/A26/A25, heater A2+A3) via the 0R links, or through a pigtail on the pads (adapter table in README).
M10: LIN transceiver used as the K-line (SSM, D20). D29 reaches the K-line only through an open link.
CAN H/L on pads, with an optional 120R terminator for an external bus end.

connector Heater negative Power GND

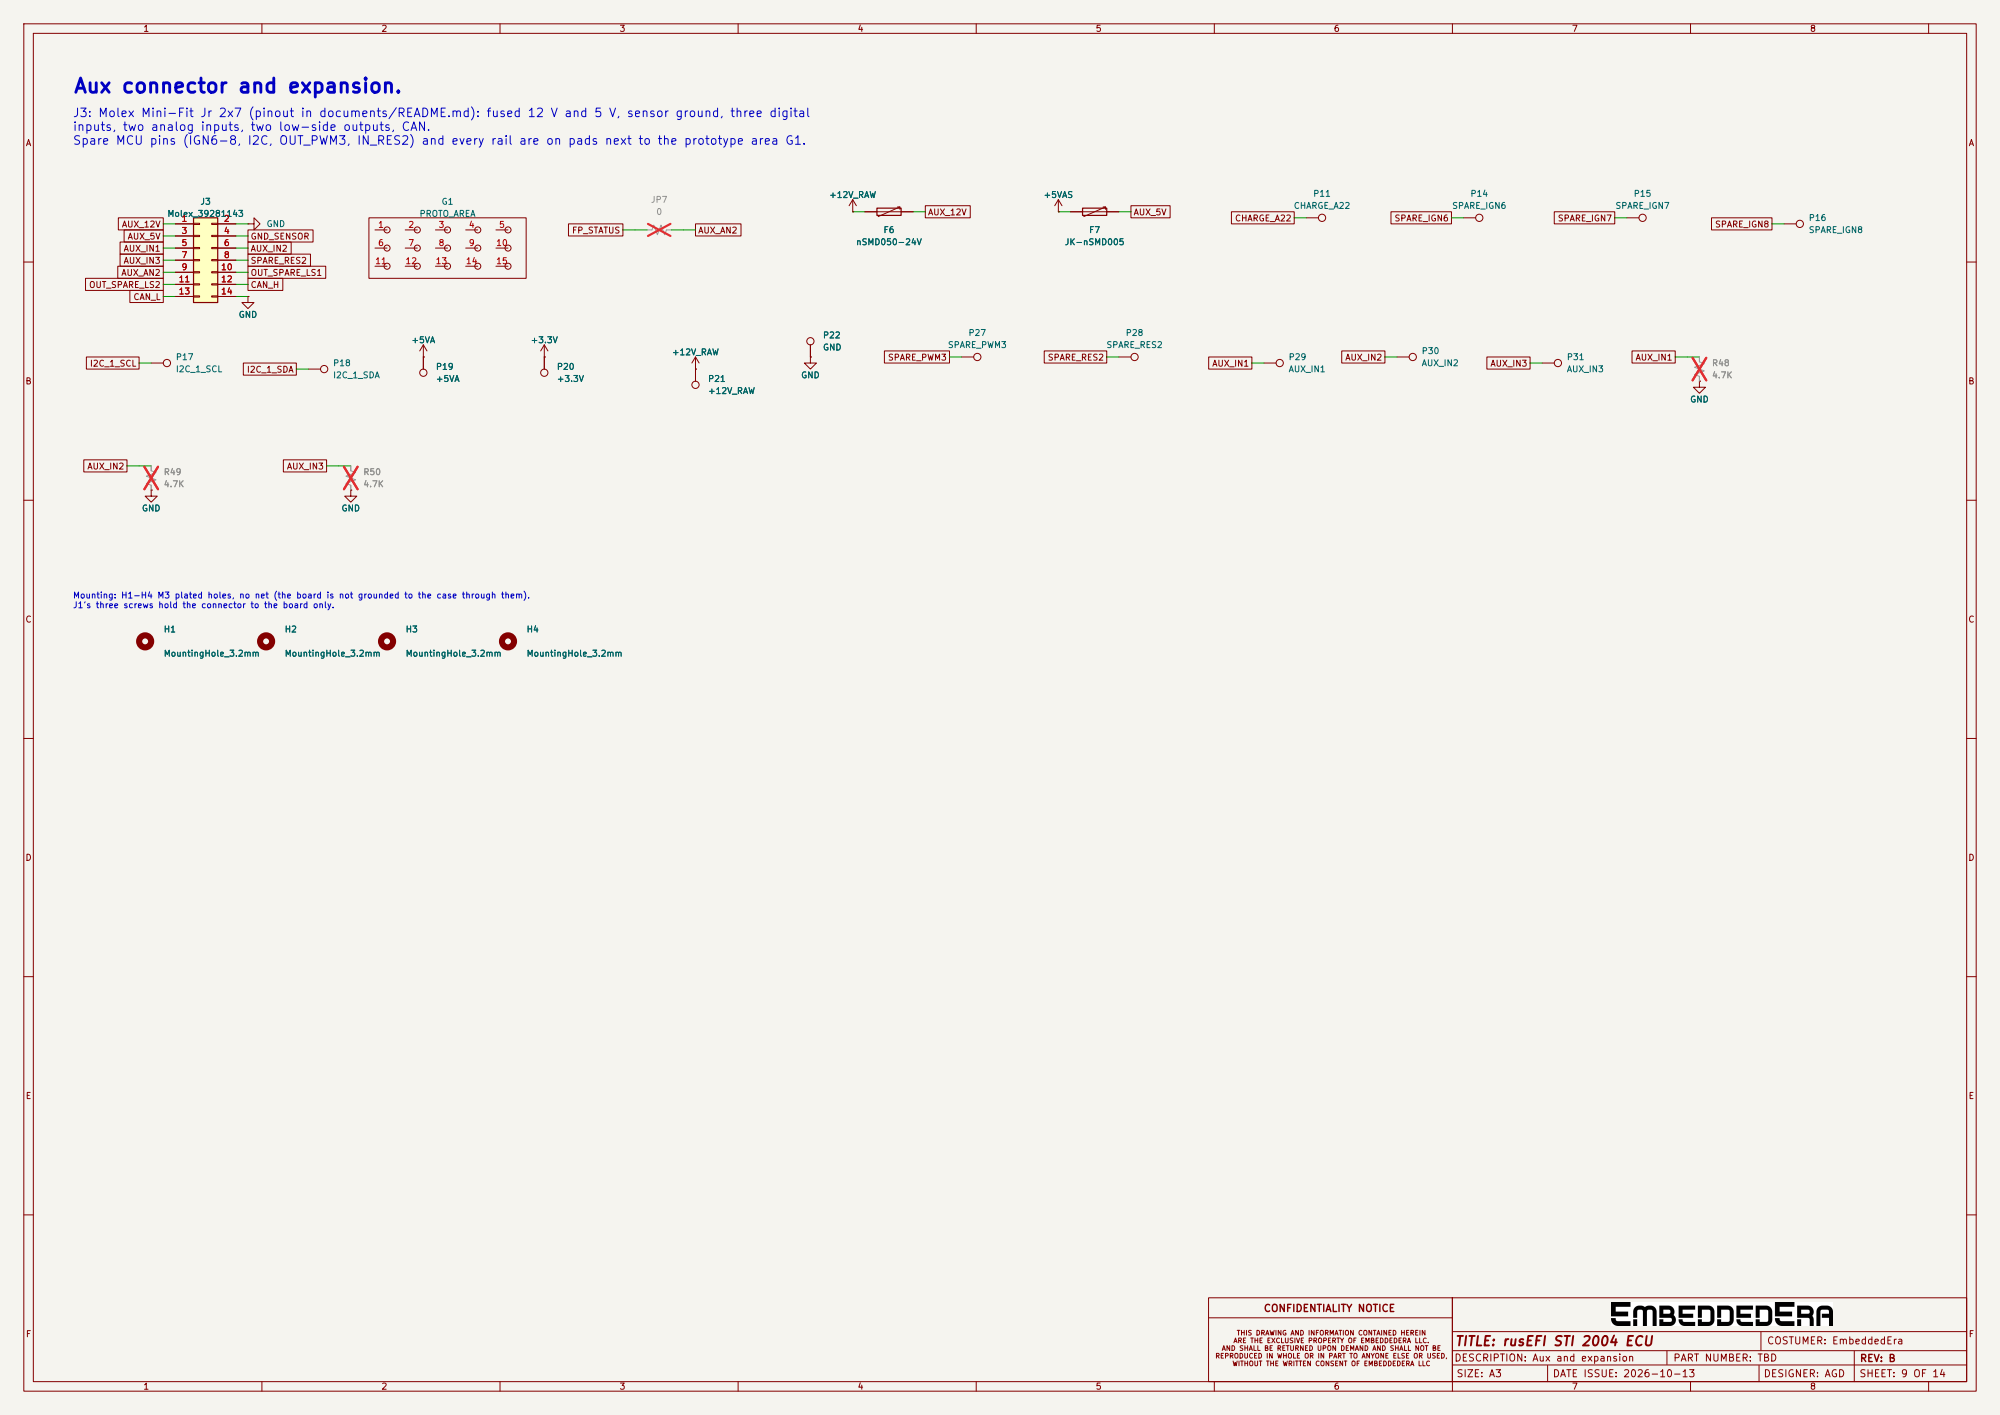
[picture p18: page 14]

Aux connector and expansion.

AUX_IN3 J3: Molex Mini-Fit Jr 2x7 (pinout in documents/README.md): fused 12 V and 5 V, sensor ground, three digital
inputs, two analog inputs, two low-side outputs, CAN.
Spare MCU pins (IGN6-8, I2C, OUT_PWM3, IN_RES2) and every rail are on pads next to the prototype area G1.
AUX_IN3 GND_SENSOR
AUX_IN2
