angelEmbeddedEra/rusefi-sti-2004/boards/rusefiSTI2004-a/board/rusefiSTI2004-a-schematic.pdf

on | this I2C bus CAN_WKUP
N1 SPI3_CS | N10 SPI3_SCK | N11 SPI3_MISO

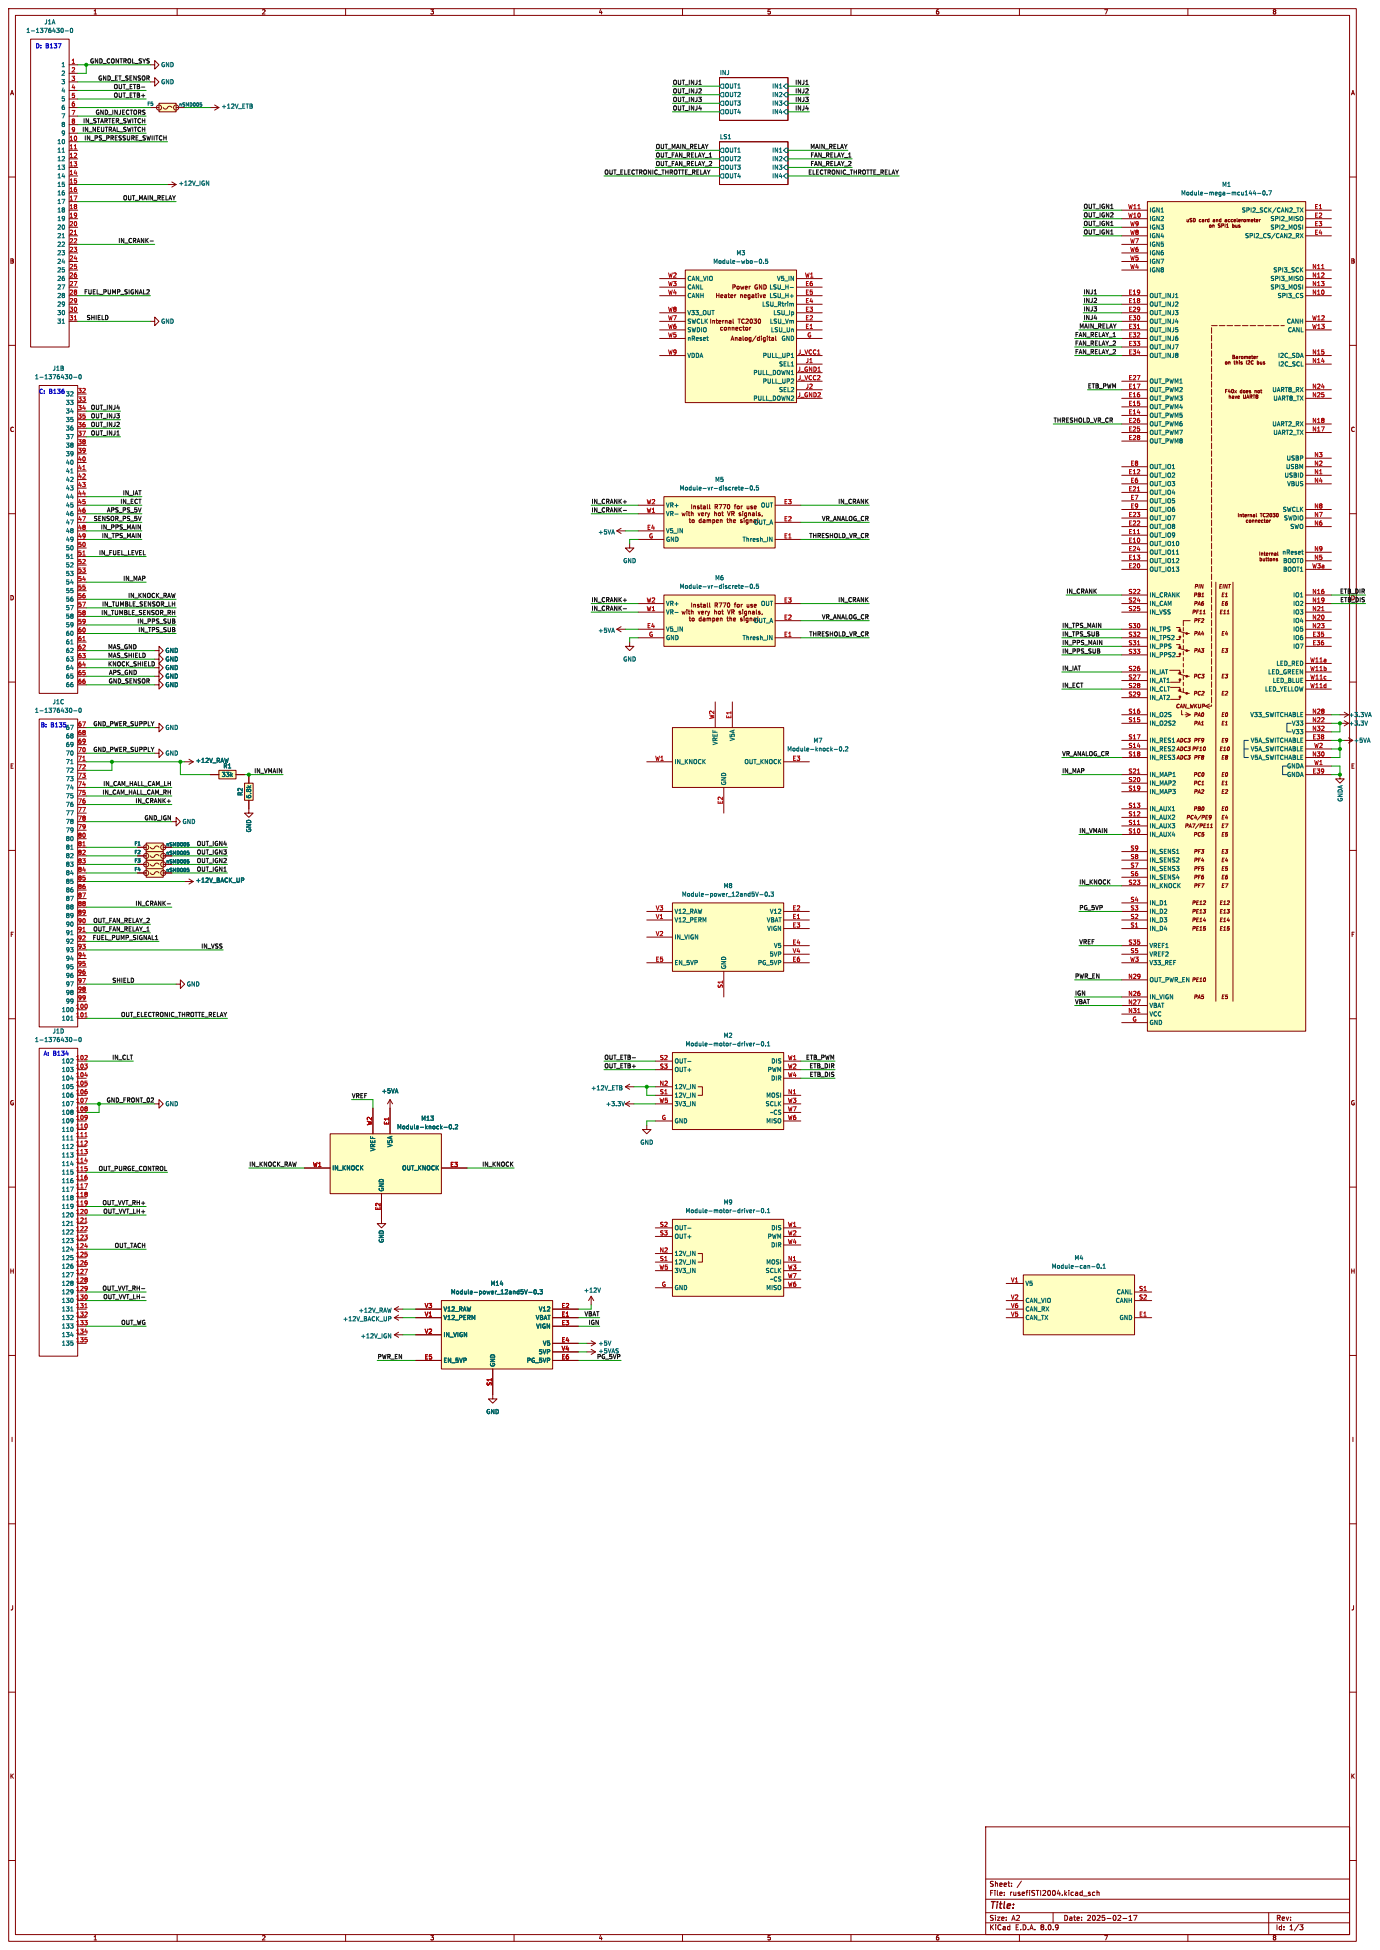
[picture p19: page 1]

Analog/digital Heater negative Power GND

IN_PPS_SUB
IN_TPS_SUB
GND GND GND GND GND GND GND

GND GND GND GND GND

Id: 1/3 Title: File: rusefiSTI2004.kicad_sch Sheet: /

IN 1 D ² S 3 Q2 VND14NV04-E | IN 1 D ² S 3 | GND R³ 4.7k GND Q4 VND14NV04-E

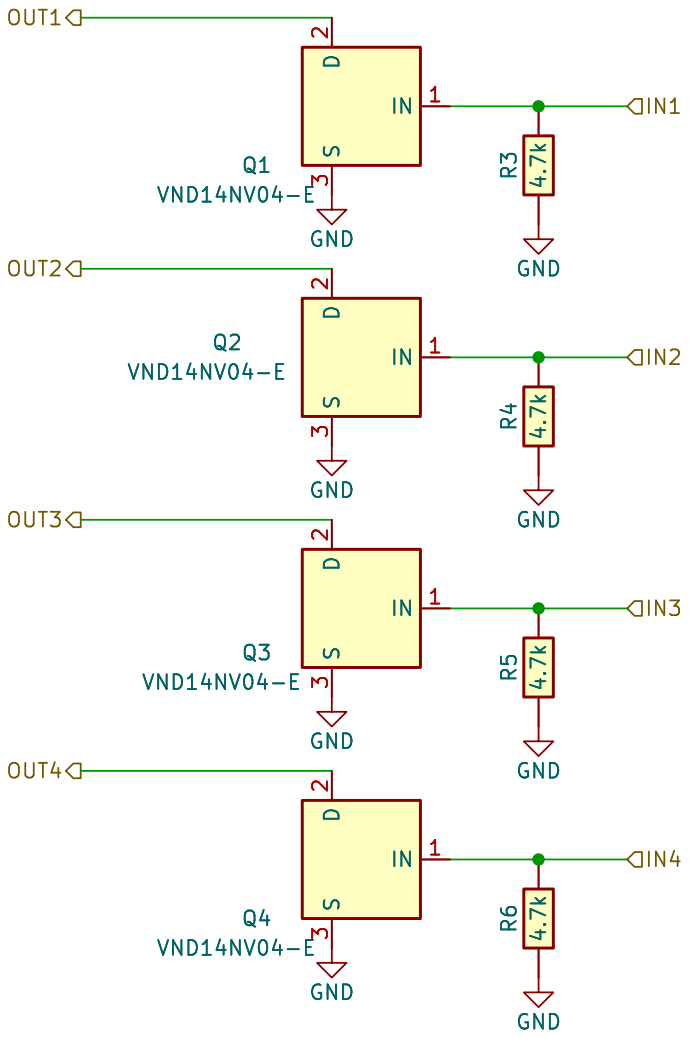
[picture p20: page 2]
6 ABCD; ABCD Date: KiCad; E.D.A. 8.0.9 Size: A4; Rev:; IN 1 D ² S 3 Q3 VND14NV04-E; R⁶ 4.7k GND R⁴ 4.7k GND GND; IN 1 D ² S 3Q4 VND14NV04-E; R³ 4.7k GND; IN 1 D ² S 3 Q2 VND14NV04-E; IN 1 D ² S 3Q1 VND14NV04-E; GND R⁵ 4.7k GND OUT1; IN3 OUT3 OUT4; IN2 OUT2; IN 1 D ² S 3 GND; GND R⁴ 4.7k GND R⁶ 4.7k Q3 VND14NV04-E

IN1 GND R⁵ 4.7k GND Q1 VND14NV04-E

Id: 2/3 Title: File: INJ4.kicad_sch Sheet: /INJ/ GND GND

IN 1 D ² S 3 GND Q6 VND14NV04-E | IN 1 D ² S 3 | GND R⁷ 4.7k Q8 VND14NV04-E

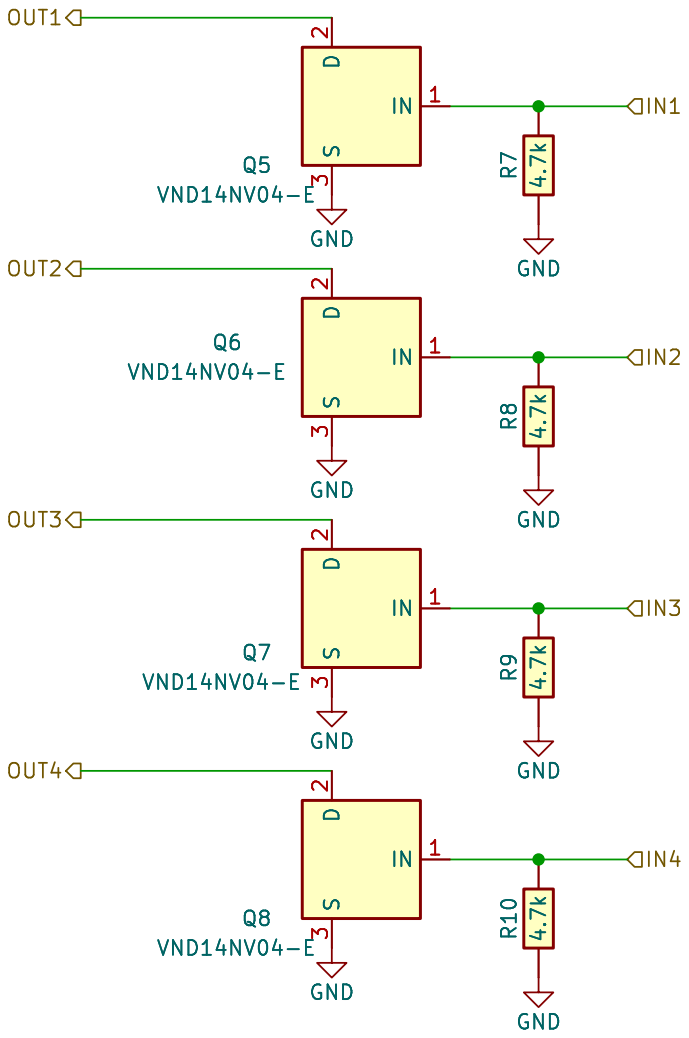
[picture p21: page 3]
6 ABCD; ABCD Date: KiCad; E.D.A. 8.0.9 Size: A4; Rev:; IN 1 D ² S 3Q8 VND14NV04-E GND; IN 1 D ² S 3 Q7 VND14NV04-E; R¹⁰ 4.7k GND R⁸ 4.7k GND GND GND; R⁷ 4.7k GND; IN 1 D ² S 3 Q6 VND14NV04-E; GND; GND R⁹ 4.7k; IN 1 D ² S 3Q5 VND14NV04-E OUT1; IN3 OUT3 OUT4; IN2 OUT2; IN1 GND R⁹ 4.7k Q5 VND14NV04-E; IN 1 D ² S 3 GND GND; GND R⁸ 4.7k GND R¹⁰ 4.7k Q7 VND14NV04-E; IN 1 D ² S 3 GND

Id: 3/3 Title: File: INJ4.kicad_sch Sheet: /LS1/

Vdd 4; Vss 6; MCP6004; GNDA; OUT1; OUT2; OUT3; OUT4

D | D
C | C
B | B
A | A

C270
100n

V5A

IO0
IO1

COM

MUX

B1 1

GND | 2
B0 3 | A | 4

VCC 5

S 6

U270

NC7SB3157P6X

GNDA | GNDA

Vdd 4; Vss 6; MCP6004; GNDA; OUT1; OUT2; OUT3; OUT4

D | D
C | C
B | B
A | A

C275
100n

V5A

IO0
IO1

COM

MUX

B1 1

GND | 2
B0 3 | A | 4

VCC 5

S 6

U275

NC7SB3157P6X

GNDA | GNDA

Vdd 4; Vss 6; MCP6004; GNDA; OUT1; OUT2; OUT3; OUT4

D | D
C | C
B | B
A | A

C280
100n

V5A

IO0
IO1

COM

MUX

B1 1

GND | 2
B0 3 | A | 4

VCC 5

S 6

U280

NC7SB3157P6X

GNDA | GNDA

Vdd 4; Vss 6; MCP6004; GNDA; OUT1; OUT2; OUT3; OUT4

D | D
C | C
B | B
A | A

C285
100n

V5A

IO0
IO1

COM

MUX

B1 1

GND | 2
B0 3 | A | 4

VCC 5

S 6

U285

NC7SB3157P6X

GNDA | GNDA

PIC28501

# PIC28502 COC125

PIU28501

PIU28502

PIU28503 | PIU28504

PIU28505

PIU28506

## COU104

PIC28501

PIU28502

POIO1 PIU28501

POIO0 PIU28503 | PIU28504 POCOM

PIU28506 POMUX

# PIC28502 PIU28505

POIO00Mux4 | POCOM0Mux4
POIO10Mux4 | POMUX0Mux4

Vdd 4; Vss 6; MCP6004; GNDA; OUT1; OUT2; OUT3; OUT4; C190 PIC19001 100n; PIC19002 COC3; PIR19001; PIR19002; PIR19003; PIR19004; PIR19005; PIR19006; PIR19007; PIR19008; COR5; PIR19101; PIR19102; PIR19103; PIR19105; PIR19104; PIR19106; PIR19107; PIR19108; COR6; PIU19001; PIU19002; PIU19003; PIU19004; PIU19005; PIU19006; PIU19007; PIU19008; PIU19009; PIU190010; PIU190011; PIU190012; PIU190013; PIU190014; COU2; PIC19001; POOUT2; POOUT1; POOUT3; POOUT4; POIN1; POIN3 PIU19005; PIU190010 POIN4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

SPI_; VCC; 5 SPI_SCK; 7 SPI_O; lex MicroSD; _MIS


R143 populated: analog input O2S
R145 populated: WAKEUP by CAN

D5 *D5 is digital-only on F429! (EINT11)

*VIGN input is unprotected!




0 PESD; VCC; 5 RXD; 6 CANH

VRE; _CRA; _CLT; IAT; _IAT; _PPS; VIG; nRes; VBAT; SWCL; SPI2; _MIS; SPI3; I2C_SCL; SPI1; GRE; u mcu.Sch; _IGN; 8.Sch; _can can.Sch; d.Sch; nRS; x.Sch; USB_; P USB_; USBI; A I2C_SCL UART8_RX UART8_TX UART2_RX UART2_TX; N VBAT; VCC; ACC_SC; ACC_; ACC_MIS; ACC_MO; BARO; sen; ors.Sc; LVC1; PWR_; VBU; wer.Sch; USBM; USBP; 6 SWDIO; N7 SWCLK; N8 nReset; 4 I2C_SDA; VREF2 S5; IN_SENS3 S7; IN_SENS2 S8; IN_SENS1 S9; IN_AUX3 S11; IN_AUX2 S12; IN_AUX1 S13; IN_MAP2 S20; IN_MAP1 S21; IAT S26; _CLT S28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

USBM USBP USBID VBUS

### COR2

Vdd 4; Vss 6; MCP6004; GNDA; IN1 (CRNK); OUT1; OUT2; OUT3; OUT4; C195 PIC19501 100n; PIC19502 COC2; PIR19502; PIR19501; PIR19601; PIR19602; PIR19603; PIR19604; PIR19605; PIR19606; PIR19607; PIR19608; COR3; PIR19701; PIR19702; PIR19703; PIR19705; PIR19704; PIR19706; PIR19707; PIR19708; COR4; PIU19501; PIU19502; PIU19503; PIU19504; PIU19505; PIU19506; PIU19507; PIU19508; PIU19509; PIU195010; PIU195011; PIU195012; PIU195013; PIU195014; COU1; PIC19501; POOUT1; POOUT2; POOUT3; POOUT4; POIN1 (CRNK)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

More accurate threshold for "raw" connection of VR sensors


RES 5; GND(1) 6; GND(2); 7 GND(3); 8 VDD; 9 VDD_IO; INT_2 11; INT_1 12; U106 LIS2DH12TR; VDD 10; INT DRDY; RES 3; Vdd IO 1; GND; LPS22HBTR; ACC_SCK ACC_CS ACC_MISO ACC_MOSI; BARO_SCL BARO_SDA

SCL/SPC 1
SDO/SA0 3
SDA/SDI/SDO 4

SCL/SPC 2
SDO/SA0 5

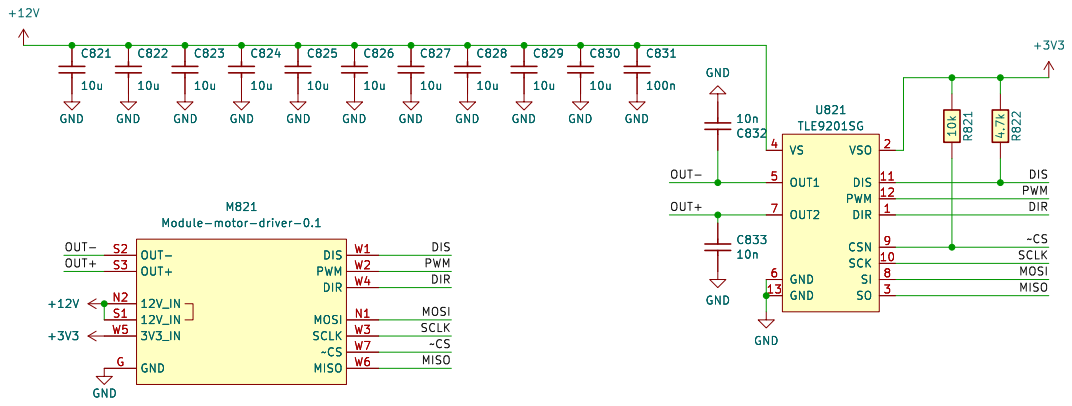
[picture p37: page 23]

+3.3V C616

27k +


100n GND GND R⁶⁰⁸ ⁴⁷

1 PA4 10 PA5 11 PA6 12 PA7 13 PB0 14 PB1 15 VSS 16 VDDIO2 17 PA8 18 PA9 19 PF0 2 PA10 20 PA11 21 PA12 22 PA13 23 PA14 24 PA15 25 PB3 26 PB4 27 PB5 28 PB6 29 PF1 3 PB7 30 PB8 31 VSSA 32 NRST 4 VDDA

1u GND GND GND
+3.3V R⁶¹¹ ²⁰k R⁶¹⁰ ²⁰k GND

to ground to improve the routing
(floating pins by the software).

Heater negative Power GND

VDDA GND
Nernst Sense Voltage Buffer Nernst Internal Resistance Measurement

+3.3V C606 DNP GND
File: hellen1-wbo.kicad_sch Sheet: / rusefi.com V⁻ 11 V⁺

andreika; Size:; Author:; Date:; Revision:; Sheet; PESD1CAN; GND; CANH; CANL; TXD 1 GND 2 VCC 3; Vio; 5 RXD 4; 6 CANH; TJA1051T/3/1J; CANH CANL; CAN_TX; CAN_RX; CAN_VIO; CAN_VIO V2; S2 CANL; CAN_TX V5; CAN_RX V6; Module:can/0.1

Hellen-One CAN
Title:

rusEFI EMS
Hellen-One Platform
https://rusefi.com/s/hellen72

# 6 U751 GND

1u R761


Id: 1/1 Title: File: hellen1-vr-discrete.kicad_sch Sheet: /



Hellen One : Power-Module interface

Reverse polarity and overvoltage protection
F410 V12_RAW
