angelEmbeddedEra/rusefi-sti-2004/boards/rusefiSTI2004-a/frame/2004-schematic.pdf

Analog/digital Heater negative Power GND

IN_PPS_SUB
IN_TPS_SUB
GND GND GND GND GND GND GND

GND GND GND GND GND

Id: 1/3 Title: File: rusefiSTI2004.kicad_sch Sheet: /


Id: 2/3 Title: File: INJ4.kicad_sch Sheet: /INJ/ GND GND


Id: 3/3 Title: File: INJ4.kicad_sch Sheet: /LS1/
