angelEmbeddedEra/rusefi-sti-2004/(list of files, drawings)

Other design files:
pcb_place.json
