angelEmbeddedEra/rusefi-sti-2004/rusefiSTI2004.kicad_pcb

## KiCad design rusefiSTI2004.kicad_pcb (2026-10-29)

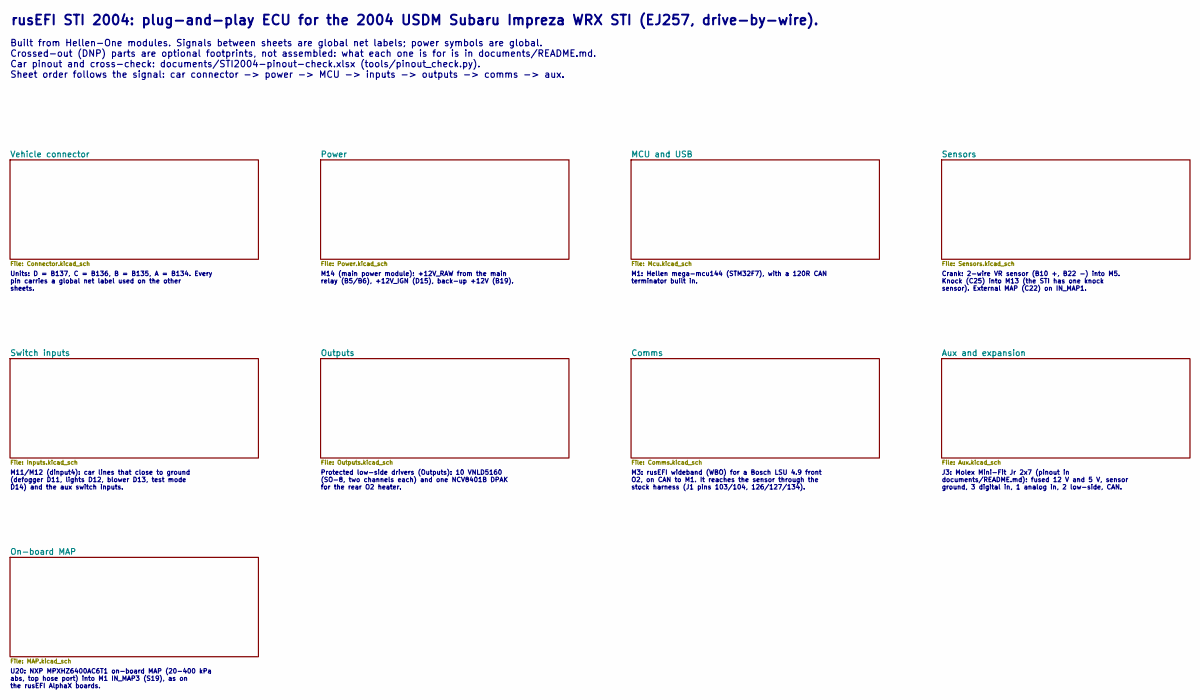
[picture p43: schematic rusefiSTI2004.kicad_sch, ${Project_Name}]

Notes on the sheet:
Units: D = B137, C = B136, B = B135, A = B134. Every pin carries a global net label used on the other sheets.
Built from Hellen-One modules. Signals between sheets are global net labels; power symbols are global. Crossed-out (DNP) parts are optional footprints, not assembled: what each one is for is in documents/README.md. Car pinout and cross-check: documents/STI2004-pinout-check.xlsx (tools/pinout_check.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
M14 (main power module): +12V_RAW from the main relay (B5/B6), +12V_IGN (D15), back-up +12V (B19).
J3: Molex Mini-Fit Jr 2x7 (pinout in documents/README.md): fused 12 V and 5 V, sensor ground, 3 digital in, 1 analog in, 2 low-side, CAN.
M11/M12 (dinput4): car lines that close to ground (defogger D11, lights D12, blower D13, test mode D14) and the aux switch inputs.
M3: rusEFI wideband (WBO) for a Bosch LSU 4.9 front O2, on CAN to M1. It reaches the sensor through the stock harness (J1 pins 103/104, 126/127/134).
Crank: 2-wire VR sensor (B10 +, B22 -) into M5. Knock (C25) into M13 (the STI has one knock sensor). External MAP (C22) on IN_MAP1.
M1: Hellen mega-mcu144 (STM32F7), with a 120R CAN terminator built in.
rusEFI STI 2004: plug-and-play ECU for the 2004 USDM Subaru Impreza WRX STI (EJ257, drive-by-wire).
Protected low-side drivers (Outputs): 10 VNLD5160 (SO-8, two channels each) and one NCV8401B DPAK for the rear O2 heater.
U20: NXP MPXHZ6400AC6T1 on-board MAP (20-400 kPa abs, top hose port) into M1 IN_MAP3 (S19), as on the rusEFI AlphaX boards.

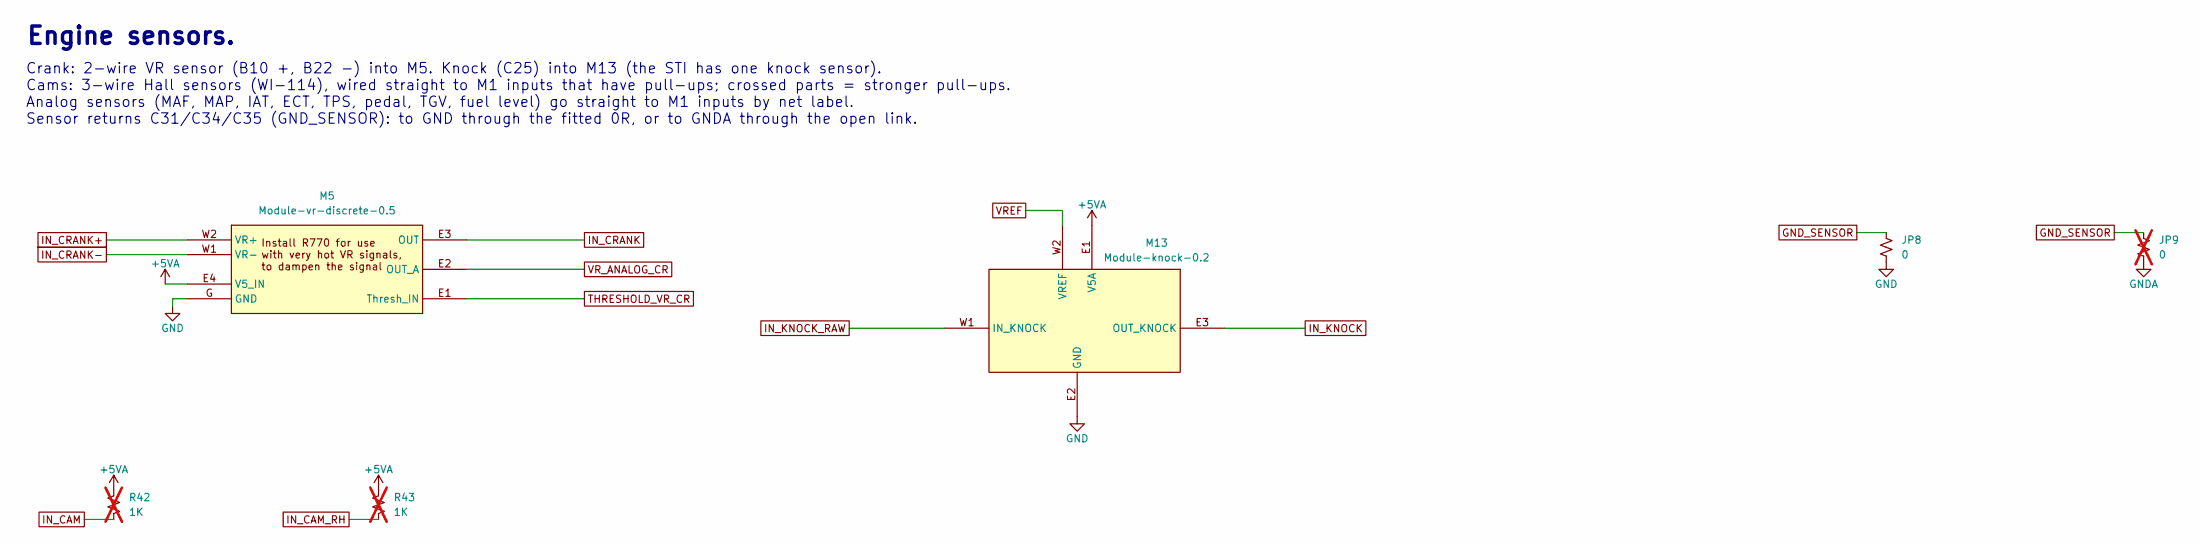
[picture p44: schematic Sensors.kicad_sch, ${Project_Name}]

Parts:
JP8: 0; R_0805_2012Metric; Manufacturer Part Number RC0805JR-070RL; LCSC C17477
JP9: 0; R_0805_2012Metric; Manufacturer Part Number RC0805JR-070RL; LCSC C17477; not fitted
M5: Module-vr-discrete-0.5; vr-discrete
M13: Module-knock-0.2; knock
R42, R43: 1K; R_0603_1608Metric; Manufacturer Part Number RC0603FR-071KL; LCSC C22548; not fitted

Connections:
+5VA: M5.E4 (V5_IN), M13.E1 (V5A), R42.2, R43.2; also elsewhere on the board
GNDA: JP9.2; also elsewhere on the board
GND_SENSOR: JP8.1, JP9.1; also elsewhere on the board
IN_CAM: R42.1; also elsewhere on the board
IN_CAM_RH: R43.1; also elsewhere on the board
IN_CRANK: M5.E3 (OUT); also elsewhere on the board
IN_CRANK+: M5.W2 (VR+); also elsewhere on the board
IN_CRANK-: M5.W1 (VR-); also elsewhere on the board
IN_KNOCK: M13.E3 (OUT_KNOCK); also elsewhere on the board
IN_KNOCK_RAW: M13.W1 (IN_KNOCK); also elsewhere on the board
THRESHOLD_VR_CR: M5.E1 (Thresh_IN); also elsewhere on the board
VREF: M13.W2 (VREF); also elsewhere on the board
VR_ANALOG_CR: M5.E2 (OUT_A); also elsewhere on the board

Notes on the sheet:
Engine sensors.
Crank: 2-wire VR sensor (B10 +, B22 -) into M5. Knock (C25) into M13 (the STI has one knock sensor). Cams: 3-wire Hall sensors (WI-114), wired straight to M1 inputs that have pull-ups; crossed parts = stronger pull-ups. Analog sensors (MAF, MAP, IAT, ECT, TPS, pedal, TGV, fuel level) go straight to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

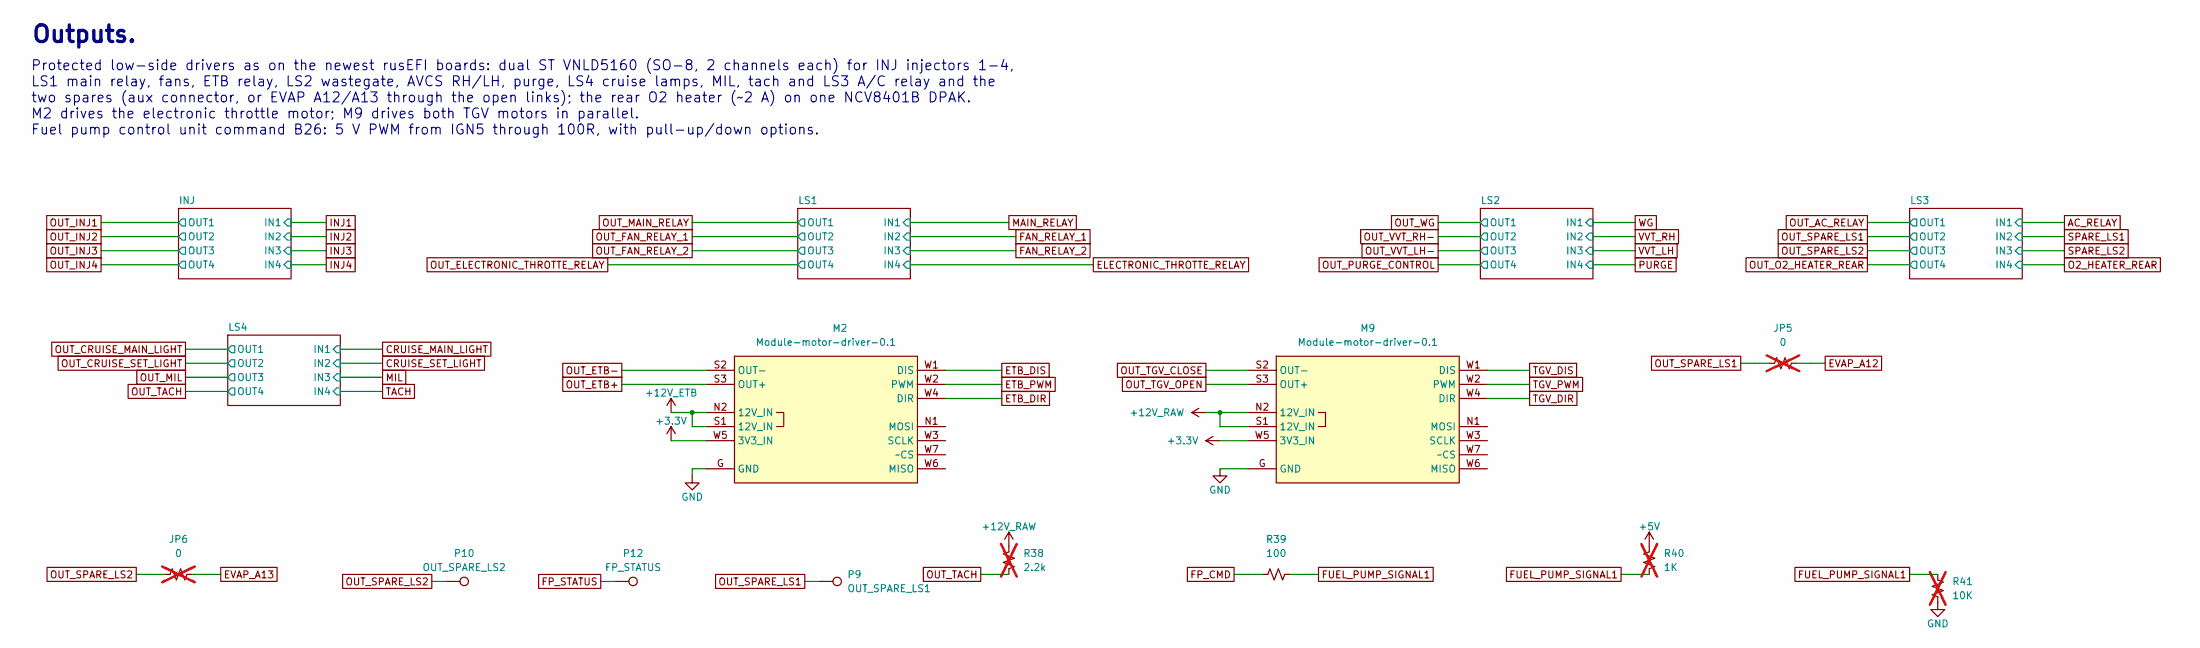
[picture p45: schematic Outputs.kicad_sch, ${Project_Name}]

Parts:
JP5, JP6: 0; R_0805_2012Metric; Manufacturer Part Number RC0805JR-070RL; LCSC C17477; not fitted
M2, M9: Module-motor-driver-0.1; motor-driver
P9: OUT_SPARE_LS1; TestPoint_THTPad_D2.0mm_Drill1.0mm
P10: OUT_SPARE_LS2; TestPoint_THTPad_D2.0mm_Drill1.0mm
P12: FP_STATUS; TestPoint_THTPad_D2.0mm_Drill1.0mm
R38: 2.2k; R_0805_2012Metric; Manufacturer Part Number RC0805JR-072K2L; LCSC C17520; not fitted
R39: 100; R_0603_1608Metric; Manufacturer Part Number RC0603FR-07100RL; LCSC C105588
R40: 1K; R_0603_1608Metric; Manufacturer Part Number RC0603FR-071KL; LCSC C22548; not fitted
R41: 10K; R_0603_1608Metric; Manufacturer Part Number RC0603FR-0710KL; LCSC C98220; not fitted

Connections:
+3.3V: M2.W5 (3V3_IN), M9.W5 (3V3_IN); also elsewhere on the board
+5V: R40.2; also elsewhere on the board
+12V_ETB: M2.N2 (12V_IN), M2.S1 (12V_IN); also elsewhere on the board
+12V_RAW: M9.N2 (12V_IN), M9.S1 (12V_IN), R38.2; also elsewhere on the board
ETB_DIR: M2.W4 (DIR); also elsewhere on the board
ETB_DIS: M2.W1 (DIS); also elsewhere on the board
ETB_PWM: M2.W2 (PWM); also elsewhere on the board
EVAP_A12: JP5.2; also elsewhere on the board
EVAP_A13: JP6.2; also elsewhere on the board
FP_CMD: R39.1; also elsewhere on the board
FP_STATUS: P12.1; also elsewhere on the board
FUEL_PUMP_SIGNAL1: R39.2, R40.1, R41.1; also elsewhere on the board
OUT_ETB+: M2.S3 (OUT+); also elsewhere on the board
OUT_ETB-: M2.S2 (OUT-); also elsewhere on the board
OUT_SPARE_LS1: JP5.1, P9.1; also elsewhere on the board
OUT_SPARE_LS2: JP6.1, P10.1; also elsewhere on the board
OUT_TACH: R38.1; also elsewhere on the board
OUT_TGV_CLOSE: M9.S2 (OUT-); also elsewhere on the board
OUT_TGV_OPEN: M9.S3 (OUT+); also elsewhere on the board
TGV_DIR: M9.W4 (DIR); also elsewhere on the board
TGV_DIS: M9.W1 (DIS); also elsewhere on the board
TGV_PWM: M9.W2 (PWM); also elsewhere on the board

Notes on the sheet:
Outputs.
Protected low-side drivers as on the newest rusEFI boards: dual ST VNLD5160 (SO-8, 2 channels each) for INJ injectors 1-4, LS1 main relay, fans, ETB relay, LS2 wastegate, AVCS RH/LH, purge, LS4 cruise lamps, MIL, tach and LS3 A/C relay and the two spares (aux connector, or EVAP A12/A13 through the 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

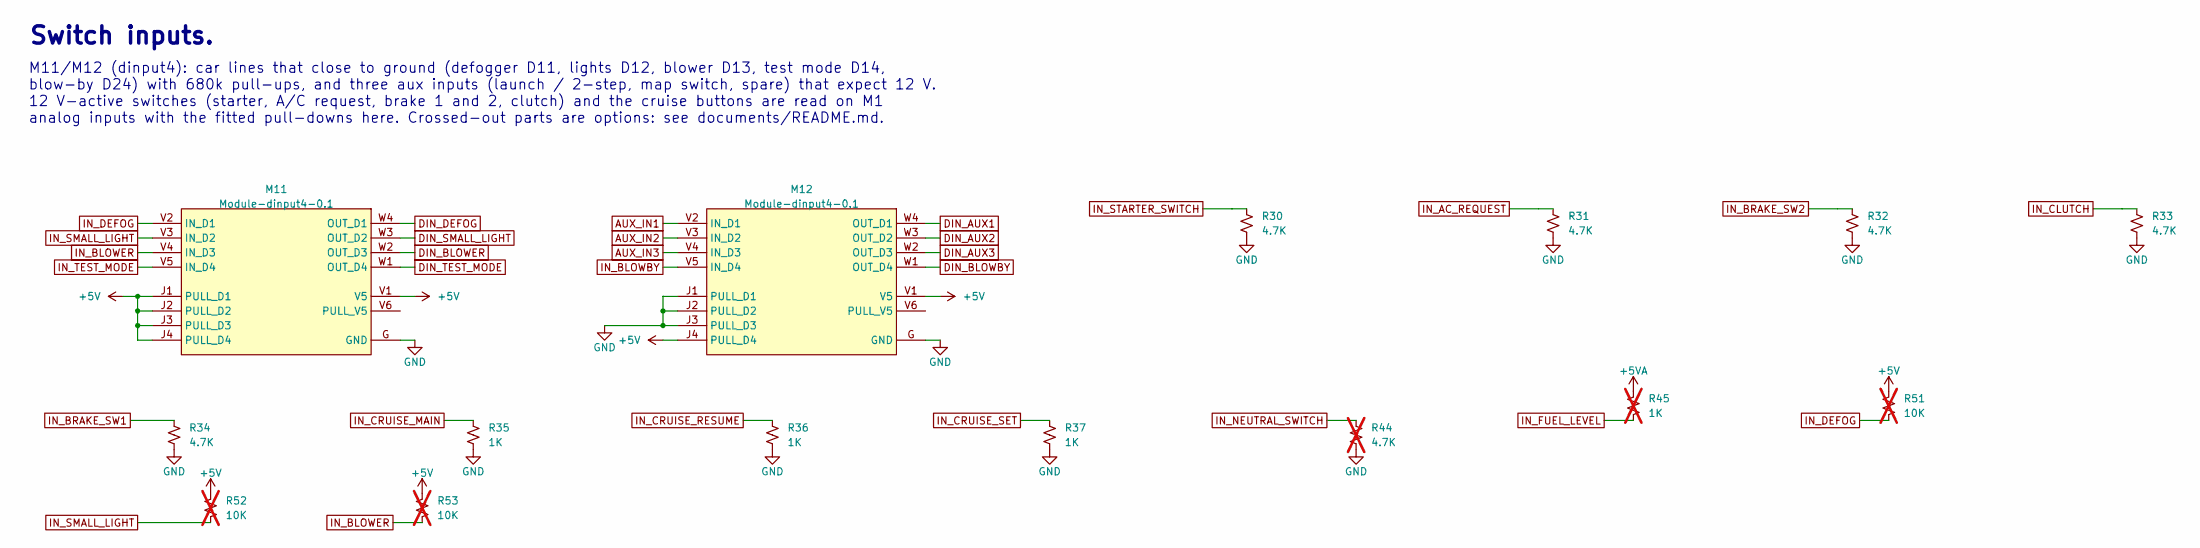
[picture p46: schematic Inputs.kicad_sch, ${Project_Name}]

Parts:
M11, M12: Module-dinput4-0.1; dinput4
R30, R31, R32, R33, R34: 4.7K; R_0603_1608Metric; Manufacturer Part Number RC0603FR-074K7L; LCSC C99782
R35, R36, R37: 1K; R_1206_3216Metric; Manufacturer Part Number ERJ-U08F1001V
R44: 4.7K; R_0603_1608Metric; Manufacturer Part Number RC0603FR-074K7L; LCSC C99782; not fitted
R45: 1K; R_0603_1608Metric; Manufacturer Part Number RC0603FR-071KL; LCSC C22548; not fitted
R51, R52, R53: 10K; R_0603_1608Metric; Manufacturer Part Number RC0603FR-0710KL; LCSC C98220; not fitted

Connections:
+5V: M11.J1 (PULL_D1), M11.J2 (PULL_D2), M11.J3 (PULL_D3), M11.J4 (PULL_D4), M11.V1 (V5), M12.J4 (PULL_D4), M12.V1 (V5), R51.2, R52.2, R53.2; also elsewhere on the board
+5VA: R45.2; also elsewhere on the board
AUX_IN1: M12.V2 (IN_D1); also elsewhere on the board
AUX_IN2: M12.V3 (IN_D2); also elsewhere on the board
AUX_IN3: M12.V4 (IN_D3); also elsewhere on the board
DIN_AUX1: M12.W4 (OUT_D1); also elsewhere on the board
DIN_AUX2: M12.W3 (OUT_D2); also elsewhere on the board
DIN_AUX3: M12.W2 (OUT_D3); also elsewhere on the board
DIN_BLOWBY: M12.W1 (OUT_D4); also elsewhere on the board
DIN_BLOWER: M11.W2 (OUT_D3); also elsewhere on the board
DIN_DEFOG: M11.W4 (OUT_D1); also elsewhere on the board
DIN_SMALL_LIGHT: M11.W3 (OUT_D2); also elsewhere on the board
DIN_TEST_MODE: M11.W1 (OUT_D4); also elsewhere on the board
IN_AC_REQUEST: R31.1; also elsewhere on the board
IN_BLOWBY: M12.V5 (IN_D4); also elsewhere on the board
IN_BLOWER: M11.V4 (IN_D3), R53.1; also elsewhere on the board
IN_BRAKE_SW1: R34.1; also elsewhere on the board
IN_BRAKE_SW2: R32.1; also elsewhere on the board
IN_CLUTCH: R33.1; also elsewhere on the board
IN_CRUISE_MAIN: R35.1; also elsewhere on the board
IN_CRUISE_RESUME: R36.1; also elsewhere on the board
IN_CRUISE_SET: R37.1; also elsewhere on the board
IN_DEFOG: M11.V2 (IN_D1), R51.1; also elsewhere on the board
IN_FUEL_LEVEL: R45.1; also elsewhere on the board
IN_NEUTRAL_SWITCH: R44.1; also elsewhere on the board
IN_SMALL_LIGHT: M11.V3 (IN_D2), R52.1; also elsewhere on the board
IN_STARTER_SWITCH: R30.1; also elsewhere on the board
IN_TEST_MODE: M11.V5 (IN_D4); also elsewhere on the board

Notes on the sheet:
Switch inputs.
M11/M12 (dinput4): car lines that close to ground (defogger D11, lights D12, blower D13, test mode D14, blow-by D24) with 680k pull-ups, and three aux inputs (launch / 2-step, map switch, spare) that expect 12 V. 12 V-active switches (starter, A/C request, brake 1 and 2, clutch) and the cruise butt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

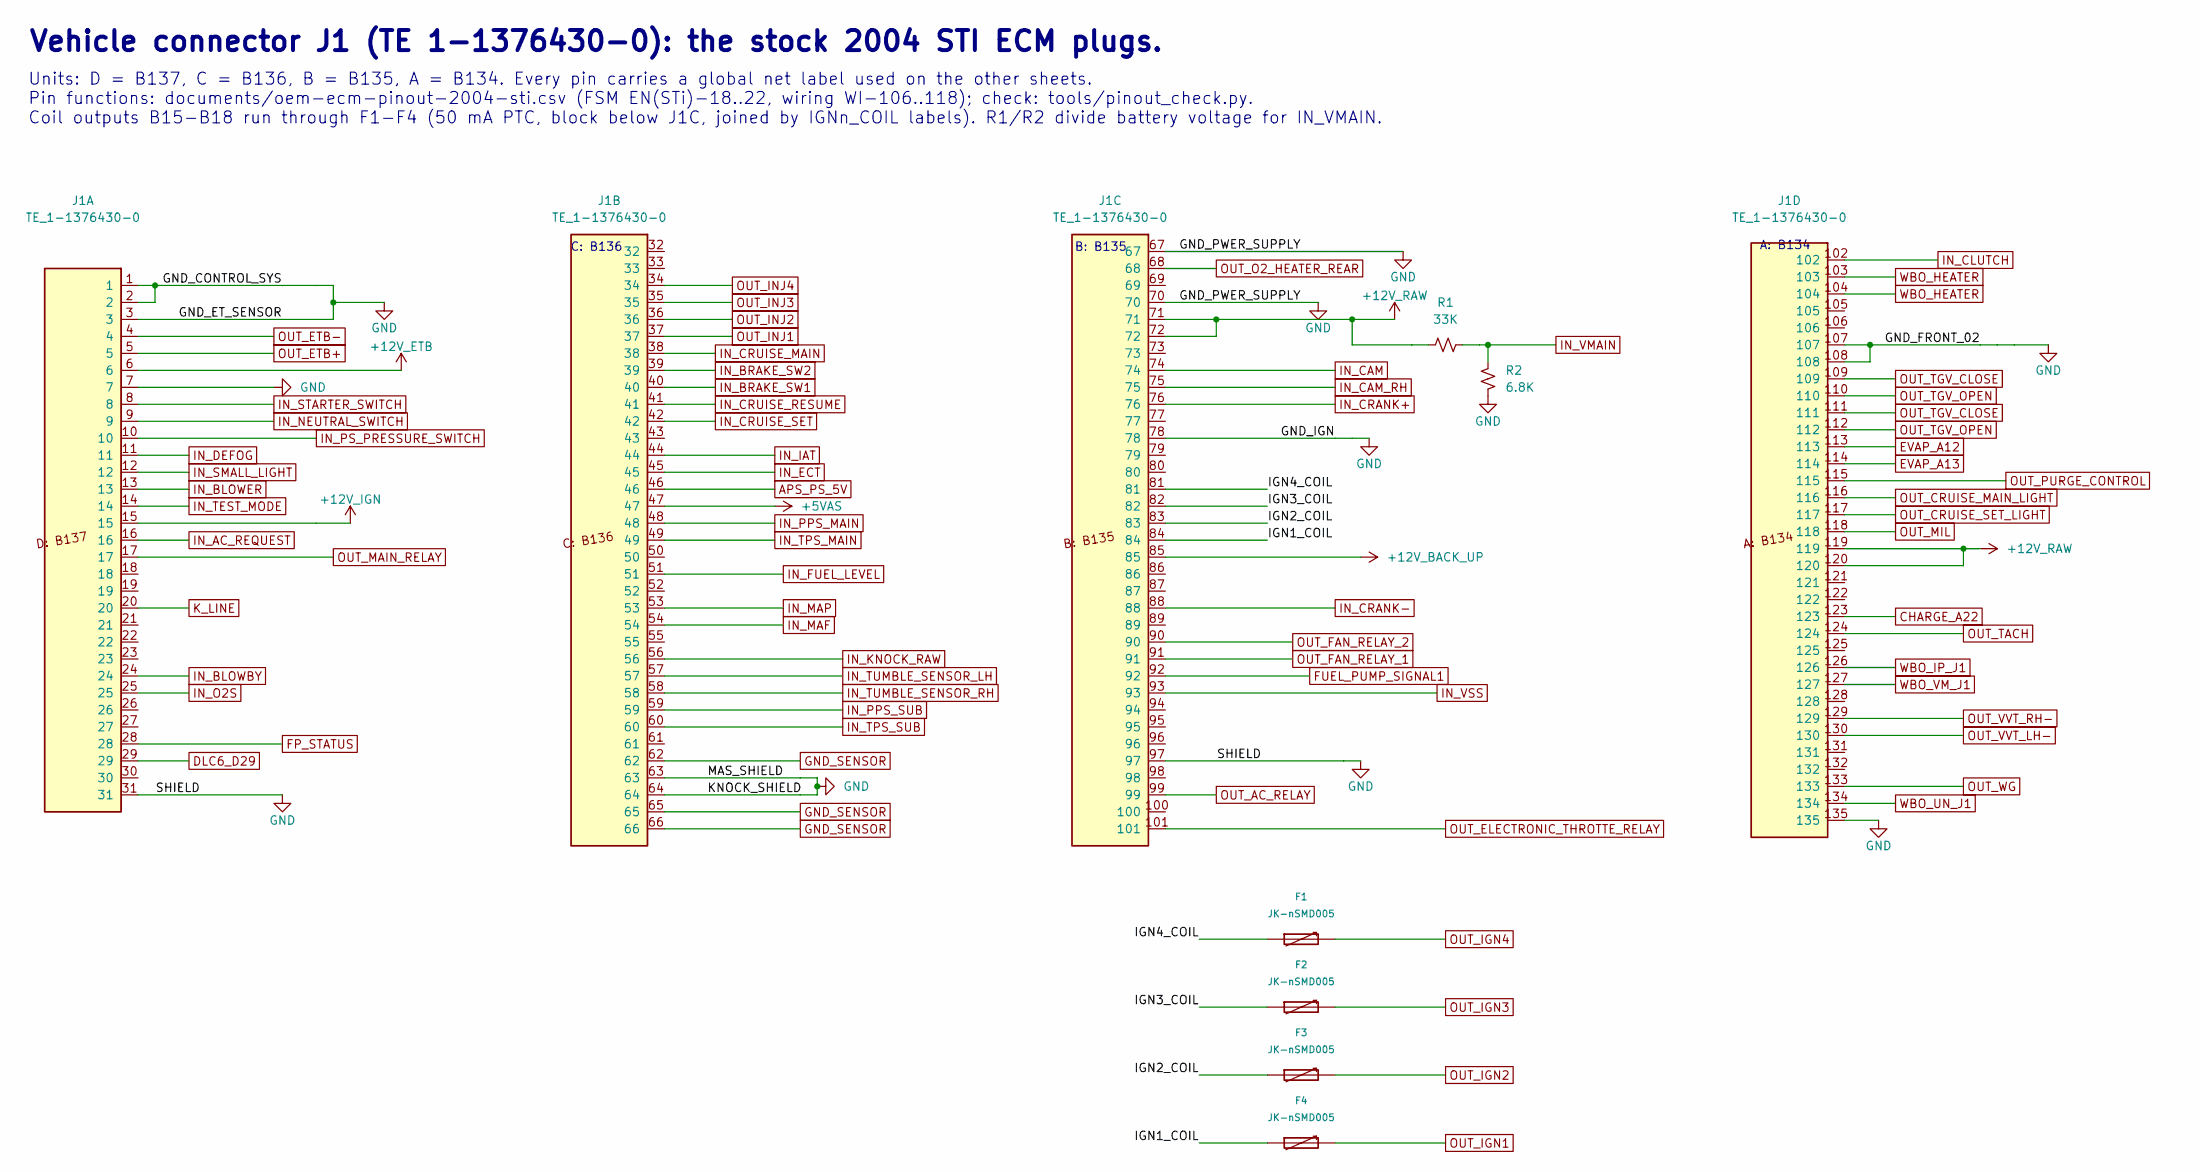
[picture p47: schematic Connector.kicad_sch, ${Project_Name}]

Parts:
F1, F2, F3, F4: JK-nSMD005; Fuse_1206_3216Metric; Manufacturer Part Number JK-nSMD005; LCSC C369153
J1: TE_1-1376430-0; Manufacturer Part Number 1-1376430-0
R1: 33K; R_0603_1608Metric; Manufacturer Part Number RC0603FR-0733KL; LCSC C126359
R2: 6.8K; R_0603_1608Metric; Manufacturer Part Number RC0603FR-076K8L; LCSC C114632

Connections:
+5VAS: J1.47; also elsewhere on the board
+12V_BACK_UP: J1.85; also elsewhere on the board
+12V_ETB: J1.6; also elsewhere on the board
+12V_IGN: J1.15; also elsewhere on the board
+12V_RAW: J1.71, J1.72, J1.119, J1.120, R1.1; also elsewhere on the board
/Vehicle connector/IGN1_COIL: F4.1, J1.84
/Vehicle connector/IGN2_COIL: F3.1, J1.83
/Vehicle connector/IGN3_COIL: F2.1, J1.82
/Vehicle connector/IGN4_COIL: F1.1, J1.81
APS_PS_5V: J1.46; also elsewhere on the board
CHARGE_A22: J1.123; also elsewhere on the board
DLC6_D29: J1.29; also elsewhere on the board
EVAP_A12: J1.113; also elsewhere on the board
EVAP_A13: J1.114; also elsewhere on the board
FP_STATUS: J1.28; also elsewhere on the board
FUEL_PUMP_SIGNAL1: J1.92; also elsewhere on the board
GND_SENSOR: J1.62, J1.65, J1.66; also elsewhere on the board
IN_AC_REQUEST: J1.16; also elsewhere on the board
IN_BLOWBY: J1.24; also elsewhere on the board
IN_BLOWER: J1.13; also elsewhere on the board
IN_BRAKE_SW1: J1.40; also elsewhere on the board
IN_BRAKE_SW2: J1.39; also elsewhere on the board
IN_CAM: J1.74; also elsewhere on the board
IN_CAM_RH: J1.75; also elsewhere on the board
IN_CLUTCH: J1.102; also elsewhere on the board
IN_CRANK+: J1.76; also elsewhere on the board
IN_CRANK-: J1.88; also elsewhere on the board
IN_CRUISE_MAIN: J1.38; also elsewhere on the board
IN_CRUISE_RESUME: J1.41; also elsewhere on the board
IN_CRUISE_SET: J1.42; also elsewhere on the board
IN_DEFOG: J1.11; also elsewhere on the board
IN_ECT: J1.45; also elsewhere on the board
IN_FUEL_LEVEL: J1.51; also elsewhere on the board
IN_IAT: J1.44; also elsewhere on the board
IN_KNOCK_RAW: J1.56; also elsewhere on the board
IN_MAF: J1.54; also elsewhere on the board
IN_MAP: J1.53; also elsewhere on the board
IN_NEUTRAL_SWITCH: J1.9; also elsewhere on the board
IN_O2S: J1.25; also elsewhere on the board
IN_PPS_MAIN: J1.48; also elsewhere on the board
IN_PPS_SUB: J1.59; also elsewhere on the board
IN_PS_PRESSURE_SWITCH: J1.10; also elsewhere on the board
IN_SMALL_LIGHT: J1.12; also elsewhere on the board
IN_STARTER_SWITCH: J1.8; also elsewhere on the board
IN_TEST_MODE: J1.14; also elsewhere on the board
IN_TPS_MAIN: J1.49; also elsewhere on the board
IN_TPS_SUB: J1.60; also elsewhere on the board
IN_TUMBLE_SENSOR_LH: J1.57; also elsewhere on the board
IN_TUMBLE_SENSOR_RH: J1.58; also elsewhere on the board
IN_VMAIN: R1.2, R2.2; also elsewhere on the board
IN_VSS: J1.93; also elsewhere on the board
K_LINE: J1.20; also elsewhere on the board
OUT_AC_RELAY: J1.99; also elsewhere on the board
OUT_CRUISE_MAIN_LIGHT: J1.116; also elsewhere on the board
OUT_CRUISE_SET_LIGHT: J1.117; also elsewhere on the board
OUT_ELECTRONIC_THROTTE_RELAY: J1.101; also elsewhere on the board
OUT_ETB+: J1.5; also elsewhere on the board
OUT_ETB-: J1.4; also elsewhere on the board
OUT_FAN_RELAY_1: J1.91; also elsewhere on the board
OUT_FAN_RELAY_2: J1.90; also elsewhere on the board
OUT_IGN1: F4.2; also elsewhere on the board
OUT_IGN2: F3.2; also elsewhere on the board
OUT_IGN3: F2.2; also elsewhere on the board
OUT_IGN4: F1.2; also elsewhere on the board
OUT_INJ1: J1.37; also elsewhere on the board
OUT_INJ2: J1.36; also elsewhere on the board
OUT_INJ3: J1.35; also elsewhere on the board
OUT_INJ4: J1.34; also elsewhere on the board
OUT_MAIN_RELAY: J1.17; also elsewhere on the board
OUT_MIL: J1.118; also elsewhere on the board
OUT_O2_HEATER_REAR: J1.68; also elsewhere on the board
OUT_PURGE_CONTROL: J1.115; also elsewhere on the board
OUT_TACH: J1.124; also elsewhere on the board
OUT_TGV_CLOSE: J1.109, J1.111; also elsewhere on the board
OUT_TGV_OPEN: J1.110, J1.112; also elsewhere on the board
OUT_VVT_LH-: J1.130; also elsewhere on the board
OUT_VVT_RH-: J1.129; also elsewhere on the board
OUT_WG: J1.133; also elsewhere on the board
WBO_HEATER: J1.103, J1.104; also elsewhere on the board
WBO_IP_J1: J1.126; also elsewhere on the board
WBO_UN_J1: J1.134; also elsewhere on the board
WBO_VM_J1: J1.127; also elsewhere on the board

Notes on the sheet:
Units: D = B137, C = B136, B = B135, A = B134. Every pin carries a global net label used on the other sheets. Pin functions: documents/oem-ecm-pinout-2004-sti.csv (FSM EN(STi)-18..22, wiring WI-106..118); check: tools/pinout_check.py. Coil outputs B15-B18 run through F1-F4 (50 mA PTC, block below J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
Vehicle connector J1 (TE 1-1376430-0): the stock 2004 STI ECM plugs.
B: B135
A: B134
C: B136

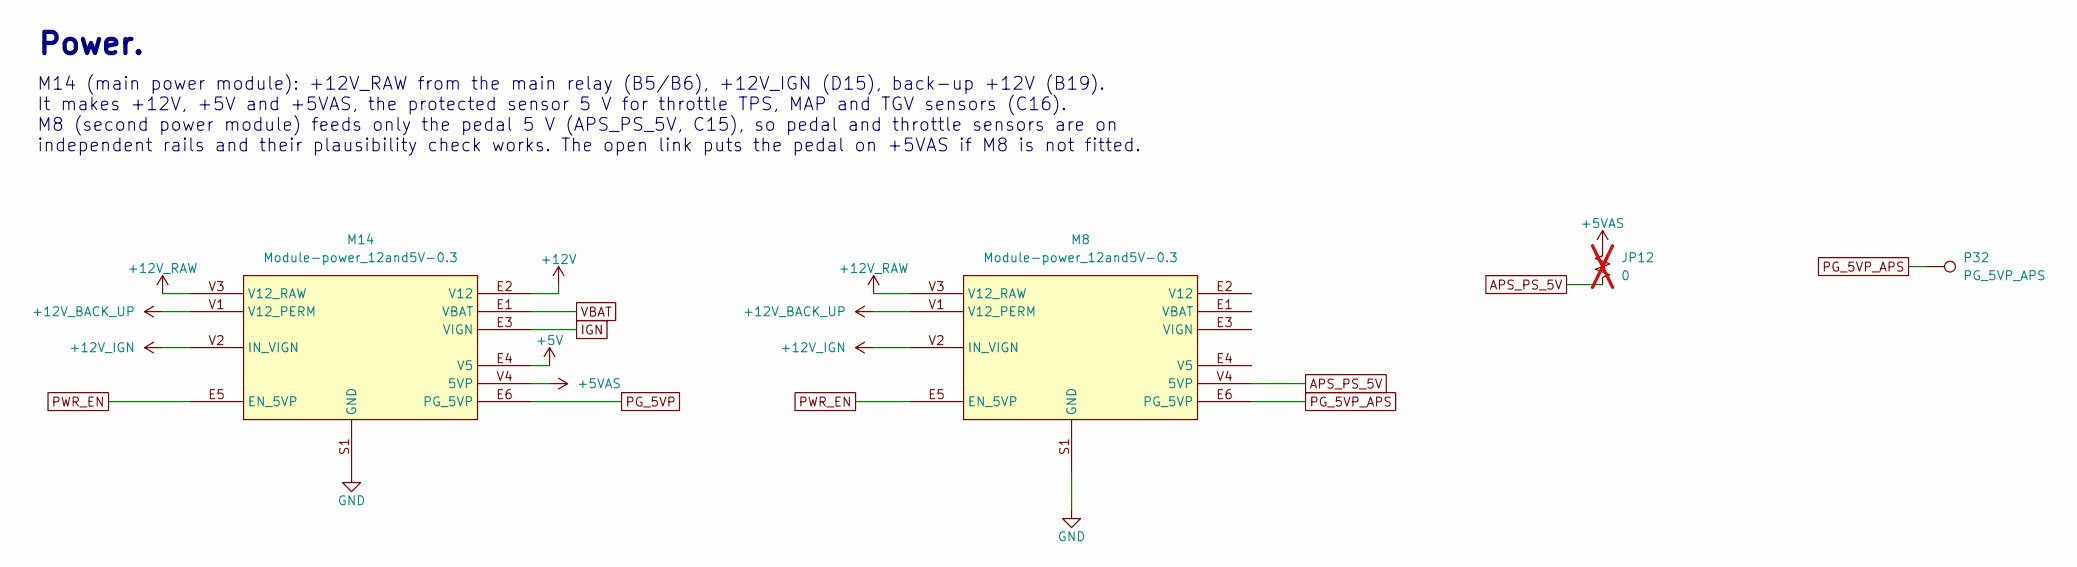
[picture p48: schematic Power.kicad_sch, ${Project_Name}]

Parts:
JP12: 0; R_0805_2012Metric; Manufacturer Part Number RC0805JR-070RL; LCSC C17477; not fitted
M8, M14: Module-power_12and5V-0.3; power_12and5V
P32: PG_5VP_APS; TestPoint_THTPad_D2.0mm_Drill1.0mm

Connections:
+5V: M14.E4 (V5); also elsewhere on the board
+5VAS: JP12.2, M14.V4 (5VP); also elsewhere on the board
+12V: M14.E2 (V12); also elsewhere on the board
+12V_BACK_UP: M8.V1 (V12_PERM), M14.V1 (V12_PERM); also elsewhere on the board
+12V_IGN: M8.V2 (IN_VIGN), M14.V2 (IN_VIGN); also elsewhere on the board
+12V_RAW: M8.V3 (V12_RAW), M14.V3 (V12_RAW); also elsewhere on the board
APS_PS_5V: JP12.1, M8.V4 (5VP); also elsewhere on the board
IGN: M14.E3 (VIGN); also elsewhere on the board
PG_5VP: M14.E6 (PG_5VP); also elsewhere on the board
PG_5VP_APS: M8.E6 (PG_5VP), P32.1
PWR_EN: M8.E5 (EN_5VP), M14.E5 (EN_5VP); also elsewhere on the board
VBAT: M14.E1 (VBAT); also elsewhere on the board

Notes on the sheet:
Power.
M14 (main power module): +12V_RAW from the main relay (B5/B6), +12V_IGN (D15), back-up +12V (B19). It makes +12V, +5V and +5VAS, the protected sensor 5 V for throttle TPS, MAP and TGV sensors (C16). M8 (second power module) feeds only the pedal 5 V (APS_PS_5V, C15), so pedal and throttle sensors ar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
