angelEmbeddedEra/rusefi-sti-2004/rusefiSTI2004.kicad_pcb

## KiCad design rusefiSTI2004.kicad_pcb (continued)

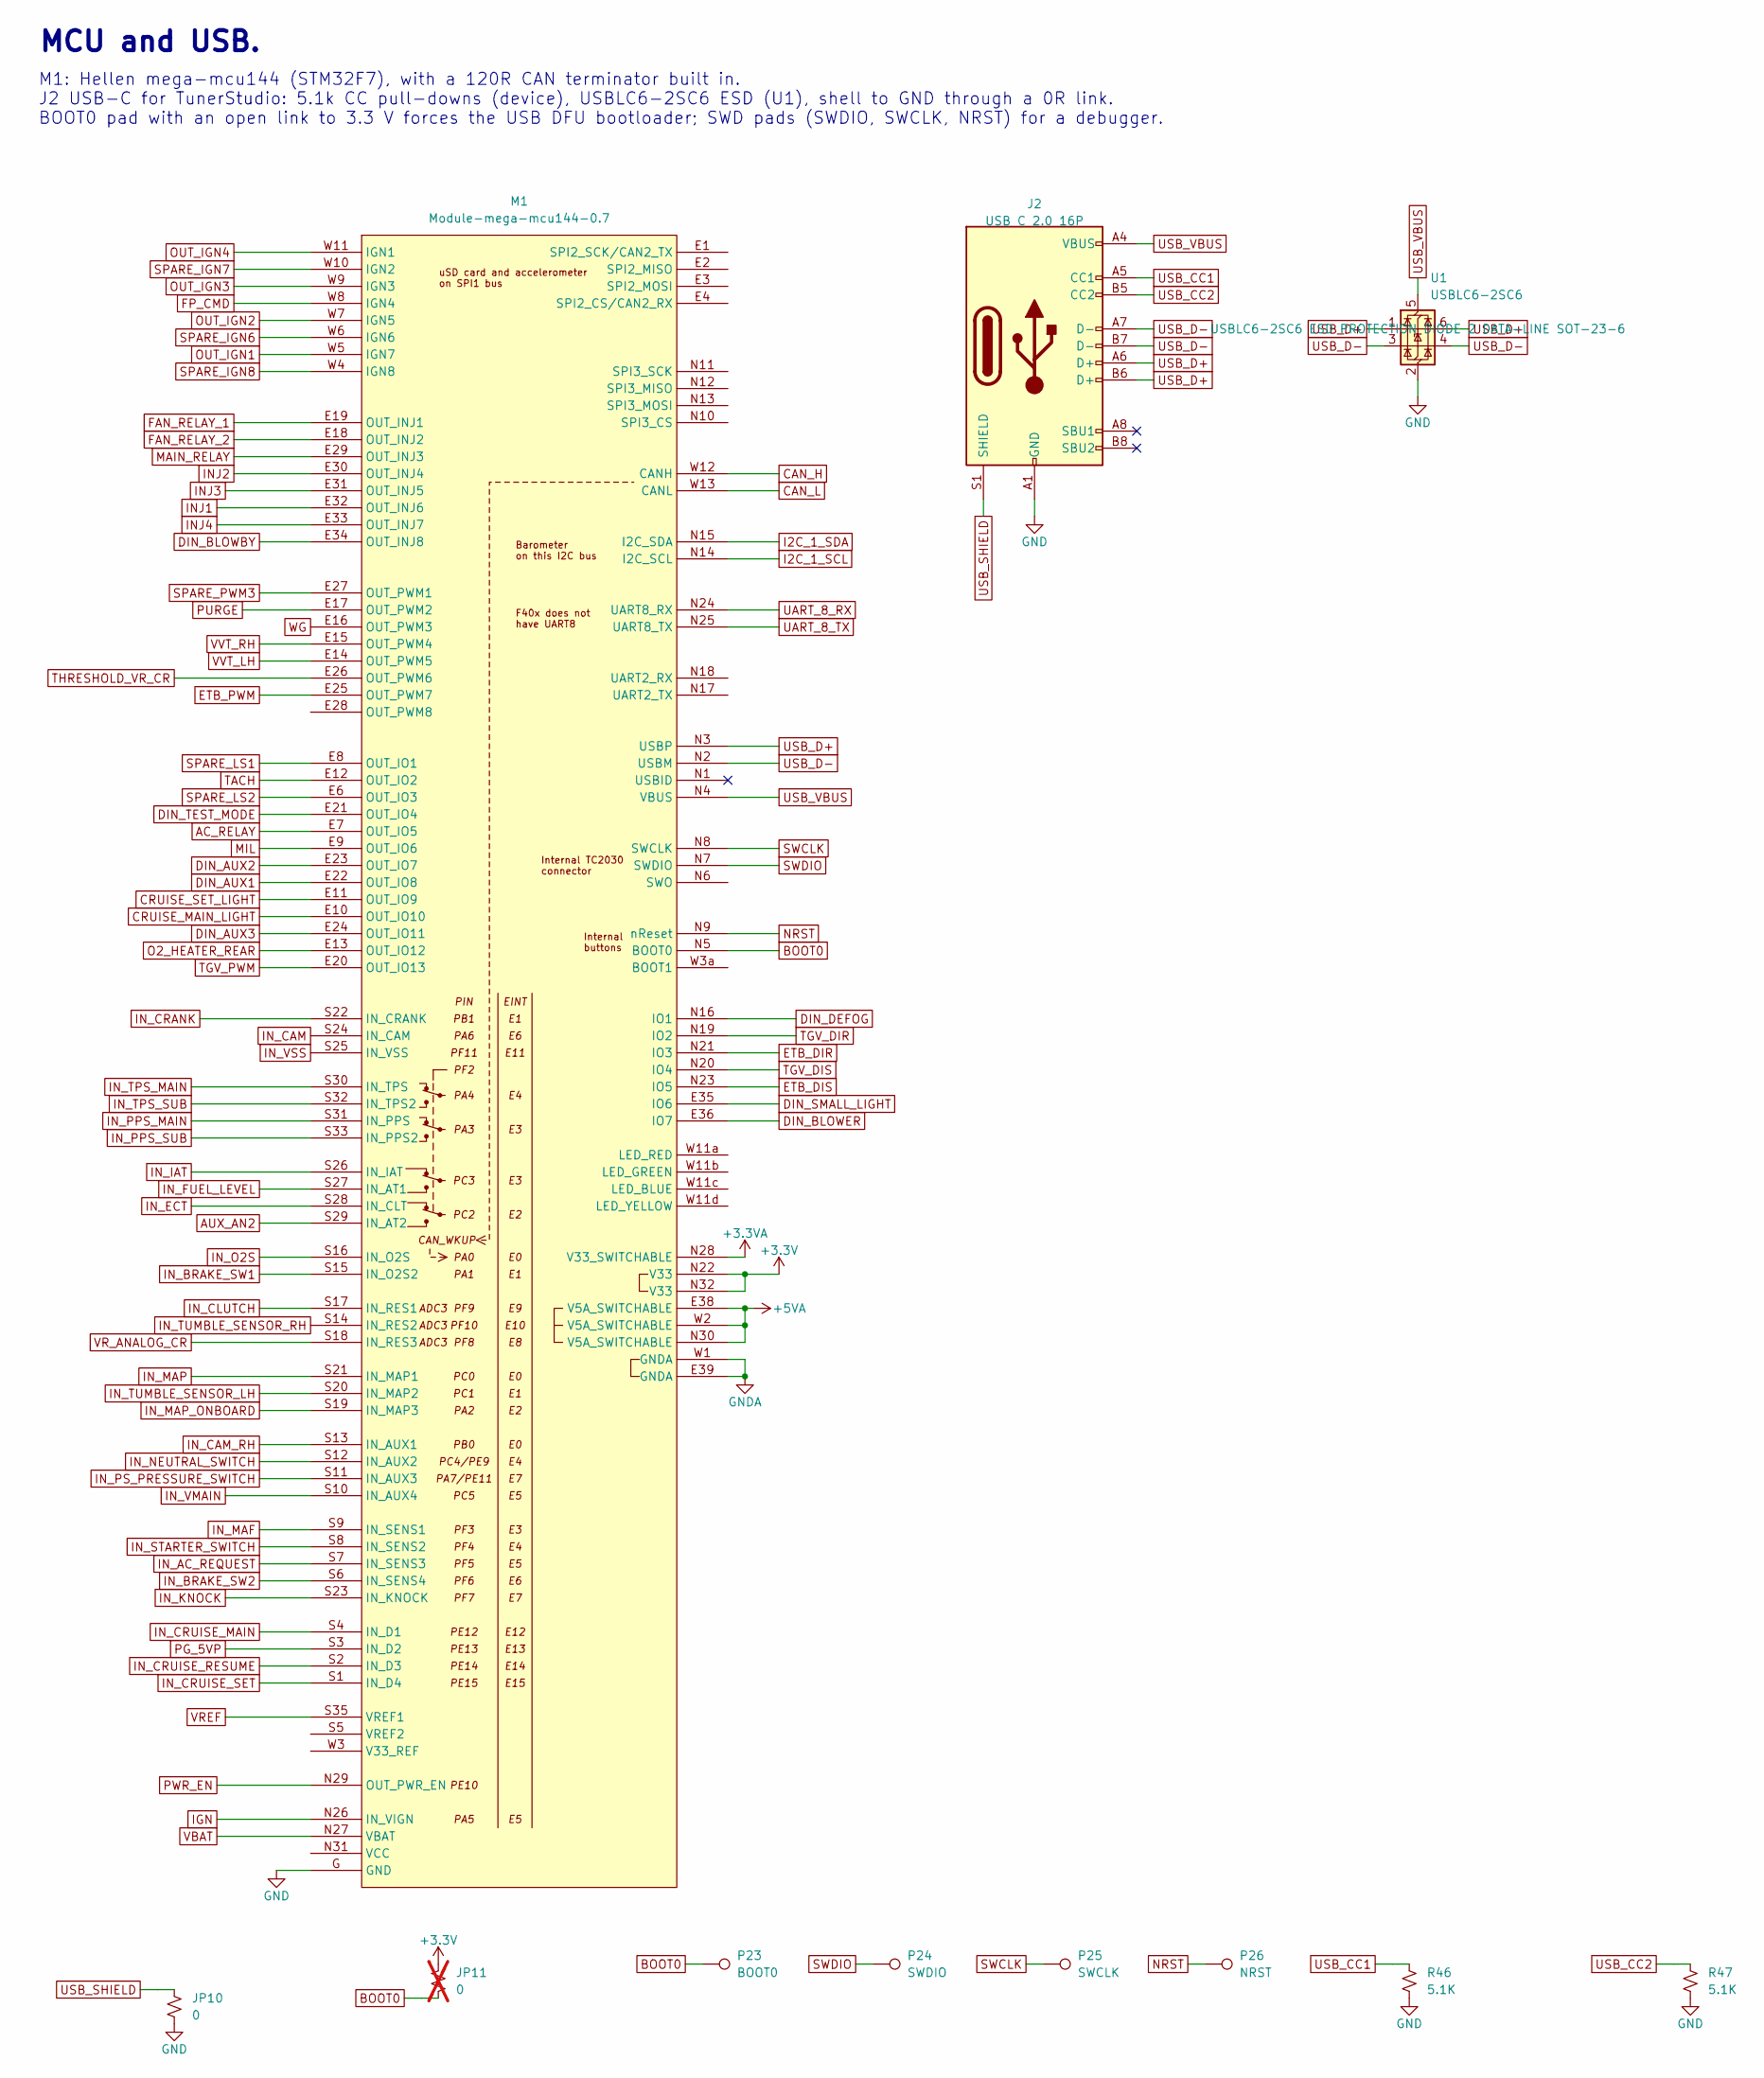
[picture p49: schematic Mcu.kicad_sch, ${Project_Name}]

Parts:
J2: USB C 2.0 16P; USB_C_Receptacle_HRO _TYPE-C-31-M-12; LCSC C165948
JP10: 0; R_0805_2012Metric; Manufacturer Part Number RC0805JR-070RL; LCSC C17477
JP11: 0; R_0805_2012Metric; Manufacturer Part Number RC0805JR-070RL; LCSC C17477; not fitted
M1: Module-mega-mcu144-0.7; mega-mcu144
P23: BOOT0; TestPoint_THTPad_D2.0mm_Drill1.0mm
P24: SWDIO; TestPoint_THTPad_D2.0mm_Drill1.0mm
P25: SWCLK; TestPoint_THTPad_D2.0mm_Drill1.0mm
P26: NRST; TestPoint_THTPad_D2.0mm_Drill1.0mm
R46, R47: 5.1K; R_0603_1608Metric; Manufacturer Part Number RC0603FR-075K1L; LCSC C105580
U1: USBLC6-2SC6; SOT-23-6; LCSC C7519

Connections:
+3.3V: JP11.2, M1.N22 (V33), M1.N32 (V33); also elsewhere on the board
+3.3VA: M1.N28 (V33_SWITCHABLE)
+5VA: M1.E38 (V5A_SWITCHABLE), M1.N30 (V5A_SWITCHABLE), M1.W2 (V5A_SWITCHABLE); also elsewhere on the board
AC_RELAY: M1.E7 (OUT_IO5); also elsewhere on the board
AUX_AN2: M1.S29 (IN_AT2); also elsewhere on the board
BOOT0: JP11.1, M1.N5 (BOOT0), P23.1
CAN_H: M1.W12 (CANH); also elsewhere on the board
CAN_L: M1.W13 (CANL); also elsewhere on the board
CRUISE_MAIN_LIGHT: M1.E10 (OUT_IO10); also elsewhere on the board
CRUISE_SET_LIGHT: M1.E11 (OUT_IO9); also elsewhere on the board
DIN_AUX1: M1.E22 (OUT_IO8); also elsewhere on the board
DIN_AUX2: M1.E23 (OUT_IO7); also elsewhere on the board
DIN_AUX3: M1.E24 (OUT_IO11); also elsewhere on the board
DIN_BLOWBY: M1.E34 (OUT_INJ8); also elsewhere on the board
DIN_BLOWER: M1.E36 (IO7); also elsewhere on the board
DIN_DEFOG: M1.N16 (IO1); also elsewhere on the board
DIN_SMALL_LIGHT: M1.E35 (IO6); also elsewhere on the board
DIN_TEST_MODE: M1.E21 (OUT_IO4); also elsewhere on the board
ETB_DIR: M1.N21 (IO3); also elsewhere on the board
ETB_DIS: M1.N23 (IO5); also elsewhere on the board
ETB_PWM: M1.E25 (OUT_PWM7); also elsewhere on the board
FAN_RELAY_1: M1.E19 (OUT_INJ1); also elsewhere on the board
FAN_RELAY_2: M1.E18 (OUT_INJ2); also elsewhere on the board
FP_CMD: M1.W8 (IGN4); also elsewhere on the board
GNDA: M1.E39 (GNDA), M1.W1 (GNDA); also elsewhere on the board
I2C_1_SCL: M1.N14 (I2C_SCL); also elsewhere on the board
I2C_1_SDA: M1.N15 (I2C_SDA); also elsewhere on the board
IGN: M1.N26 (IN_VIGN); also elsewhere on the board
IN_AC_REQUEST: M1.S7 (IN_SENS3); also elsewhere on the board
IN_BRAKE_SW1: M1.S15 (IN_O2S2); also elsewhere on the board
IN_BRAKE_SW2: M1.S6 (IN_SENS4); also elsewhere on the board
IN_CAM: M1.S24 (IN_CAM); also elsewhere on the board
IN_CAM_RH: M1.S13 (IN_AUX1); also elsewhere on the board
IN_CLUTCH: M1.S17 (IN_RES1); also elsewhere on the board
IN_CRANK: M1.S22 (IN_CRANK); also elsewhere on the board
IN_CRUISE_MAIN: M1.S4 (IN_D1); also elsewhere on the board
IN_CRUISE_RESUME: M1.S2 (IN_D3); also elsewhere on the board
IN_CRUISE_SET: M1.S1 (IN_D4); also elsewhere on the board
IN_ECT: M1.S28 (IN_CLT); also elsewhere on the board
IN_FUEL_LEVEL: M1.S27 (IN_AT1); also elsewhere on the board
IN_IAT: M1.S26 (IN_IAT); also elsewhere on the board
IN_KNOCK: M1.S23 (IN_KNOCK); also elsewhere on the board
IN_MAF: M1.S9 (IN_SENS1); also elsewhere on the board
IN_MAP: M1.S21 (IN_MAP1); also elsewhere on the board
IN_MAP_ONBOARD: M1.S19 (IN_MAP3); also elsewhere on the board
IN_NEUTRAL_SWITCH: M1.S12 (IN_AUX2); also elsewhere on the board
IN_O2S: M1.S16 (IN_O2S); also elsewhere on the board
IN_PPS_MAIN: M1.S31 (IN_PPS); also elsewhere on the board
IN_PPS_SUB: M1.S33 (IN_PPS2); also elsewhere on the board
IN_PS_PRESSURE_SWITCH: M1.S11 (IN_AUX3); also elsewhere on the board
IN_STARTER_SWITCH: M1.S8 (IN_SENS2); also elsewhere on the board
IN_TPS_MAIN: M1.S30 (IN_TPS); also elsewhere on the board
IN_TPS_SUB: M1.S32 (IN_TPS2); also elsewhere on the board
IN_TUMBLE_SENSOR_LH: M1.S20 (IN_MAP2); also elsewhere on the board
IN_TUMBLE_SENSOR_RH: M1.S14 (IN_RES2); also elsewhere on the board
IN_VMAIN: M1.S10 (IN_AUX4); also elsewhere on the board
IN_VSS: M1.S25 (IN_VSS); also elsewhere on the board
MAIN_RELAY: M1.E29 (OUT_INJ3); also elsewhere on the board
MIL: M1.E9 (OUT_IO6); also elsewhere on the board
NRST: M1.N9 (nReset), P26.1
OUT_IGN1: M1.W5 (IGN7); also elsewhere on the board
OUT_IGN2: M1.W7 (IGN5); also elsewhere on the board
OUT_IGN3: M1.W9 (IGN3); also elsewhere on the board
OUT_IGN4: M1.W11 (IGN1); also elsewhere on the board
PG_5VP: M1.S3 (IN_D2); also elsewhere on the board
PURGE: M1.E17 (OUT_PWM2); also elsewhere on the board
PWR_EN: M1.N29 (OUT_PWR_EN); also elsewhere on the board
SPARE_IGN6: M1.W6 (IGN6); also elsewhere on the board
SPARE_IGN7: M1.W10 (IGN2); also elsewhere on the board
SPARE_IGN8: M1.W4 (IGN8); also elsewhere on the board
SPARE_LS1: M1.E8 (OUT_IO1); also elsewhere on the board
SPARE_PWM3: M1.E27 (OUT_PWM1); also elsewhere on the board
SWCLK: M1.N8 (SWCLK), P25.1
SWDIO: M1.N7 (SWDIO), P24.1
TACH: M1.E12 (OUT_IO2); also elsewhere on the board
TGV_DIR: M1.N19 (IO2); also elsewhere on the board
TGV_DIS: M1.N20 (IO4); also elsewhere on the board
TGV_PWM: M1.E20 (OUT_IO13); also elsewhere on the board
THRESHOLD_VR_CR: M1.E26 (OUT_PWM6); also elsewhere on the board
UART_8_RX: M1.N24 (UART8_RX); also elsewhere on the board
UART_8_TX: M1.N25 (UART8_TX); also elsewhere on the board
USB_CC1: J2.A5 (CC1), R46.1
USB_CC2: J2.B5 (CC2), R47.1
USB_SHIELD: J2.S1 (SHIELD), JP10.1
VBAT: M1.N27 (VBAT); also elsewhere on the board
VREF: M1.S35 (VREF1); also elsewhere on the board
VR_ANALOG_CR: M1.S18 (IN_RES3); also elsewhere on the board
VVT_LH: M1.E14 (OUT_PWM5); also elsewhere on the board
VVT_RH: M1.E15 (OUT_PWM4); also elsewhere on the board
WG: M1.E16 (OUT_PWM3); also elsewhere on the board

Notes on the sheet:
M1: Hellen mega-mcu144 (STM32F7), with a 120R CAN terminator built in. J2 USB-C for TunerStudio: 5.1k CC pull-downs (device), USBLC6-2SC6 ESD (U1), shell to GND through a 0R link. BOOT0 pad with an open link to 3.3 V forces the USB DFU bootloader; SWD pads (SWDIO, SWCLK, NRST) for a debugger.
MCU and USB.

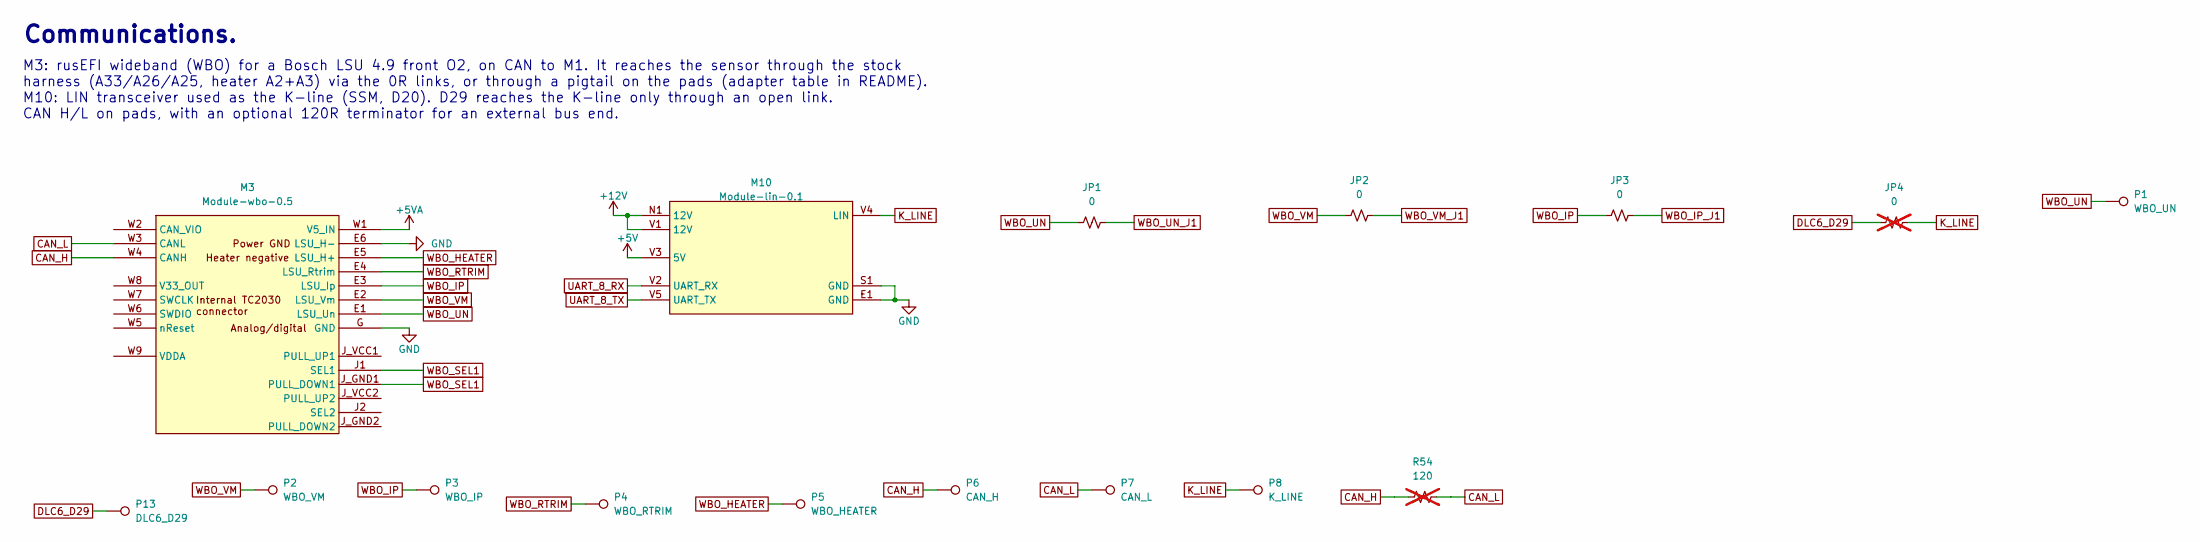
[picture p50: schematic Comms.kicad_sch, ${Project_Name}]

Parts:
JP1, JP2, JP3: 0; R_0805_2012Metric; Manufacturer Part Number RC0805JR-070RL; LCSC C17477
JP4: 0; R_0805_2012Metric; Manufacturer Part Number RC0805JR-070RL; LCSC C17477; not fitted
M3: Module-wbo-0.5; wbo
M10: Module-lin-0.1; lin
P1: WBO_UN; TestPoint_THTPad_D2.0mm_Drill1.0mm
P2: WBO_VM; TestPoint_THTPad_D2.0mm_Drill1.0mm
P3: WBO_IP; TestPoint_THTPad_D2.0mm_Drill1.0mm
P4: WBO_RTRIM; TestPoint_THTPad_D2.0mm_Drill1.0mm
P5: WBO_HEATER; TestPoint_THTPad_D2.0mm_Drill1.0mm
P6: CAN_H; TestPoint_THTPad_D2.0mm_Drill1.0mm
P7: CAN_L; TestPoint_THTPad_D2.0mm_Drill1.0mm
P8: K_LINE; TestPoint_THTPad_D2.0mm_Drill1.0mm
P13: DLC6_D29; TestPoint_THTPad_D2.0mm_Drill1.0mm
R54: 120; R_0603_1608Metric; Manufacturer Part Number RC0603FR-07120RL; LCSC C114640; not fitted

Connections:
+5V: M10.V3 (5V); also elsewhere on the board
+5VA: M3.W1 (V5_IN); also elsewhere on the board
+12V: M10.N1 (12V), M10.V1 (12V); also elsewhere on the board
CAN_H: M3.W4 (CANH), P6.1, R54.1; also elsewhere on the board
CAN_L: M3.W3 (CANL), P7.1, R54.2; also elsewhere on the board
DLC6_D29: JP4.1, P13.1; also elsewhere on the board
K_LINE: JP4.2, M10.V4 (LIN), P8.1; also elsewhere on the board
UART_8_RX: M10.V2 (UART_RX); also elsewhere on the board
UART_8_TX: M10.V5 (UART_TX); also elsewhere on the board
WBO_HEATER: M3.E5 (LSU_H+), P5.1; also elsewhere on the board
WBO_IP: JP3.1, M3.E3 (LSU_Ip), P3.1
WBO_IP_J1: JP3.2; also elsewhere on the board
WBO_RTRIM: M3.E4 (LSU_Rtrim), P4.1
WBO_SEL1: M3.J1 (SEL1), M3.J_GND1 (PULL_DOWN1)
WBO_UN: JP1.1, M3.E1 (LSU_Un), P1.1
WBO_UN_J1: JP1.2; also elsewhere on the board
WBO_VM: JP2.1, M3.E2 (LSU_Vm), P2.1
WBO_VM_J1: JP2.2; also elsewhere on the board

Notes on the sheet:
Communications.
M3: rusEFI wideband (WBO) for a Bosch LSU 4.9 front O2, on CAN to M1. It reaches the sensor through the stock harness (A33/A26/A25, heater A2+A3) via the 0R links, or through a pigtail on the pads (adapter table in README). M10: LIN transceiver used as the K-line (SSM, D20). D29 reaches the K-line 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

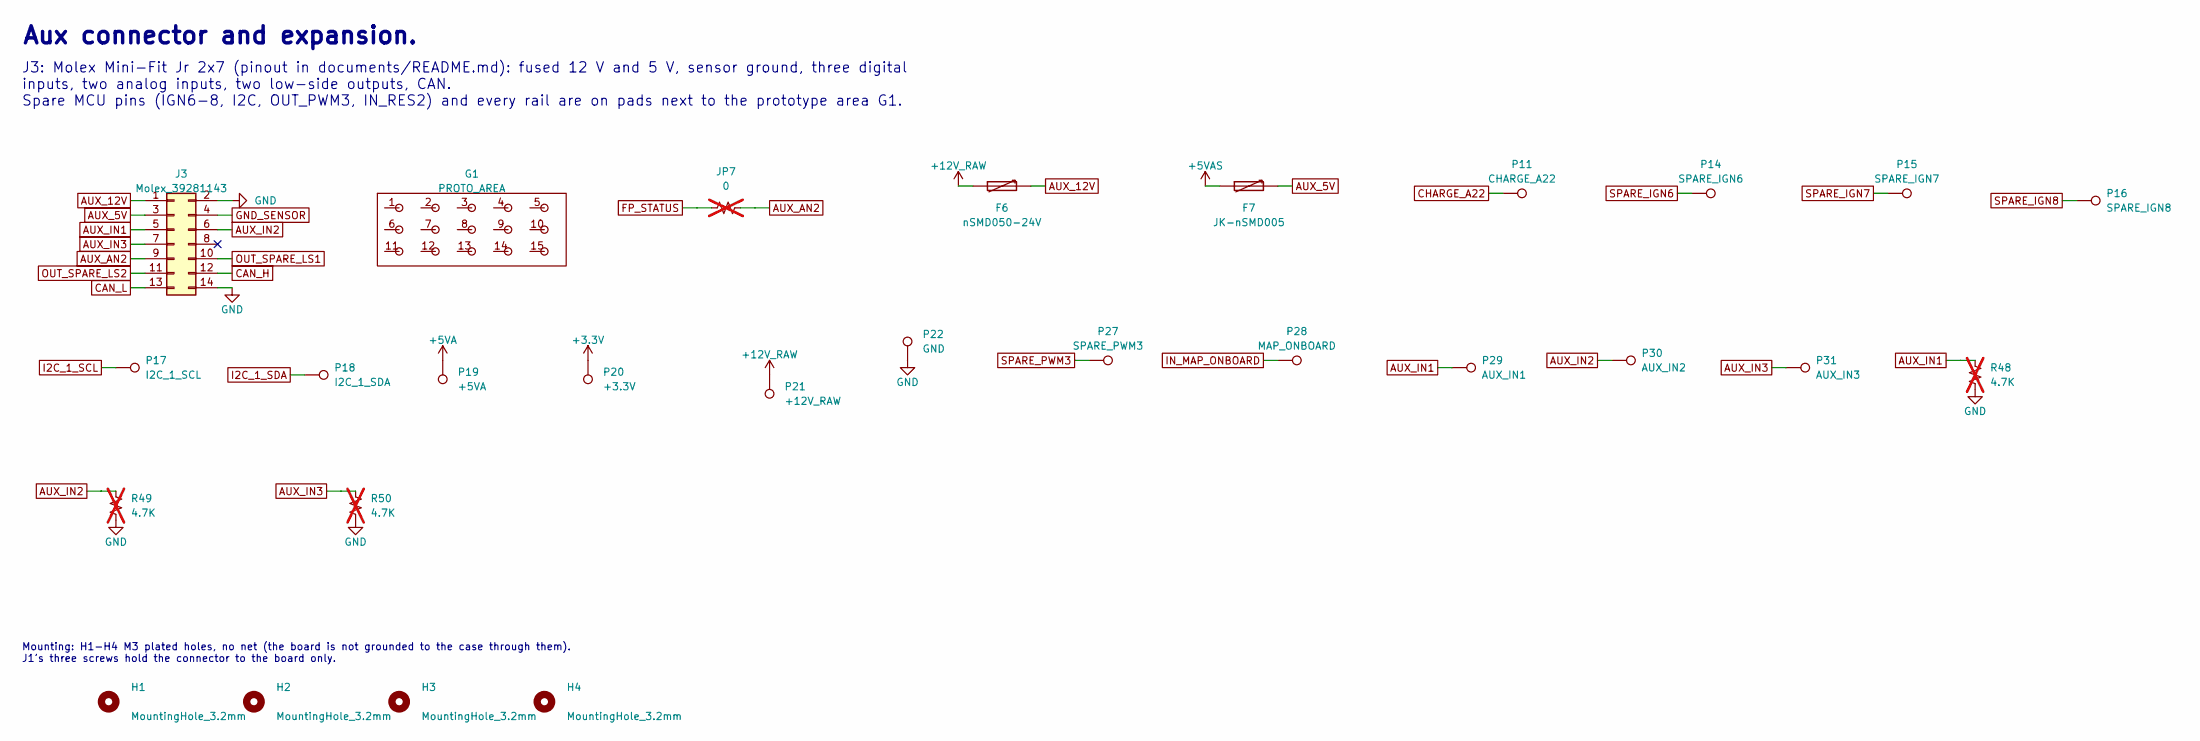
[picture p51: schematic Aux.kicad_sch, ${Project_Name}]

Parts:
F6: nSMD050-24V; Fuse_1206_3216Metric; Manufacturer Part Number nSMD050-24V; LCSC C70076
F7: JK-nSMD005; Fuse_1206_3216Metric; Manufacturer Part Number JK-nSMD005; LCSC C369153
G1: PROTO_AREA; PROTO_AREA_3x5_P2.54mm
H1, H2, H3, H4: MountingHole_3.2mm; MountingHole_3.2mm_M3_DIN965_Pad
J3: Molex_39281143; Molex_Mini-Fit_Jr_5566-14A_2x07_P4.20mm_Vertical; Manufacturer Part Number 39281143
JP7: 0; R_0805_2012Metric; Manufacturer Part Number RC0805JR-070RL; LCSC C17477; not fitted
P11: CHARGE_A22; TestPoint_THTPad_D2.0mm_Drill1.0mm
P14: SPARE_IGN6; TestPoint_THTPad_D2.0mm_Drill1.0mm
P15: SPARE_IGN7; TestPoint_THTPad_D2.0mm_Drill1.0mm
P16: SPARE_IGN8; TestPoint_THTPad_D2.0mm_Drill1.0mm
P17: I2C_1_SCL; TestPoint_THTPad_D2.0mm_Drill1.0mm
P18: I2C_1_SDA; TestPoint_THTPad_D2.0mm_Drill1.0mm
P19: +5VA; TestPoint_THTPad_D2.0mm_Drill1.0mm
P20: +3.3V; TestPoint_THTPad_D2.0mm_Drill1.0mm
P21: +12V_RAW; TestPoint_THTPad_D2.0mm_Drill1.0mm
P22: GND; TestPoint_THTPad_D2.0mm_Drill1.0mm
P27: SPARE_PWM3; TestPoint_THTPad_D2.0mm_Drill1.0mm
P28: MAP_ONBOARD; TestPoint_THTPad_D2.0mm_Drill1.0mm
P29: AUX_IN1; TestPoint_THTPad_D2.0mm_Drill1.0mm
P30: AUX_IN2; TestPoint_THTPad_D2.0mm_Drill1.0mm
P31: AUX_IN3; TestPoint_THTPad_D2.0mm_Drill1.0mm
R48, R49, R50: 4.7K; R_0603_1608Metric; Manufacturer Part Number RC0603FR-074K7L; LCSC C99782; not fitted

Connections:
+3.3V: P20.1; also elsewhere on the board
+5VA: P19.1; also elsewhere on the board
+5VAS: F7.1; also elsewhere on the board
+12V_RAW: F6.1, P21.1; also elsewhere on the board
AUX_5V: F7.2, J3.3
AUX_12V: F6.2, J3.1
AUX_AN2: J3.9, JP7.2; also elsewhere on the board
AUX_IN1: J3.5, P29.1, R48.1; also elsewhere on the board
AUX_IN2: J3.6, P30.1, R49.1; also elsewhere on the board
AUX_IN3: J3.7, P31.1, R50.1; also elsewhere on the board
CAN_H: J3.12; also elsewhere on the board
CAN_L: J3.13; also elsewhere on the board
CHARGE_A22: P11.1; also elsewhere on the board
FP_STATUS: JP7.1; also elsewhere on the board
GND_SENSOR: J3.4; also elsewhere on the board
I2C_1_SCL: P17.1; also elsewhere on the board
I2C_1_SDA: P18.1; also elsewhere on the board
IN_MAP_ONBOARD: P28.1; also elsewhere on the board
OUT_SPARE_LS1: J3.10; also elsewhere on the board
OUT_SPARE_LS2: J3.11; also elsewhere on the board
SPARE_IGN6: P14.1; also elsewhere on the board
SPARE_IGN7: P15.1; also elsewhere on the board
SPARE_IGN8: P16.1; also elsewhere on the board
SPARE_PWM3: P27.1; also elsewhere on the board

Notes on the sheet:
Aux connector and expansion.
J3: Molex Mini-Fit Jr 2x7 (pinout in documents/README.md): fused 12 V and 5 V, sensor ground, three digital inputs, two analog inputs, two low-side outputs, CAN. Spare MCU pins (IGN6-8, I2C, OUT_PWM3, IN_RES2) and every rail are on pads next to the prototype area G1.
Mounting: H1-H4 M3 plated holes, no net (the board is not grounded to the case through them). J1's three screws hold the connector to the board only.

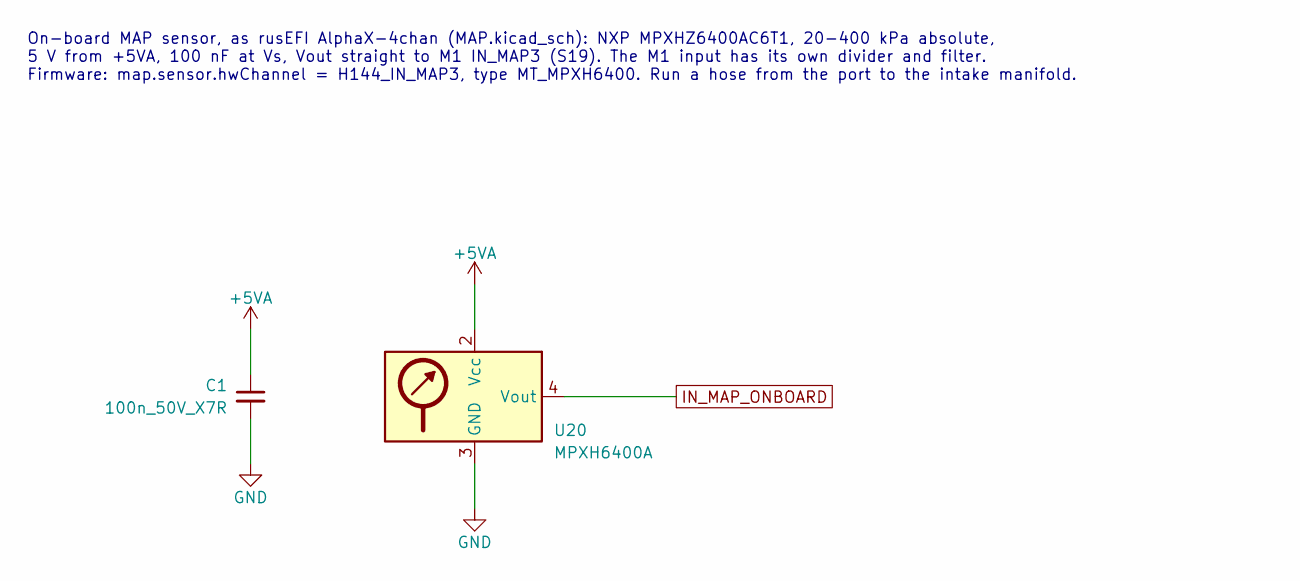
[picture p52: schematic MAP.kicad_sch, ${Project_Name}]

Parts:
C1: 100n_50V_X7R; C_0603_1608Metric; Manufacturer Part Number CC0603KRX7R9BB104
U20: MPXH6400A; PRESSURE_8-SSOP; Manufacturer Part Number MPXHZ6400AC6T1; LCSC C511770

Connections:
+5VA: C1.1, U20.2 (Vcc); also elsewhere on the board
IN_MAP_ONBOARD: U20.4 (Vout); also elsewhere on the board

Notes on the sheet:
On-board MAP sensor, as rusEFI AlphaX-4chan (MAP.kicad_sch): NXP MPXHZ6400AC6T1, 20-400 kPa absolute, 5 V from +5VA, 100 nF at Vs, Vout straight to M1 IN_MAP3 (S19). The M1 input has its own divider and filter. Firmware: map.sensor.hwChannel = H144_IN_MAP3, type MT_MPXH6400. Run a hose from the por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

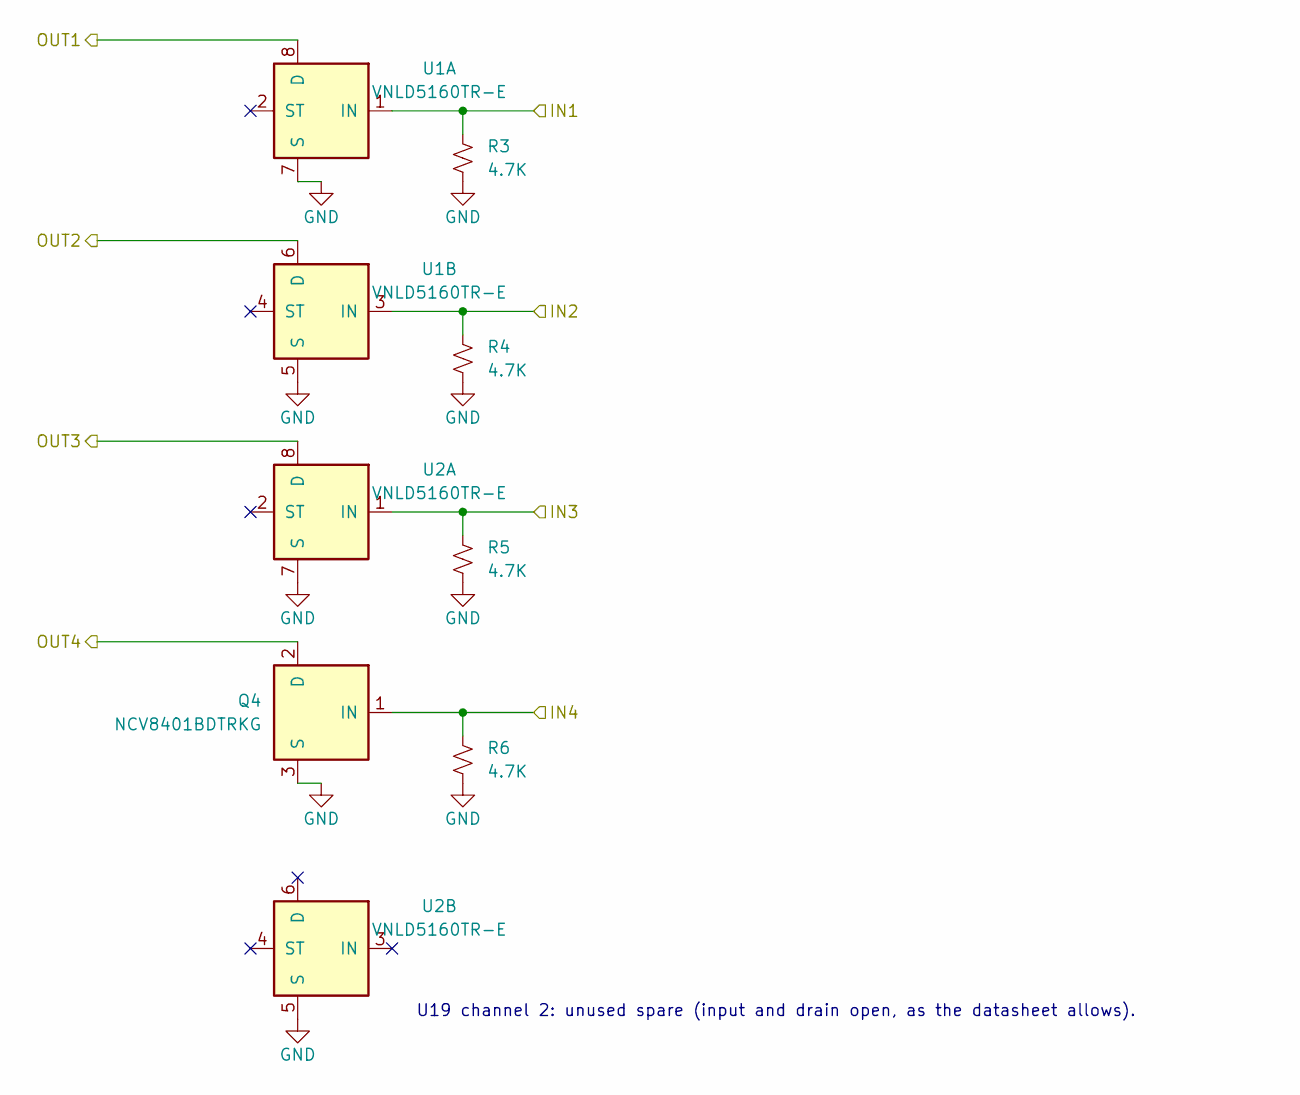
[picture p53: schematic LS_MIX.kicad_sch, ${Project_Name}]

Parts:
Q4: NCV8401BDTRKG; TO-252-2; Manufacturer Part Number NCV8401BDTRKG
R3, R4, R5, R6: 4.7K; R_0603_1608Metric; Manufacturer Part Number RC0603FR-074K7L; LCSC C99782
U1, U2: VNLD5160TR-E; SOIC-8_3.9x4.9mm_P1.27mm; Manufacturer Part Number VNLD5160TR-E; LCSC C377942

Parts of its further copies:
Q16: NCV8401BDTRKG; TO-252-2; Manufacturer Part Number NCV8401BDTRKG
R7, R8, R9, R10, R11, R12, R13, R14, R15, R16, R17, R18, R19, R20, R21, R22: 4.7K; R_0603_1608Metric; Manufacturer Part Number RC0603FR-074K7L; LCSC C99782
U10, U11, U12, U13, U14, U15, U16, U17, U18, U19: VNLD5160TR-E; SOIC-8_3.9x4.9mm_P1.27mm; Manufacturer Part Number VNLD5160TR-E; LCSC C377942

Connections of its further copies:
AC_RELAY: R15.1, U18.1 (IN); also elsewhere on the board
CRUISE_MAIN_LIGHT: R19.1, U16.1 (IN); also elsewhere on the board
CRUISE_SET_LIGHT: R20.1, U16.3 (IN); also elsewhere on the board
ELECTRONIC_THROTTE_RELAY: R10.1, U13.3 (IN)
FAN_RELAY_1: R8.1, U12.3 (IN); also elsewhere on the board
FAN_RELAY_2: R9.1, U13.1 (IN); also elsewhere on the board
MAIN_RELAY: R7.1, U12.1 (IN); also elsewhere on the board
MIL: R21.1, U17.1 (IN); also elsewhere on the board
OUT_AC_RELAY: U18.8 (D); also elsewhere on the board
OUT_CRUISE_MAIN_LIGHT: U16.8 (D); also elsewhere on the board
OUT_CRUISE_SET_LIGHT: U16.6 (D); also elsewhere on the board
OUT_ELECTRONIC_THROTTE_RELAY: U13.6 (D); also elsewhere on the board
OUT_FAN_RELAY_1: U12.6 (D); also elsewhere on the board
OUT_FAN_RELAY_2: U13.8 (D); also elsewhere on the board
OUT_INJ1: U10.8 (D); also elsewhere on the board
OUT_INJ2: U10.6 (D); also elsewhere on the board
OUT_INJ3: U11.8 (D); also elsewhere on the board
OUT_INJ4: U11.6 (D); also elsewhere on the board
OUT_MAIN_RELAY: U12.8 (D); also elsewhere on the board
OUT_MIL: U17.8 (D); also elsewhere on the board
OUT_O2_HEATER_REAR: Q16.2 (D); also elsewhere on the board
OUT_PURGE_CONTROL: U15.6 (D); also elsewhere on the board
OUT_SPARE_LS1: U18.6 (D); also elsewhere on the board
OUT_SPARE_LS2: U19.8 (D); also elsewhere on the board
OUT_TACH: U17.6 (D); also elsewhere on the board
OUT_VVT_LH-: U15.8 (D); also elsewhere on the board
OUT_VVT_RH-: U14.6 (D); also elsewhere on the board
OUT_WG: U14.8 (D); also elsewhere on the board
PURGE: R14.1, U15.3 (IN); also elsewhere on the board
SPARE_LS1: R16.1, U18.3 (IN); also elsewhere on the board
TACH: R22.1, U17.3 (IN); also elsewhere on the board
VVT_LH: R13.1, U15.1 (IN); also elsewhere on the board
VVT_RH: R12.1, U14.3 (IN); also elsewhere on the board
WG: R11.1, U14.1 (IN); also elsewhere on the board

Notes on the sheet:
U19 channel 2: unused spare (input and drain open, as the datasheet allows).

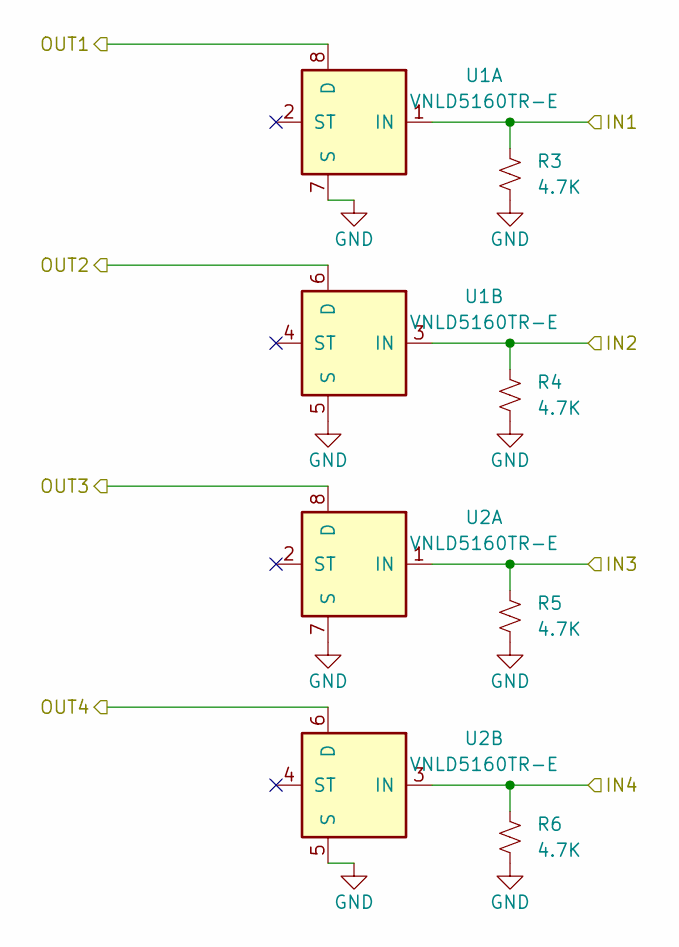
[picture p54: schematic LS_VNLD.kicad_sch, ${Project_Name}]

Parts:
R3, R4, R5, R6: 4.7K; R_0603_1608Metric; Manufacturer Part Number RC0603FR-074K7L; LCSC C99782
U1, U2: VNLD5160TR-E; SOIC-8_3.9x4.9mm_P1.27mm; Manufacturer Part Number VNLD5160TR-E; LCSC C377942

Parts of its further copies:
R7, R8, R9, R10, R11, R12, R13, R14, R15, R16, R17, R18, R19, R20, R21, R22: 4.7K; R_0603_1608Metric; Manufacturer Part Number RC0603FR-074K7L; LCSC C99782
U10, U11, U12, U13, U14, U15, U16, U17, U18, U19: VNLD5160TR-E; SOIC-8_3.9x4.9mm_P1.27mm; Manufacturer Part Number VNLD5160TR-E; LCSC C377942

Connections of its further copies:
AC_RELAY: R15.1, U18.1 (IN); also elsewhere on the board
CRUISE_MAIN_LIGHT: R19.1, U16.1 (IN); also elsewhere on the board
CRUISE_SET_LIGHT: R20.1, U16.3 (IN); also elsewhere on the board
ELECTRONIC_THROTTE_RELAY: R10.1, U13.3 (IN)
FAN_RELAY_1: R8.1, U12.3 (IN); also elsewhere on the board
FAN_RELAY_2: R9.1, U13.1 (IN); also elsewhere on the board
MAIN_RELAY: R7.1, U12.1 (IN); also elsewhere on the board
MIL: R21.1, U17.1 (IN); also elsewhere on the board
OUT_AC_RELAY: U18.8 (D); also elsewhere on the board
OUT_CRUISE_MAIN_LIGHT: U16.8 (D); also elsewhere on the board
OUT_CRUISE_SET_LIGHT: U16.6 (D); also elsewhere on the board
OUT_ELECTRONIC_THROTTE_RELAY: U13.6 (D); also elsewhere on the board
OUT_FAN_RELAY_1: U12.6 (D); also elsewhere on the board
OUT_FAN_RELAY_2: U13.8 (D); also elsewhere on the board
OUT_INJ1: U10.8 (D); also elsewhere on the board
OUT_INJ2: U10.6 (D); also elsewhere on the board
OUT_INJ3: U11.8 (D); also elsewhere on the board
OUT_INJ4: U11.6 (D); also elsewhere on the board
OUT_MAIN_RELAY: U12.8 (D); also elsewhere on the board
OUT_MIL: U17.8 (D); also elsewhere on the board
OUT_PURGE_CONTROL: U15.6 (D); also elsewhere on the board
OUT_SPARE_LS1: U18.6 (D); also elsewhere on the board
OUT_SPARE_LS2: U19.8 (D); also elsewhere on the board
OUT_TACH: U17.6 (D); also elsewhere on the board
OUT_VVT_LH-: U15.8 (D); also elsewhere on the board
OUT_VVT_RH-: U14.6 (D); also elsewhere on the board
OUT_WG: U14.8 (D); also elsewhere on the board
PURGE: R14.1, U15.3 (IN); also elsewhere on the board
SPARE_LS1: R16.1, U18.3 (IN); also elsewhere on the board
TACH: R22.1, U17.3 (IN); also elsewhere on the board
VVT_LH: R13.1, U15.1 (IN); also elsewhere on the board
VVT_RH: R12.1, U14.3 (IN); also elsewhere on the board
WG: R11.1, U14.1 (IN); also elsewhere on the board

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
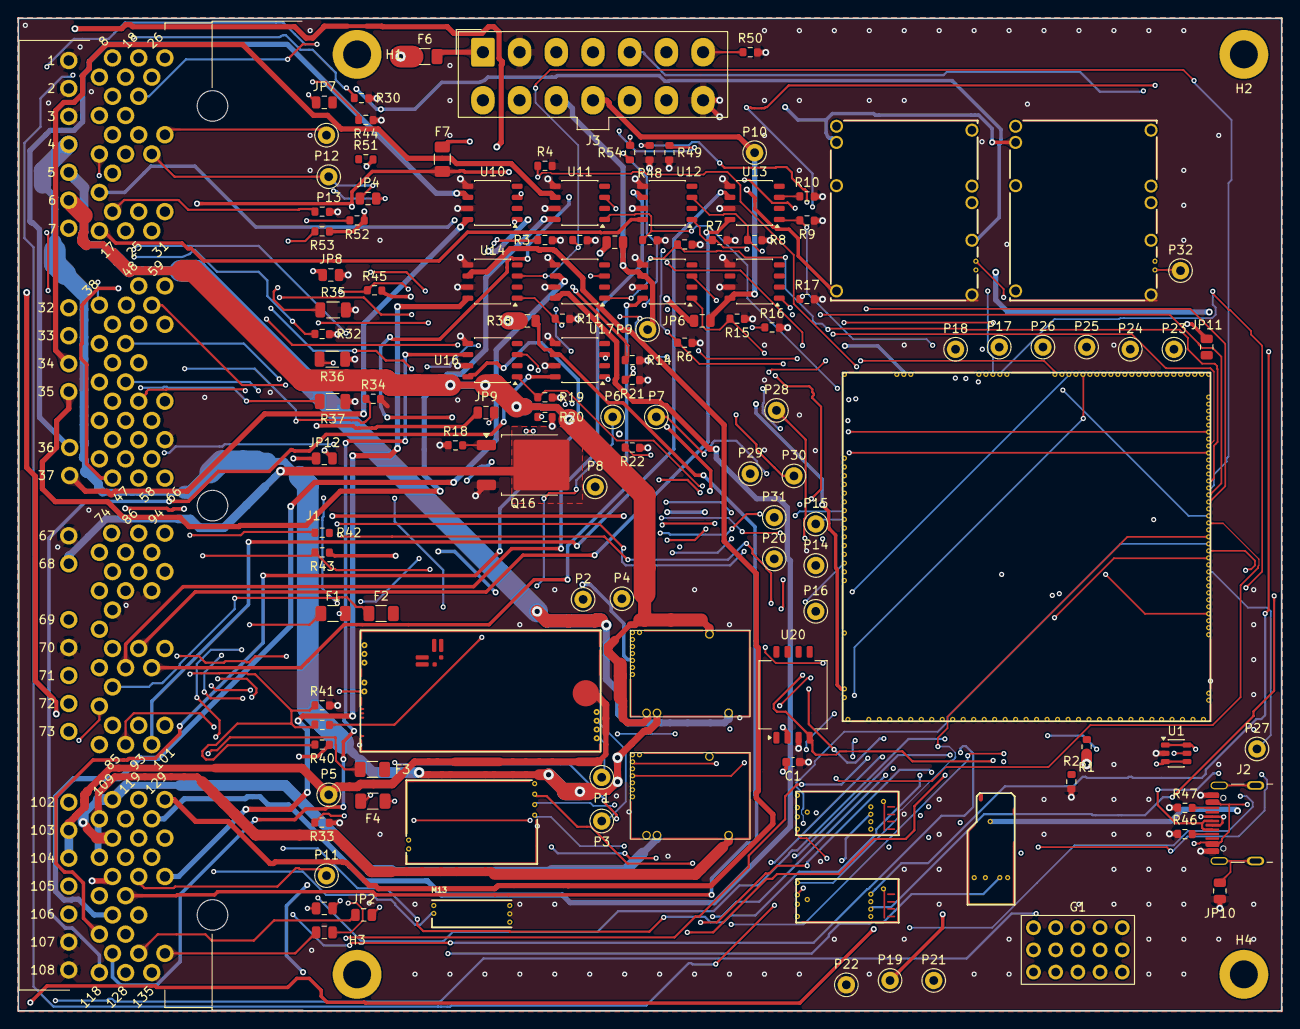
[picture p55: board rusefiSTI2004.kicad_pcb from above]

Board: 6 copper layers, 144.6 x 113.6 mm, 130 parts (0 on the bottom side), 167 nets.
