angelEmbeddedEra/rusefi-sti-2004/(commit log)

2025-02-17 test
    added a few modules
    [rusefiSTI2004.kicad_pcb, rusefiSTI2004.kicad_sch]
2025-02-19 IGN,INJ AND ETB WIRED
    wip WORKED ON IGNITION AND INJECTORS,etb
    [INJ4.kicad_sch, pinout-ECU.xlsx, rusefiSTI2004.kicad_pcb, rusefiSTI2004.kicad_sch]
2025-02-19 started laying it out
    quick layout
    [rusefiSTI2004.kicad_pcb, rusefiSTI2004.kicad_sch]
2025-02-19 test2
    added silk
    [rusefiSTI2004.kicad_pcb]
2025-02-19 test3
    silk3
    [rusefiSTI2004.kicad_pcb]
2025-02-19 [skip actions] Auto-generated board v2.1
    [rusefiSTI2004-B_Cu.gbl, rusefiSTI2004-B_Mask.gbs, rusefiSTI2004-B_Paste.gbp, rusefiSTI2004-B_Silkscreen.gbo, rusefiSTI2004-Edge_Cuts.gm1, rusefiSTI2004-F_Cu.gtl, rusefiSTI2004-F_Mask.gts, rusefiSTI2004-F_Paste.gtp]
2025-02-19 test4
    test
    [bom_replace_rusefiSTI2004-a.csv, rusefiSTI2004.kicad_sch]
2025-03-13 GHA says update kicad6-libraries
2026-10-13 rev b: fix schematic wiring errors
    - Ignition: MCU IGN3/IGN4 were labelled OUT_IGN1, shorting coils 1/3/4
    together and leaving coil 3/4 fuses undriven. Each IGN now goes to its own coil.
    - ETB: labels at the motor driver were in PWM/DIR/DIS order but the module
    pins are DIS/PWM/DIR. OUT_PWM2 (timer) now drives PWM, IO1 -> DIR, IO2 -> DIS.
    - OUT_INJ7 and OUT_INJ8 were both tied to FAN_RELAY_2. INJ8 is now free.
    - Second VR module (M6) was paralleled on the crank. It now reads the LH cam
    (B8) into IN_CAM, with its own threshold (OUT_PWM3) and analog (IN_RES2);
    VR- goes to ground since the cam sensor is single-ended.
    - Sensor 5V (APS C15, sensor C16) was floating. Both now fed from the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
2026-10-13 Pinout cross-check against the 2004 STI FSM; tidy documents
    - documents/oem-ecm-pinout-2004-sti.csv: all 135 ECM terminals from the FSM I/O table (EN(STi)-18..22) and wiring diagrams (WI-106/107), with page refs; FSM misprints for IG#4 (B15) and A/C relay (B33) resolved from the wiring diagram
    - tools/pinout_check.py: reads J1 nets via kicad-cli, compares to the car, writes documents/STI2004-pinout-check.xlsx with GridCraft (self-test included)
    - documents/README.md + STI2004-pinout-findings.docx (WordCraft): index and findings (MAF/MAP swapped on C22/C23, floating injector ground D7, pin 22 on crank-, clutch named IN_CLT, 16 label-only nets, 34 car pins not wired)
    - FSM PDFs moved to docume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
2026-10-13 Pinout: apply independent verification (A22 wired to charging, Denso 4-wire A/F, D29 source)
    A second read-only agent rebuilt all 135 terminals from the FSM: 134/135 agreed. A22 is not spare (WI-111, to CHG-01); front A/F is a Denso 4-wire sensor with A2+A3 joined to the heater (WI-113); D29 goes to DLC pin 6 (WI-112). README records the model-year evidence and the rusEFI 2005 pinout's D14/D15 and B26/B27 swaps to meter on the car.
2026-10-13 Rev b wiring: fix pinout errors, wire the car's needed signals
    Wrong before (from the FSM cross-check):
    - MAF/MAP swapped: C23 -> IN_MAF (IN_SENS1), C22 -> IN_MAP (IN_MAP1)
    - D7 injector ground floating -> GND; A34 -> GND; stray D22 removed from IN_CRANK-
    - A1 clutch was IN_CLT (rusEFI coolant) -> IN_CLUTCH
    Cams are 3-wire Hall (WI-114), not VR: M6 off the LH cam; B8 -> IN_CAM, B9 -> IN_AUX1.
    Newly wired: neutral/PS (IN_AUX2/3), starter, A/C request, brake 1/2, clutch on 340k inputs with 4.7k pull-downs (R19-R23); TGV pots (IN_MAP2/3); fuel level (IN_AT1); rear O2 (IN_O2S); FPCU command B26 <- IGN5 (5 V PWM).
    Two more INJ4 low-side sheets (LS2/LS3, Q9-Q16): wastegate, AVCS RH/LH (-) on OUT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
2026-10-13 LSU 4.9, K-line, cruise, and option footprints for every uncertain circuit
    - Front O2: Bosch LSU 4.9 on the WBO module (M3), wired as rusefi/hellen154hyundai (H- GND, H+ switched heater return to A2+A3, SEL1 to PULL_DOWN1, CAN to M1). Un/Vm/Ip reach the stock harness A33/A26/A25 through fitted 0R JP1-JP3; pads P1-P7 for a direct pigtail and external CAN. Adapter-pin table in documents/README.md.
    - K-line: Hellen LIN module M10 on UART8, D20; D29 (DLC pin 6) behind open JP4.
    - Cruise: main/resume/set C7/C10/C11 -> IN_D1/3/4 with 1k 1206 pull-downs; lamps A15/A16 on a 4th low-side sheet (LS4, Q17-Q20); its 2 spare channels reach EVAP A12/A13 through open JP5/JP6.
    - Options (DNP, listed in bom_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
2026-10-13 Fix board blockers; USB, boot/SWD, 8 more inputs via dinput4
    Blockers found in the completeness review:
    - M1 module ground GND_G was unconnected -> GND
    - F5 JK-nSMD005 (50 mA PTC) in series with the throttle motor supply -> removed, D6 feeds +12V_ETB directly (car fuses the ETB relay feed)
    - no USB at all -> J2 mini-B (C13453) on M1 USB D+/D-/VBUS/ID; BOOT0 pad + open JP10 to 3.3 V (DFU), SWD pads
    Inputs: two Hellen dinput4 modules (M11, M12) on spare 5 V-tolerant GPIOs: defogger D11, small lights D12, blower/A-C D13, test mode D14, blow-by D24, and three aux inputs on pads (launch/2-step, map switch, spare) with pull-up/down options. I2C expander considered: rusEFI has no I2C input-expande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
2026-10-13 Own 5 V for the pedal, CAN terminator option, Mini-Fit Jr aux connector
    - Pedal supply C15 (APS_PS_5V) now from the second power module M8's protected 5 V; C16 sensor 5 V stays on M14. M8 fed like M14 (+12V_RAW, +12V_IGN, +12V_BACK_UP, PWR_EN). Open JP11 falls back to +5VAS; M8 power-good on pad P32.
    - CAN: M1 terminates internally (R100 120R); WBO has none. R52 120R (DNP) at the aux connector for an external bus end.
    - J3 aux connector, Molex Mini-Fit Jr 5566-14A 2x7 vertical (39281143): +12 V via F6 0.5 A PTC, +5 V sensor via F7 50 mA PTC, sensor ground, AUX_IN1-3 (launch/2-step, map switch, spare), AUX_AN1 (IN_RES2), AUX_AN2 (IN_AT2, shared with the FPCU status option), two low-side outpu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
2026-10-13 No overlapping text; USB-C; KiCad 8 compatibility checked
    - tools/sch_overlap_check.py: fails on any label/field/sheet text overlapping other text or a symbol body (KiCad stroke-font estimate, field angles relative to the symbol).
    - Layout rules in the generator: power symbols point along their wire with horizontal names; adjacent same-rail pins share one symbol; labels follow pin direction; module names above the body; small parts placed by a collision-checked search; a final pass moves any touching field; the build fails unless overlaps = 0. Original-sheet overlaps fixed too.
    - USB: J2 is now the EmbeddedEra library USB-C (HRO TYPE-C-31-M-12, C165948) with 5.1k CC pull-downs, USBLC6-2SC6 E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
2026-10-13 Split the schematic into functional sheets with notes
    Root page is now an overview (block per sheet, how to read it). Sheets: Vehicle connector (J1, all four plugs), Power (M14, M8 pedal 5 V), MCU and USB, Sensors, Switch inputs, Outputs (low-side sheets INJ/LS1-LS4 nested here, throttle, TGV, fuel pump), Comms (LSU 4.9 WBO, K-line, CAN), Aux and expansion (J3, spares, proto area). Each sheet opens with a note on what it holds and why.
    Labels that name a net are global labels (pointing away from their wire); descriptive labels on power nets stay local so GND keeps its name. tools/options_table.py generates the option-parts table in documents/README.md from the schematic.
    Verified: connecti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
2026-10-13 Schematic PDF (all sheets) for review without KiCad
2026-10-13 EmbeddedEra libraries and template, KiCad 10
    - Every symbol except the nine Hellen-One modules now comes from the EmbeddedEra library (resistors and 0R links from the generic libraries, PTC fuses, VND14NV04-E, TE 1-1376430-0, Molex 39281143, test pads, proto area, power symbols). Same-pin parts swapped in place; resistors re-placed between their old pin points with short wires. New parts live on library branch sti2004-parts.
    - EmbeddedEra project template: worksheet, text variables, net classes with explicit power classes, JLCPCB design rules; template net names for USB, I2C and the K-line UART.
    - Migrated all sheets and the board to KiCad 10 (10.0.7).
    - tools/sch_overlap_check.py also fails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
2026-10-13 Build the board on our machine with KiCad 10
    - tools/create-board.sh runs the Hellen export in kicad/kicad:10.0.5 and the
    hellen-one merge steps in docker; replaces the GitHub workflows (removed).
    - hellen-one submodule bumped to upstream master (KiCad 10 export.sh).
    - bom_replace renamed to rev b to match revision.txt.
2026-10-13 Remove unused M7 knock module and a stray plug note; checker models KiCad's field-justify flip
    - M7 (second knock module) had no pin connected; the STI has one knock sensor (C25) on M13.
    - 'D: B137' free text (rev-a leftover) duplicated J1's own plug label and sat on the Aux sheet.
    - sch_overlap_check: KiCad draws a field's left/right justification mirrored for some
    angle/rotation/mirror combinations (measured from kicad-cli 10 PDF output); the checker now
    boxes those fields where KiCad draws them.
2026-10-13 Tidy every sheet to house style: GND down, rails up, KiCad-autoplaced fields
    - tools/sch_tidy.py: pull resistors/links stand vertical (GND below, rail above), test points
    take their rail straight on the pin, power symbols point the house way (stacked ones share
    one symbol), Reference/Value placed like KiCad's Autoplace Fields (O). Every step keeps the
    overlap count from rising; tools/tidy-check.sh proves the netlist is unchanged.
    - Checker now also boxes power-symbol arrows (13 hidden text-on-arrow overlaps found).
    - J1: GND pins 1-3 and shields 63/64 each share one GND; F1-F4 PTCs moved to a spaced block
    joined by IGNn_COIL labels (only those four net names change, pins identical).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
2026-10-13 U1 (USBLC6) fields beside pin 5, KiCad-style; checker catches a part's own text on a small body
    - sch_tidy autoplace: a side that has pins puts the fields beside those pins (KiCad AUTOPLACER).
    - sch_overlap_check: own fields may sit inside big blocks (modules, connectors) only.
2026-10-13 U1 is the library USBLC6-2SC6 (EE-C-0146); J2 part numbers; test pads and proto area out of the BOM
    - U1 used the USBLC6-2P6 (SOT-666) symbol with a hand-changed footprint; now EmbeddedEra:USBLC6-2SC6.
    - J2 instance had no Manufacturer/MPN although the library has them.
    - P1-P32 and G1 are pads, nothing is bought (SOP-008 step 18): in_bom no, as in the library.
2026-10-13 Low-side drivers Q1-Q20: VND14NV04-E (obsolete) -> onsemi NCV8401BDTRKG
    Same DPAK pinout and TO-252-2 footprint; protected (active clamp, current limit, thermal
    shutdown), AEC-Q101, about 28 mOhm at 5 V. Netlist unchanged, 0 overlaps. Schematic PDF
    regenerated.
2026-10-13 Use the shared schematic and Hellen tools from EmbeddedEra/KiCad (kicad-tidy-check, kicad-overlap-check, hellen-create-board)
2026-10-13 PCB: update from schematic and first placement; H1-H4 M3 mounting holes; drop STI.pretty
    - kicad-pcb-from-netlist (EmbeddedEra/KiCad scripting/pcb) rebuilt the rev-a board: 137 footprints,
    linked to their symbols (DRC schematic parity 0), nets on every pad, floorplan in pcb_place.json.
    - H1-H4 added to the schematic (Aux sheet) first, then placed.
    - STI.pretty removed: the board now uses EmbeddedEra_Library:TE_1-1376430-0.
    - hellen-create-board builds the full package again (the F5 mismatch is gone).
2026-10-13 Net classes sized for current: Ground, Power_3A (TGV), Power_5A (+12V_RAW, ETB); router width/via lists
    GND had resolved to Default (0.2 mm) although it returns every low-side load; ETB motor and
    +12V_RAW were at 1.0 mm for up to ~6 A. Sensor/diag nets with path names now match Signal_Robust.
    Widths per IPC-2221, 1 oz outer, 10 C rise. kicad-pcb-from-netlist reports no thin power nets.
2026-10-13 PCB: 4 layers with In1 GND plane, all parts on top spaced for routing, JLC-size silk references
    - Hellen modules carry In1/In2 copper and the Hellen build defaults to 4 layers.
    - Board Setup floors lowered to JLC capability (0.2 mm hole, 0.15 mm hole clearance); scoped DRC
    exceptions for J2, M13 and J1 GND spokes. DRC 0 errors, parity 0.
    - Stray rev-a 'test3' board text removed.
2026-10-13 Planes: In1 GND, In2 +12V_RAW, top/bottom GND pours with stitching, DPAK drain heat spreaders with thermal vias
    DRC 0 errors, parity 0; unconnected 482 -> 326 (ground and +12V_RAW pads now join their planes).
2026-10-13 Low-side drivers sized per load: 8 DPAK (NCV8401B), 4 SOT-223 (ZXMS6006DGQ), 8 SOT-23F (ZXMS6004FF)
    INJ and LS2 stay DPAK; LS3 and LS1/LS4 use new sub-sheets with the smaller parts. Purge and the rear
    O2 heater swapped groups (LS2/LS3), spares moved to LS3, MIL/tach to LS4; every output keeps its
    J1 and MCU pin (checked on the netlist). PCB bank re-placed, planes rebuilt: DRC 0 errors, parity 0.
2026-10-13 Low-side drivers as on the newest rusEFI boards: 10 x VNLD5160 dual SO-8 + 1 NCV8401B DPAK for the rear O2 heater
    rusEFI uaefi-f, hellen-112-17 and hellen154hyundai-e use VNLD5090/VNLD5160 for general outputs and
    keep one DPAK for the heaviest load; our Hellen modules already carry their other ICs. Every output
    keeps its J1 and MCU pin (netlist checked); U19B parked as a spare. PCB re-placed: DRC 0 errors.
2026-10-13 PCB: pull-ups/downs and fuses next to the pin they serve
    Gate pull-downs at their VNLD5160/DPAK input pins, switch-input pulls in a column beside J1 at
    their pin, USB CC resistors at J2, coil PTCs at J1, aux fuses at J3. Driver bank 4x3 to free the
    column. DRC 0 errors, parity 0.
2026-10-14 Routing plan: 10 stages with nets, layers, widths and gates (documents/ROUTING-PLAN.md)
2026-10-14 Stage 2 routing: ETB, TGV, WBO and rear O2 heater paths (kicad-autoroute)
    DRC 0 errors, bends under 135 deg 0, unconnected 326 -> 320, parity 0.
    Rules: SMD pads need one thermal spoke; track_angle is a warning because
    T-junctions always trip it (bends are enforced by kicad-autoroute).
2026-10-14 On-board MAP sensor (AlphaX style): U20 MPXHZ6400AC6T1 + C1 100n on +5VA -> M1 IN_MAP3 (S19)
    TGV position RH moves from IN_MAP3 to IN_RES2 (S14). J3 pin 8 (was AUX_AN1 on
    IN_RES2) is now not connected; P28 is the MAP test pad. External MAP stays on
    IN_MAP1. PCB: U20/C1 placed left of M1, DRC 0 errors, unconnected 322.
2026-10-14 On-board MAP: root notes (MAP sheet, fixed stale/truncated notes), IN_MAP_ONBOARD net class pattern + 0.5mm keep-away DRC rule
    Rules file probe-checked (5mm probe -> 499 errors). DRC 0 errors, unconnected 322.
    Routing plan: move parts instead of necking traces; every net has a rule.
2026-10-14 Stage 2 rerouted: all 7 high-current nets routed, wider tracks; U20 out of the ETB corridor
    The 2026-10-13 pass had left OUT_ETB+ and OUT_TGV_OPEN unrouted. Routed at
    0.8 mm (fits between J1 pins), widened with local necking, small parts nudged
    off the wide tracks (F3 F4 P2 P4 R33 R34 R36 R37). U20 moves to the gap east of
    M2, C1 under its supply pins. DRC 0 errors, bends 0, unconnected 324.
2026-10-14 Step 0 done (stackup JLC04161H-7628, anchors locked, enclosure 3D printed) and ETB necks doubled on the other layer
    DRC 0 errors, unconnected 324.
2026-10-14 Step 1 plane fan-out: 66 vias on GND/+12V_RAW SMD pads, J1 120-119 tie on In2
    DRC 0 errors, unconnected 318; +12V_RAW fully connected. Remaining GND items are
    Hellen module internal pads (joined by the module copper at merge) and one pour scrap.
2026-10-14 Fix: restore stage 2 and plane fan-out lost in ef3e072, keep the 19 low-side outputs
    KiCad's ImportSpecctraSES replaced all routing with the session, and the session
    only held the nets being routed, so ef3e072 had lost the ETB/TGV/heater tracks and
    the 66 fan-out vias. Rebuilt from c86fc28 plus the OUT_* copper of ef3e072,
    OUT_INJ3 rerouted (a chamfer had hit a fan-out via), one WBO_HEATER corner cut.
    Checked per net against c86fc28: no net worse except GND +1 (pour island near J1).
    DRC 0 errors, bends 0, unconnected 295.
2026-10-14 Step 3b driver inputs: 15 of 20 routed (pull-down -> M1); 5 blocked at the M1 east edge
    M1's east edge carries 34 signals into a 2.15 mm strip to the board edge; PURGE,
    SPARE_LS1, TACH, VVT_RH, WG do not fit. DRC 0 errors, bends 0, no other net worse.
2026-10-14 Board 6 mm wider on the right (now 144.6 x 113.6 mm) so M1's east-side signals have room
    J2 (USB-C) with U1/R46/R47/JP10/P27 and their fan-out, H2 and H4 move with the
    edge; the plane pours stretch. DRC 0 errors, no net worse, unconnected 280.
2026-10-14 Step 3 done: 20 driver inputs routed (5 into the new right-edge room), teardrops written
    J1 63-64 GND tie on In1, J3 pin 14 fan-out, WG rerouted. 424 teardrops via kicad-cli.
    DRC 0 errors, bends 0, per-net guard clean, unconnected 274.
2026-10-14 Step 5a: In2 becomes mixed; +12V_RAW routed as tracks first (F/In2/B), MAP keep-away scoped to power nets
    Every +12V_RAW pad is joined by track with the pour removed (0 opens), so later
    signals on In2 cannot cut 12 V off. DRC 0 errors, bends 0, unconnected 274.
2026-10-14 Step 5b: 32 of 34 analog nets routed on F/In2/B (crank, cam, sensors, WBO, MAP)
    APS_PS_5V and IN_KNOCK_RAW still open. DRC 0 errors, per-net guard clean, unconnected 233.
2026-10-14 Step 5d: IN_KNOCK_RAW routed; all 34 analog nets done
    The router could not see that J1 pads and vias have no ring on In2; the DSN now
    exports them hole-sized (plus the track-to-PTH-hole margin), and M13 W1 10 um
    smaller to clear its in-module neighbour. DRC 0 errors, no other net worse.
2026-10-14 GND stitching (94 vias, 4 mm grid) ties the outer pours to In1; USB2 class 0.25 mm / 0.15 mm gap (~92 ohm diff by microstrip formula)
    DRC 0 errors, unconnected 233 -> 229.
2026-10-14 Step 5 USB: USB_D+/D- routed (J2 -> U1 ESD -> M1), 14 GND island vias where the new tracks cut the pours
    DRC 0 errors, no net worse, unconnected 213.
2026-10-14 Step 7a: low-current rails, first pass (304 segments); 23 rail connections still open. DRC 0, unconnected 186
2026-10-14 Steps 6-8 first pass: 1166 segments on the remaining rails, switch inputs, motor/ignition control and debug nets; K-line rerouted round J1 pin 12
    44 real connections still open. DRC 0 errors, no net worse than 9f27e19.
2026-10-15 Board goes to 6 layers (owner): In3 signals, In4 solid GND, JLC06161H-7628 stackup; In3/In4 keepouts over every Hellen module
    DRC 0 errors, no net worse, 44 real connections still open.
2026-10-15 In3/In4 keepouts only around the Hellen modules' own vias (802, from each module's drill file, pins matched 100%) instead of whole outlines
    DRC 0 errors. IN_NEUTRAL_SWITCH shows one open with identical copper; it goes into the next routing run.
2026-10-15 Routing with In3 under the modules: 44 -> 24 real open connections; EVAP_A13 via nudged 0.12 mm off the ETB relay track
    DRC 0 errors, no net worse than the previous commit. IN_DEFOG and 15 small-signal/rail nets still open.
2026-10-29 M1 pin swap within module pin families (owner-approved); moved nets' copper ripped for re-routing
    Claude-Session: https://claude.ai/code/session_01Wvm7Ln3a66CJUfUkcDdYMo
2026-10-29 Re-route the 32 swapped nets with eeroute: 7 open (master 8, unswapped 22); board unconnected 123 -> 102
    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
2026-10-29 Board back in KiCad 10 file format (20260206): routed copper and pad nets carried onto master's text
    The previous two commits were saved by the KiCad-master kicad-cli in format 20260901, which KiCad 10
    cannot open. Same copper, same DRC (101 unconnected, identical findings).
    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
