angelEmbeddedEra/rusefi-sti-2004/(notices)

Notices in the files:
parts and their libraries:
Power symbol creates a global label with name \"+12V\". Copied from KiCad library power:+12V (KiCad 10.0), CC-BY-SA 4.0 with the KiCad library exception.
